sharpiestealr/mono/component pics/motor w.png

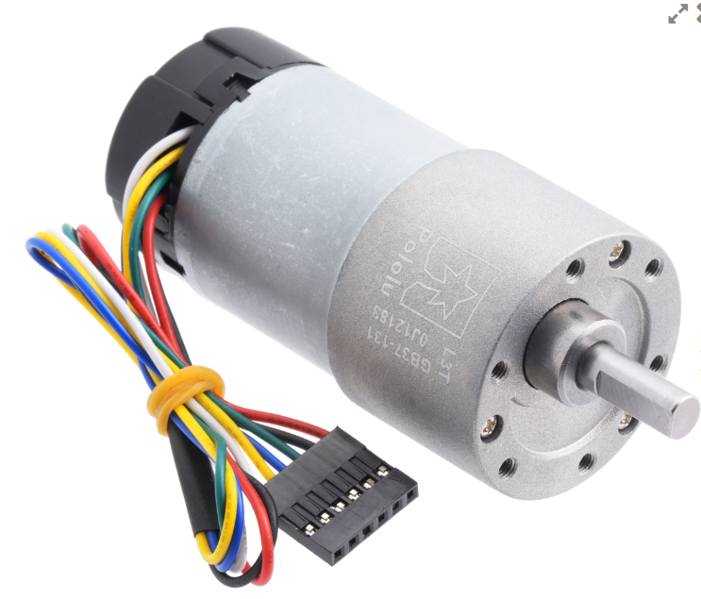
component pics/motor w.png
