sharpiestealr/mono/component pics/imu.png

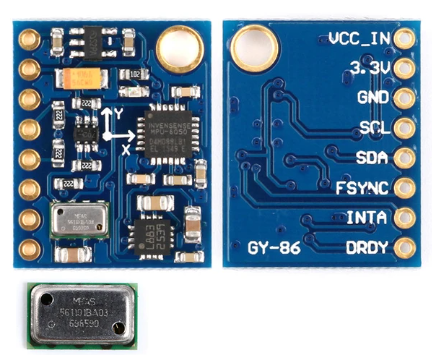
component pics/imu.png
