sharpiestealr/mono/README.md

# mono
matemáticas do menino moço monociclo

:)
