sharpiestealr/mono/cad/mancal interno/1 - faceamento.pdf

### Summary of cutting data for Plain surface

Material details
AISI/SAE, 1045, Hardness: 207 HB, Material group:P1.2.Z.AN

Task details

Operation type | Finishing
System stability | Excellent stability
Width | 3.5 mm
Length | 38.1 mm
Allowance depth of cut bottom | 0.35 mm
Ra bottom | 3.2 µm

Plain surface

Tool | M5009-040-T36-04-06-AP
Type | Body
No. of pieces | 1
Description | Xtratec XT
Image similar
Tool | SNMX1205ANN-F27 WKP35S
Type | Insert periphery (A) INS_A
No. of pieces | 4

Image similar

Machining | Type of cooling | Description | Grade | Tmf [min:s]
Face Milling | Dry | Xtratec XT | WKP35S | 00:01.458

Recommended solution

i-PAC 24-1, Walter GPS 6.7.7 (24.6.0.9476) | 1 From 2 | 7/15/2024

Summary of cutting data for Plain surface

Cutting data

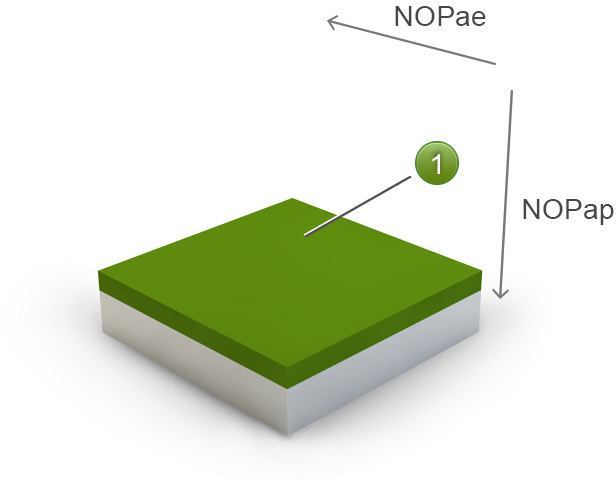
[picture p32: figure]

Working engagement (ae) | 3.5 | mm
Depth of cut (ap) | 0.35 | mm
Number of passes in AE direction (NOPae) | 1
Number of passes in AP direction (NOPap) | 1
Cutting speed (vc) | 348 | m/min
Spindle speed (n) | 2680 | 1/min
Feed per tooth (fz) | 0.3 | mm
Feed speed at the contour (vfe) | 3220 | mm/min
Cutting power (Pc) | 0.339 | kW
Cutting torque (Mc) | 1.21 | Nm
Maximum chip thickness (hex) | 0.0406 | mm
Material removal rate (Q) | 3.94 | cm3/min
Total cutting time (Tc tot) | 00:01.458 | min:s
Tool life length (LifeLength) | 148.28 | m
Tool life time (LifeTime) | 46 | min

Finishing

Legend

i-PAC 24-1, Walter GPS 6.7.7 (24.6.0.9476) | 2 From 2 | 7/15/2024

DECLARATION OF EXCLUSION
The program is used at the user's own risk. Walter AG accepts no guarantee or warranty whatsoever for the suitability of the program or for its efficiency, especially the correctness of the calculations. Walter AG accepts no liability for the trouble- and faultfree use of the program. The risk is borne by the user
Liability of any kind on the part of Walter AG and its employees for damage, detriment and expenditure of any kind, particularly including financial and data losses amongst others, such as may arise for the user or third parties as a result of, or in connection with the use or non-applicability of the program, is ruled out. This exclusion of liability does not apply if and in so far as such damage, detriment and expenditure is found to be due to intentional or grossly negligent behaviour on the part of Walter AG employees.

Summary of cutting data for Plain surface
