sharpiestealr/mono/cad/mancal interno/2 - furação.pdf

### Summary of cutting data for Hole on solid material

Material details
AISI/SAE, 1045, Hardness: 207 HB, Material group:P1.2.Z.AN

Task details

Applicability for through hole | Yes
Diameter | 22 mm
Tolerance class
Depth | 8 mm
System stability | Excellent stability

Hole on solid material

Tool | MC232-16.0W3BC-WJ30ED
Type | Body
No. of pieces | 1
Description | Perform
Image similar
Machining | Type of cooling | Description | Grade | Tmf [min:s]
Pocket milling | Dry | Perform | WJ30ED | 00:10.080

Recommended solution

i-PAC 24-1, Walter GPS 6.7.7 (24.6.0.9476) | 1 From 2 | 7/15/2024

Summary of cutting data for Hole on solid material

Cutting data

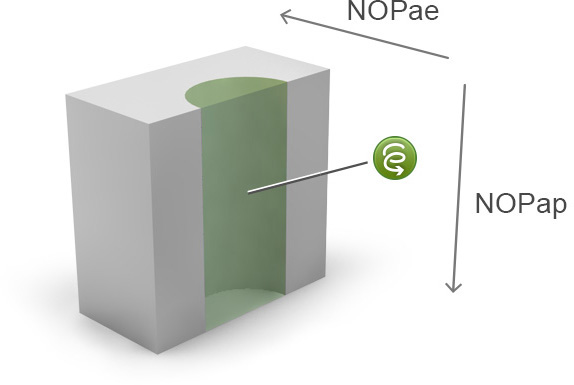
[picture p33: figure]

Working engagement (ae) | 11 | mm
Depth of cut (ap) | 4 | mm
Number of passes in AE direction (NOPae) | 1
Number of passes in AP direction (NOPap) | 2
Start diameter (Dms) | 22 | mm
Effective ramping angle (RMPangle) | 12 | °
Cutting speed (vc) | 169 | m/min
Spindle speed (n) | 3370 | 1/min
Feed per tooth (fz) | 0.0815 | mm
Feed speed at the contour (vfe) | 824 | mm/min
Feed speed in the tool centre (vf) | 225 | mm/min
Cutting power (Pc) | 1.18 | kW
Cutting torque (Mc) | 3.35 | Nm
Maximum chip thickness (hex) | 0.0815 | mm
Material removal rate (Q) | 9.89 | cm3/min
Total cutting time (Tc tot) | 00:10.080 | min:s
Tool life length (LifeLength) | 50.31 | m
Tool life time (LifeTime) | 61 | min

Helical Milling

Legend

i-PAC 24-1, Walter GPS 6.7.7 (24.6.0.9476) | 2 From 2 | 7/15/2024

DECLARATION OF EXCLUSION
The program is used at the user's own risk. Walter AG accepts no guarantee or warranty whatsoever for the suitability of the program or for its efficiency, especially the correctness of the calculations. Walter AG accepts no liability for the trouble- and faultfree use of the program. The risk is borne by the user
Liability of any kind on the part of Walter AG and its employees for damage, detriment and expenditure of any kind, particularly including financial and data losses amongst others, such as may arise for the user or third parties as a result of, or in connection with the use or non-applicability of the program, is ruled out. This exclusion of liability does not apply if and in so far as such damage, detriment and expenditure is found to be due to intentional or grossly negligent behaviour on the part of Walter AG employees.

Summary of cutting data for Hole on solid material
