sharpiestealr/mono/cad/eixo/3 - sangramento.pdf

### Summary of cutting data for Parting of bar

Material details
AISI/SAE, 1045, Hardness: 207 HB, Material group:P1.2.Z.AN

Task details

Start diameter | 25.4 mm
Cutting width | 3 mm
Minimum cutting width | 3 mm
Maximum cutting width | 3 mm
Cutting condition | Continuous cut
Workpiece surface condition | Pre-machined
System stability | Excellent stability

Parting of bar

Subject: monociclo

sangramento

To
eixo

Centur 30D

Machine

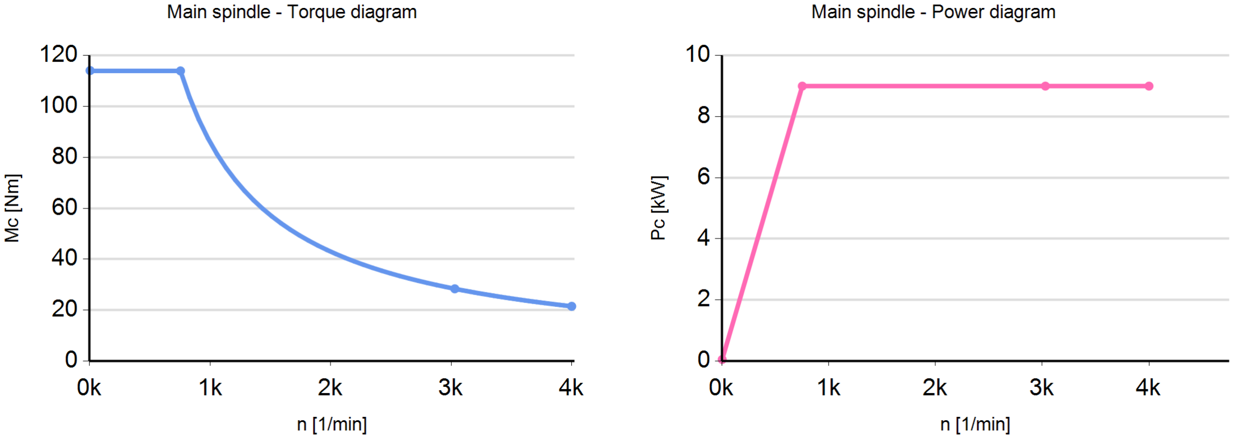
[picture p34: figure]

Machining | Type of cooling | Coolant | Grade | Tmf [min:s] | Adaption type
Parting off | External | Emulsion 10% | | 00:02.814 | Walter parting off and grooving blade -size 26

Recommended solution

i-PAC 23-2, Walter GPS 6.7.5 (24.3.0.8847) | 1 From 2 | 4/12/2024

Summary of cutting data for Parting of bar

Cutting data

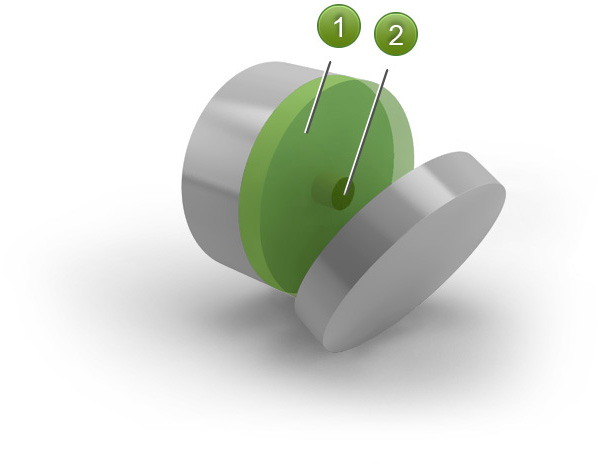
[picture p35: figure]

Number of passes in AP direction (NOPap) | 1 | 1 | NOPap
Start diameter (Dms) | 25.4 | 4.5 | mm
End diameter (Dme) | 4.5 | 0 | mm
Depth of cut (ap) | 3 | 3 | mm
Cutting speed (vc) | 153 | 153 | m/min
Feed per revolution (fn) | 0.116 | 0.029 | mm
Tool life time (LifeTime) | 27 | 68 | min
Tool life length (LifeLength) | 3745.17 | 1920.29 | m
Maximum chip thickness (hex) | 0.116 | 0.116 | mm
Corner radius (R) | 0.2 | 0.2 | mm

### Legend

Parting, recommended feed

Parting, reduced feed

Tool | G2042.26N-3T38SX
Type | Body
No. of pieces | 1

Image similar

Tool | SX-3E300N02-CF6 WSM33S
Type | Insert
No. of pieces | 1
Description | WALTER-Cut
Image similar
i-PAC 23-2, Walter GPS 6.7.5 (24.3.0.8847) | 2 From 2 | 4/12/2024

DECLARATION OF EXCLUSION
The program is used at the user's own risk. Walter AG accepts no guarantee or warranty whatsoever for the suitability of the program or for its efficiency, especially the correctness of the calculations. Walter AG accepts no liability for the trouble- and faultfree use of the program. The risk is borne by the user
Liability of any kind on the part of Walter AG and its employees for damage, detriment and expenditure of any kind, particularly including financial and data losses amongst others, such as may arise for the user or third parties as a result of, or in connection with the use or non-applicability of the program, is ruled out. This exclusion of liability does not apply if and in so far as such damage, detriment and expenditure is found to be due to intentional or grossly negligent behaviour on the part of Walter AG employees.

Summary of cutting data for Parting of bar
