sharpiestealr/mono/cad/peça acopladora/3 - rebaixo 6.5.pdf

### Summary of cutting data for Hole on solid material

Material details
JIS, A5052, Hardness: 55 HB, Material group:N1.2.Z.UT

Task details

Applicability for through hole | Yes
Diameter | 6.5 mm
Tolerance class
Depth | 3.5 mm
System stability | Excellent stability

Hole on solid material

Subject: monociclo

fresamento do rebaixo 6xm3

To
peça acopladora

FANUC RoboDRILL -21MiB (High Torque)

Machine

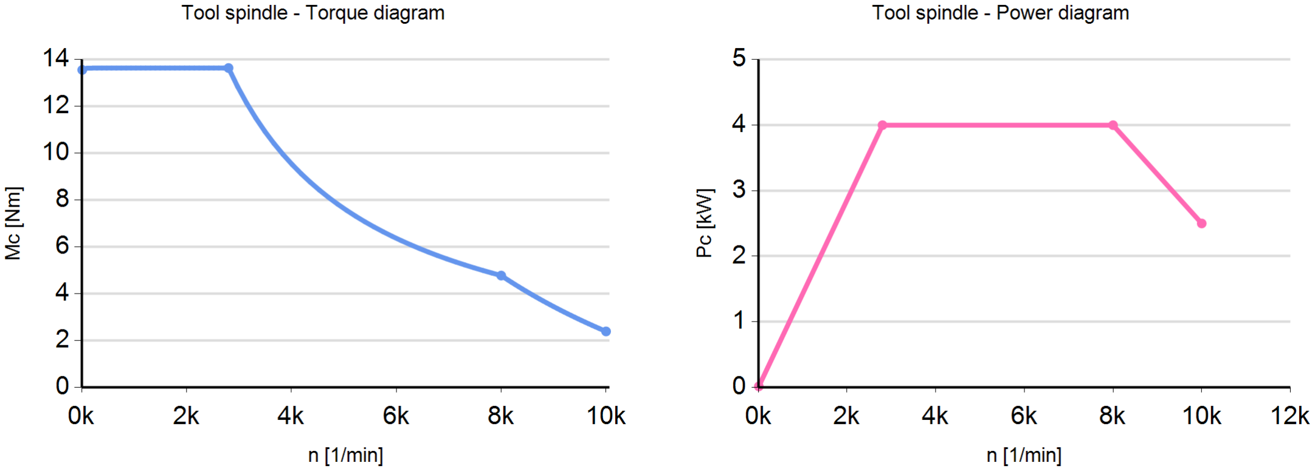
[picture p36: figure]

Tool | MC232-04.0A3B-WJ30ED
Type | Body
No. of pieces | 1
Description | Perform
Image similar
Machining | Type of cooling | Coolant | Description | Grade | Tmf [min:s]
Pocket milling | External | Emulsion 10% | Perform | WJ30ED | 00:01.860

Recommended solution

i-PAC 23-2, Walter GPS 6.7.5 (24.3.0.8847) | 1 From 3 | 4/12/2024

Summary of cutting data for Hole on solid material

MC232-04.0A3B-WJ30ED

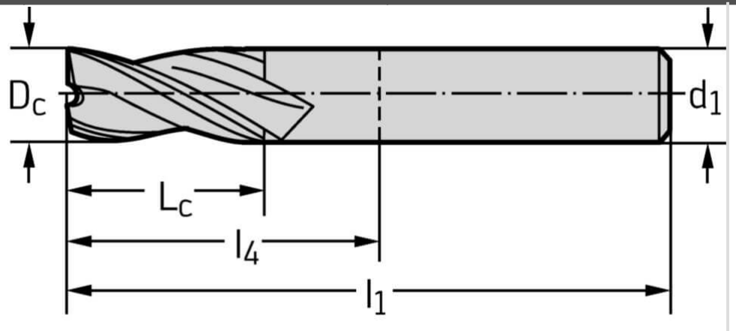
[picture p37: figure]

Product name | Perform
Standard | DIN 6527 L
Body material | Carbide
Grade | WJ30ED
Center cutting capability | true
Helix angle | 35 °
Cutting edge diameter (Dc) | 4 mm
Cutting edge diameter tolerance class | h12
Max. depth of cut (Lc) | 8 mm
Usable length (l3) | 8 mm
Overall length (l1) | 57 mm
Maximum overhang (l4) | 29 mm
Drive size (d1) | 4
Shank diameter tolerance | h6
Peripheral effective cutting edge count (Z) | 3
Calculated regrinds | 2
Price | 38.90 €
i-PAC 23-2, Walter GPS 6.7.5 (24.3.0.8847) | 2 From 3 | 4/12/2024

Cutting data


Working engagement (ar) | 3.25 | mm
Depth of cut (ap) | 1.75 | mm
Number of passes in AE direction (NOPae) | 1 | NOPae
Number of passes in AP direction (NOPap) | 2 | NOPap
Start diameter (Dms) | 6.5 | mm
Effective ramping angle (RMPangle) | 12.6 | °
Cutting speed (vc) | 120 | m/min
Spindle speed (n) | 9550 | 1/min
Feed per tooth (fz) | 0.046 | mm
Feed speed at the contour (vfe) | 1320 | mm/min
Feed speed in the tool centre (vf) | 507 | mm/min
Cutting power (Pc) | 0.0886 | kW
Cutting torque (Mc) | 0.0886 | Nm
Maximum chip thickness (hex) | 0.046 | mm
Material removal rate (Q) | 2.88 | cm3/min
Total cutting time (Tc tot) | 00:01.860 | min:s
Tool life length (LifeLength) | 739.08 | m
Tool life time (LifeTime) | 560 | min

Helical Milling

Legend

i-PAC 23-2, Walter GPS 6.7.5 (24.3.0.8847) | 3 From 3 | 4/12/2024

DECLARATION OF EXCLUSION
The program is used at the user's own risk. Walter AG accepts no guarantee or warranty whatsoever for the suitability of the program or for its efficiency, especially the correctness of the calculations. Walter AG accepts no liability for the trouble- and fault-free use of the program. The risk is borne by the user
Liability of any kind on the part of Walter AG and its employees for damage, detriment and expenditure of any kind, particularly including financial and data losses amongst others, such as may arise for the user or third parties as a result of, or in connection with the use or non-applicability of the program, is ruled out. This exclusion of liability does not apply if and in so far as such damage, detriment and expenditure is found to be due to intentional or grossly negligent behaviour on the part of Walter AG employees.
