sharpiestealr/mono/cad/peça acopladora/4 - furo 12.pdf

### Summary of cutting data for Hole on solid material

Material details
JIS, A5052, Hardness: 55 HB, Material group:N1.2.Z.UT

Task details

Applicability for through hole | Yes
Diameter | 12 mm
Tolerance class
Depth | 10 mm
System stability | Excellent stability

Hole on solid material

Subject: monociclo

fresamento furo 12mm

To
peça acopladora

FANUC RoboDRILL -21MiB (High Torque)

Machine


Tool | MC232-10.0W3BC-WJ30ED
Type | Body
No. of pieces | 1
Description | Perform
Image similar
Machining | Type of cooling | Coolant | Description | Grade | Tmf [min:s]
Pocket milling | External | Emulsion 10% | Perform | WJ30ED | 00:02.928

Recommended solution

i-PAC 23-2, Walter GPS 6.7.5 (24.3.0.8847) | 1 From 3 | 4/12/2024

Summary of cutting data for Hole on solid material

MC232-10.0W3BC-WJ30ED

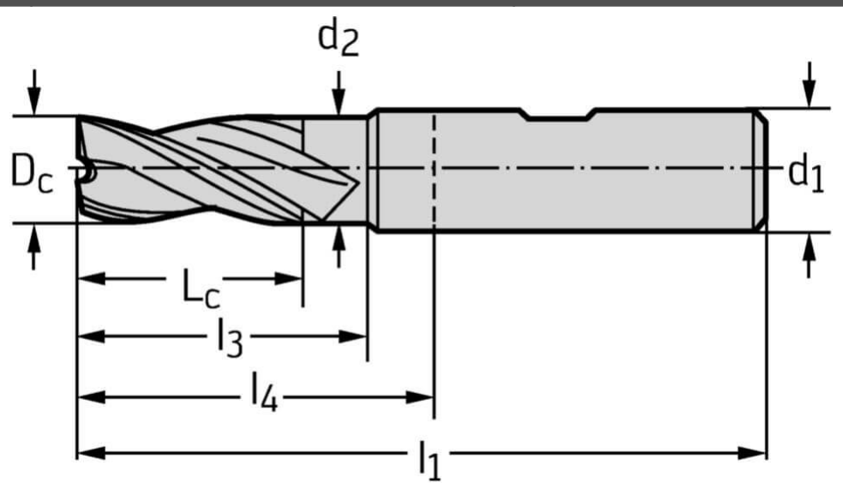
[picture p38: figure]

Product name | Perform
Standard | DIN 6527 L
Body material | Carbide
Grade | WJ30ED
Center cutting capability | true
Helix angle | 35 °
Cutting edge diameter (Dc) | 10 mm
Cutting edge diameter tolerance class | h12
Corner chamfer width (l11) | 0.1 mm
Corner chamfer | 45 °
Max. depth of cut (Lc) | 19 mm
Usable length (l3) | 30 mm
Neck diameter (d2) | 9.5 mm
Overall length (l1) | 72 mm
Maximum overhang (l4) | 32 mm
Drive size (d1) | 10
Shank diameter tolerance | h6
Peripheral effective cutting edge count (Z) | 3
Calculated regrinds | 3
Price | 77.10 €
i-PAC 23-2, Walter GPS 6.7.5 (24.3.0.8847) | 2 From 3 | 4/12/2024

Cutting data


Working engagement (ar) | 6 | mm
Depth of cut (ap) | 2 | mm
Number of passes in AE direction (NOPae) | 1 | NOPae
Number of passes in AP direction (NOPap) | 5 | NOPap
Start diameter (Dms) | 12 | mm
Effective ramping angle (RMPangle) | 17.7 | °
Cutting speed (vc) | 314 | m/min
Spindle speed (n) | 10000 | 1/min
Feed per tooth (fz) | 0.129 | mm
Feed speed at the contour (vfe) | 3860 | mm/min
Feed speed in the tool centre (vf) | 643 | mm/min
Cutting power (Pc) | 0.487 | kW
Cutting torque (Mc) | 0.465 | Nm
Maximum chip thickness (hex) | 0.129 | mm
Material removal rate (Q) | 7.72 | cm3/min
Total cutting time (Tc tot) | 00:02.928 | min:s
Tool life length (LifeLength) | 891.76 | m
Tool life time (LifeTime) | 230 | min

Helical Milling

Legend

i-PAC 23-2, Walter GPS 6.7.5 (24.3.0.8847) | 3 From 3 | 4/12/2024

DECLARATION OF EXCLUSION
The program is used at the user's own risk. Walter AG accepts no guarantee or warranty whatsoever for the suitability of the program or for its efficiency, especially the correctness of the calculations. Walter AG accepts no liability for the trouble- and fault-free use of the program. The risk is borne by the user
Liability of any kind on the part of Walter AG and its employees for damage, detriment and expenditure of any kind, particularly including financial and data losses amongst others, such as may arise for the user or third parties as a result of, or in connection with the use or non-applicability of the program, is ruled out. This exclusion of liability does not apply if and in so far as such damage, detriment and expenditure is found to be due to intentional or grossly negligent behaviour on the part of Walter AG employees.
