sharpiestealr/mono/cad/peça acopladora/5 - faceamento de baixo.pdf

### Summary of cutting data for Plain surface

Material details
JIS, A5052, Hardness: 55 HB, Material group:N1.2.Z.UT

Task details

Operation type | Pre-machining and finishing
System stability | Excellent stability
Depth | 20 mm
Width | 40 mm
Length | 40 mm
Rz bottom | 5 µm
Cutting edge diameter | 64 mm

Plain surface

Subject: monociclo

faceamento - desbaste e acabamento FACE DE BAIXO PRA ARRANCAR TUDO

To
peça acopladora

FANUC RoboDRILL -21MiB (High Torque)

Machine


Machining | Type of cooling | Coolant | Description | Grade | Tmf [min:s]
Face Milling | External | Emulsion 10% | Xtratec XT | WK10 | 00:19.140

Recommended solution

i-PAC 23-2, Walter GPS 6.7.5 (24.3.0.8847) | 1 From 4 | 4/12/2024

Summary of cutting data for Plain surface

M5009-050-B22-04-06-AP

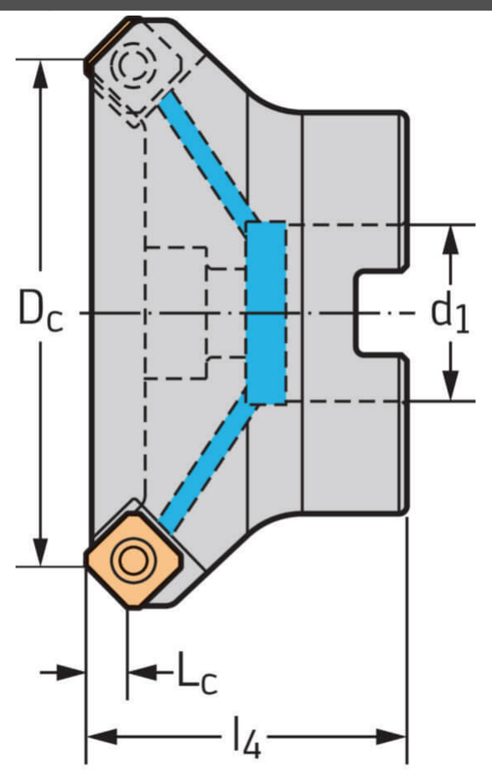
[picture p39: figure]

Approach angle () | 45 °
Cutting edge diameter (Dc) | 50 mm
Max. cutting edge diameter (Da) | 64 mm
Drive size (d1) | 22
Maximum overhang (l4) | 40 mm
Max. depth of cut (Lc) | 6 mm
Peripheral effective cutting edge count (Z) | 4
Weight | 0.608 kg
Cutting item count | 4
Maximum ramping angle | 0 °
Price | 780.00 €
Tool | M5009-050-B22-04-06-AP
Type | Body
No. of pieces | 1
Description | Xtratec XT
Image similar
Tool | SNHX1205ANN-K88 WK10
Type | Insert periphery (A) INS_A
No. of pieces | 4

Image similar

i-PAC 23-2, Walter GPS 6.7.5 (24.3.0.8847) | 2 From 4 | 4/12/2024

SNHX1205ANN-K88 WK10

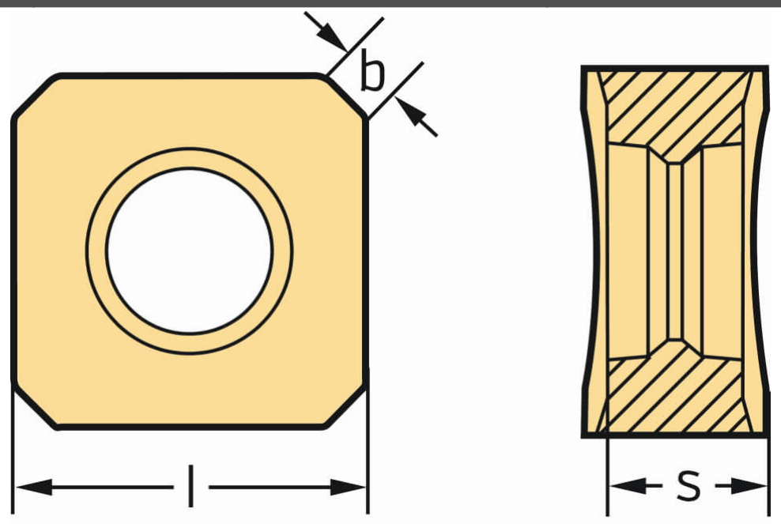
[picture p40: figure]

Tolerance class insert | H
No. of corners | 4
Number of sides | double sided
Cutting edge length (l) | 12.7 mm
Insert thickness (s) | 5.54 mm
Clearance angle major () | 0 °
Corner radius (r) | 0.8 mm
Wiper edge length (b) | 1.5 mm
Price | 28.90 €
i-PAC 23-2, Walter GPS 6.7.5 (24.3.0.8847) | 3 From 4 | 4/12/2024

Cutting data

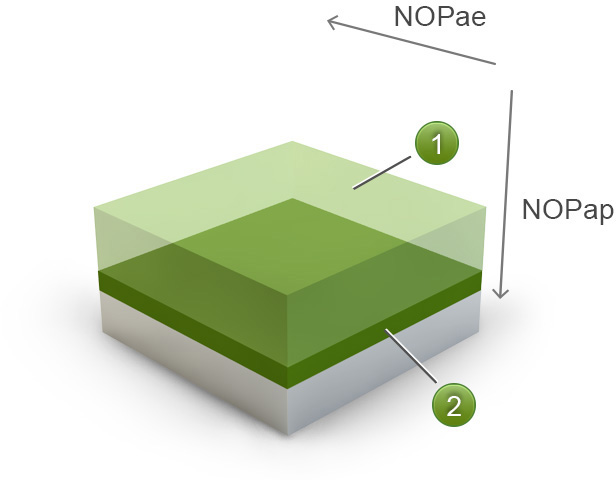
[picture p41: figure]

Working engagement (ar) | 40 | 40 | mm
Depth of cut (ap) | 0.557 | 0.5 | mm
Number of passes in AE direction (NOPae) | 1 | 1 | NOPae
Number of passes in AP direction (NOPap) | 35 | 1 | NOPap
Cutting speed (vc) | 1500 | 1620 | m/min
Spindle speed (n) | 9220 | 9980 | 1/min
Feed per tooth (fz) | 0.232 | 0.185 | mm
Feed speed at the contour (vfe) | 8560 | 7390 | mm/min
Cutting power (Pc) | 2.65 | 2.16 | kW
Cutting torque (Mc) | 2.74 | 2.07 | Nm
Maximum chip thickness (hex) | 0.164 | 0.131 | mm
Material removal rate (Q) | 191 | 148 | cm3/min
Total cutting time (Tc tot) | 00:15.960 | 00:00.732 | min:s
Total non-cutting time (Tnc tot) | 00:02.454 | 00:00.000 | min:s
Tool life length (LifeLength) | 3030.02 | 1840.07 | m
Tool life time (LifeTime) | 350 | 250 | min

Premachining

Finishing

Legend

i-PAC 23-2, Walter GPS 6.7.5 (24.3.0.8847) | 4 From 4 | 4/12/2024

DECLARATION OF EXCLUSION
The program is used at the user's own risk. Walter AG accepts no guarantee or warranty whatsoever for the suitability of the program or for its efficiency, especially the correctness of the calculations. Walter AG accepts no liability for the trouble- and fault-free use of the program. The risk is borne by the user
Liability of any kind on the part of Walter AG and its employees for damage, detriment and expenditure of any kind, particularly including financial and data losses amongst others, such as may arise for the user or third parties as a result of, or in connection with the use or non-applicability of the program, is ruled out. This exclusion of liability does not apply if and in so far as such damage, detriment and expenditure is found to be due to intentional or grossly negligent behaviour on the part of Walter AG employees.
