sharpiestealr/mono/studying/Estimador de Estado e Filtro de Kalman.pdf

## Estimador de Estado e Filtro de Kalman

Fábio S. El Hage

É comum na engenharia que saibamos modelar um sistema físico a partir de equações diferenciais, as quais descrevem o comportamento do sistema no tempo. Também é corriqueiro que possamos obter medições sobre esse mesmo sistema por meio de sensores, os quais podem medir variáveis como temperatura, pressão, posição, velocidade, aceleração etc.

Duas questões fundamentais surgem quando podemos estimar e, ao mesmo tempo, medir variáveis no tempo (chamadas de estados de um sistema): i) quando há diferenças entre a estimativa e a medição, em qual delas confiar? ii) quando há uma ou mais variáveis não medidas (estados não mensuráveis), seja por falta de sensores ou pela impossibilidade física de medi-las, a medição das variáveis mensuráveis pode ajudar a melhorar a estimativa de variáveis não mensuráveis? Para responder a ambas as perguntas, lançaremos mão de um processo denominado estimador de estado e, em seguida, abordaremos um estimador de estados especial, muito conhecido na engenharia por Filtro de Kalman.

Em resumo, um estimador de estados pode ser definido como um processo matemático recursivo, que tem por função determinar um ou mais estados de um sistema ao longo do tempo, “fundindo” estimativas de um modelo matemático e medições de alguns estados, o que tornará a estimativa de cada estado a mais precisa possível. Para compreender esse processo, assim como o Filtro de Kalman, lançaremos mão de um exemplo bastante intuitivo: um carro acelerando em uma pista.

### Sistema Físico com equações diferenciais lineares

Consideremos o seguinte sistema físico simplificado: um carro de massa m que acelera para a direita em uma pista, sendo a força propulsora F constante. Nesta primeira versão de nosso sistema, que é irreal, também vamos desprezar a resistência do ar.

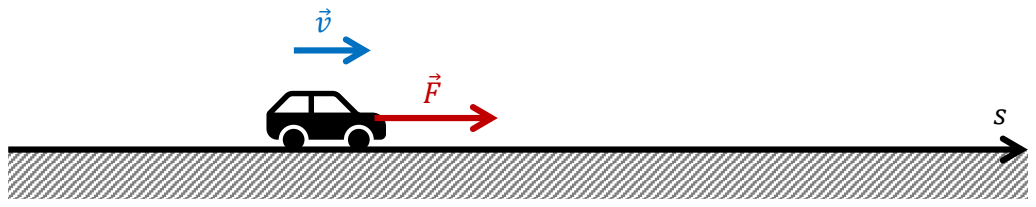
[picture p43: figure]

Sendo F a única força que age no carro, podemos escrever as seguintes equações diferenciais do movimento:

ds
dt = v

dv
dt =

F
m

Usando o método de Euler, podemos discretizar as equações diferenciais usando as seguintes equações a diferenças:

s(t + Δt) = s(t) + v(t) ⋅ Δt

v(t + Δt) = v(t) +

F
m

⋅ Δt

Para implementarmos a solução numérica dessas equações a diferenças, vamos substituir o instante de tempo t pelo contador k, sendo t = kΔt.

sk+1 = sk + vk ⋅ Δt

vk+1 = vk +

F
m

⋅ Δt

As equações do sistema acima podem ser reescritas na forma matricial:

[

sk+1
vk+1

] = [

1 Δt
0 1

][

sk
vk

] + [

0
Δt
m

]F

Comumente, expressa-se a equação acima usando-se uma simbologia compacta, como na equação abaixo.

Xk+1 = AXk + Bu

Na equação, Xk+1 = [

sk+1
vk+1

], Xk = [

sk
vk

], A = [

1 Δt
0 1

], B = [

0
Δt
m

] e u = F.

Vamos ainda supor que, neste sistema, possamos medir apenas a variável sk (a posição do carro), de modo que a medição yk seja:

yk = [1 0][

sk
vk

]

A matriz [1 0] é denominada matriz C. Deste modo, podemos representar o sistema na forma matricial:

Xk+1 = AXk + Bu

yk = CXk

Cujo diagrama pode ser representado a seguir, sendo uk a entrada e yk a saída do sistema (variável medida).

Simulando esse sistema físico simplificado e idealizado, podemos encontrar a saída y(t), que é igual ao espaço percorrido s(t), conforme ilustra a figura a seguir. Perceba que esse sistema físico é determinístico, resultando em uma esperada função parabólica de s(t), uma vez que se trata de um movimento uniformemente acelerado.

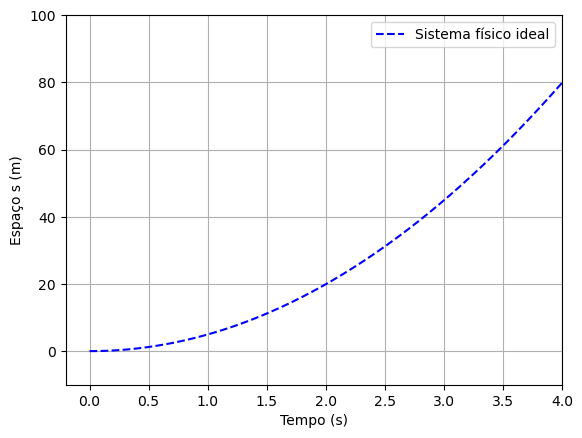
[picture p44: figure]

Contudo, sabemos que um sistema físico mais realista está sujeito a ruídos de dois tipos:

- Ruídos de processos
- Ruídos de medição

Em linha com o processo de estimação denominado Filtro de Kalman, o qual veremos a seguir, considera-se que ambos os ruídos são ruídos brancos gaussianos, o que significa dizer que são valores sequenciais aleatórios não correlacionados no tempo, tendo média zero e variância finita. Assim, vamos atualizar nosso sistema físico adicionando ambos os ruídos nas equações que o descrevem. Observe o diagrama a seguir.

No novo sistema físico, wk é a variável proveniente de um sorteio, a cada passo da iteração, com distribuição normal de média zero e desvio σw. Por sua vez, vk é uma variável gerada pelo sorteio com distribuição normal de média zero e desvio padrão σy. Fazendo uma nova simulação do sistema físico, agora considerando os ruídos supracitados, sendo adotados σw = [

0,0001
0,01 ] (na forma matricial, significa que 0,0001 é o desvio padrão

do espaço e 0,01 o da velocidade a cada passo k) e σy = 2 (desvio padrão da medição), obteremos um resultado não determinístico (dito estocástico).

Xk+1 = AXk + Bu

yk = Cxk

uk | yk

Sistema físico determinístico

Xk+1 = AXk + Bu + wk

yk = Cxk + vk

uk | yk

Sistema físico

Em relação aos desvios do ruído de processo, faz sentido adotar um desvio para a posição bem menor que o da velocidade, pois a variação da posição depende apenas da velocidade no instante anterior. Já a variação da velocidade depende de distúrbios externos (forças), como imperfeições no asfalto, declives, vento etc. O desvio da medição y, por sua vez, é bem maior que os desvios dos ruídos de processo, indicando que os sensores de posição têm erros de medição mais significativos (por exemplo, o erro de posição de um sistema GPS é da ordem de metros).

A figura a seguir ilustra a simulação do sistema físico não determinístico (estocástico). Note que estamos emulando um sistema físico a partir do qual faríamos medições da posição no tempo, ou seja, com propósitos didáticos, estamos criando um sistema “real” em computador, sabendo que, no uso prático dos estimadores ou do Filtro de Kalman, teríamos apenas as medições proveniente desse sistema.

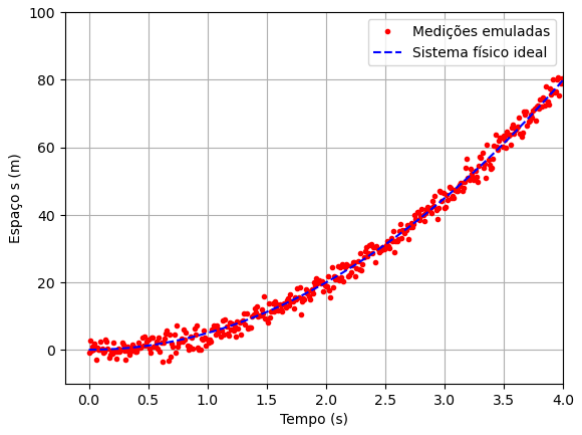
[picture p45: figure]

### Estimador de estado em malha aberta

Temos agora condições de propor o desenho de um estimador de estado, que será desenhado para estimar os estados (posição e velocidade) do sistema físico criado. Como conhecemos o sistema, sabemos descrevê-lo em equações diferenciais e a diferenças (discretizadas). Ressalta-se uma vez mais que, no mundo real, não precisaríamos emular um modelo físico, apenas obter dele as medições necessárias). Tratando-se do sistema físico descrito, as equações do modelo matemático serão exatamente as mesmas usadas na emulação do sistema. Assim, considere o seguinte diagrama de blocos.

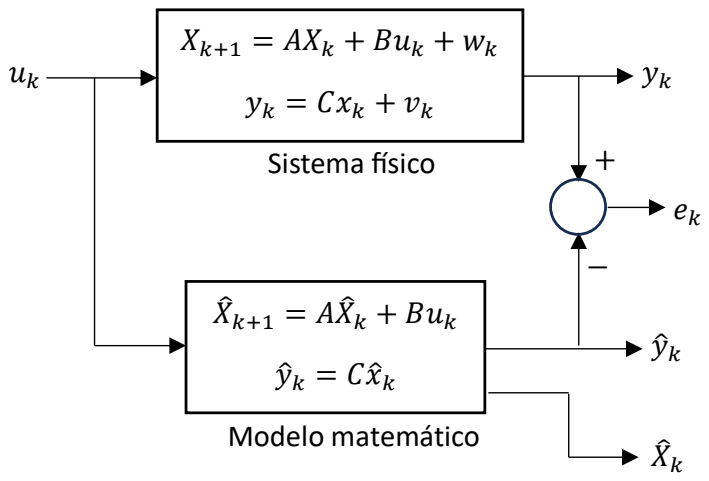
[picture p46: figure]
Xk+1 = AXk + Buk + wk; yk = Cxk + vk; Sistema físico; k+1 = AX̂ k + Buk; Modelo matemático

Note que agora os estados estimados do sistema são representados por X̂
k, enquanto o real estado continua sendo Xk. Quando comparamos a medição yk com a estimativa ŷk, podemos calcular o erro entre a estimativa e a medição, denominado ek. Ou seja:

ek = yk − ŷk

Para o exemplo do sistema físico do carro acelerando com força constante, os erros obtidos pela simulação são observados no gráfico da direita, a seguir. Note que os erros não têm média zero, o que indica um viés na estimativa quando comparada às medições¹.

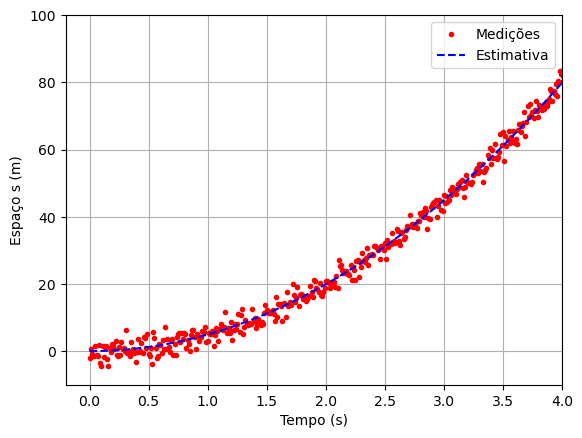
[picture p47: figure]
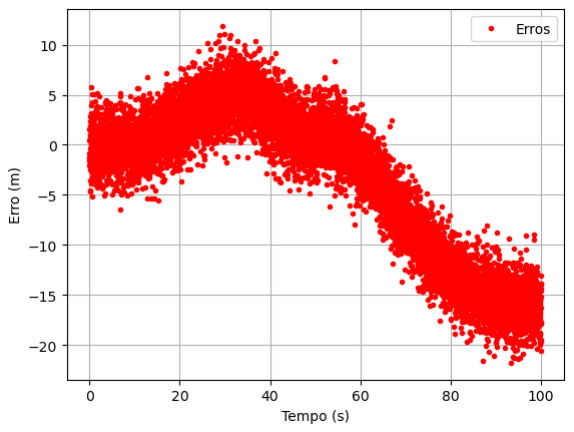
[picture p48: figure]

Seria muito interessante que esses erros convergissem para uma média igual a zero, eliminando o viés da estimativa, o que faremos na próxima sessão. Antes de analisarmos o estimador em malha fechada, é importante notar que o estimador em malha aberta depende sobremaneira do estado inicial do sistema. Imaginemos que, por um erro, o estimador iniciasse com estados ŝ(0) = 100 m e v̂(0) = 10 m/s, enquanto o sistema físico (o carro real) partisse do repouso (v(0) = 0) e do ponto s(0) = 0. Os gráficos a seguir ilustram a diferença de viés entre a estimativa e as medições, o que não pode ser corrigido ao longo do processo, a menos que reiniciemos o modelo matemático com valores iniciais próximos à medição.

1 Medições aqui são geradas pela simulação do “sistema físico”

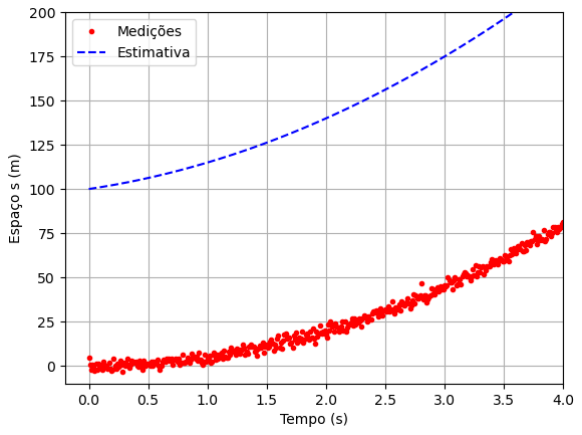
[picture p49: figure]

### Estimador de estado em malha fechada

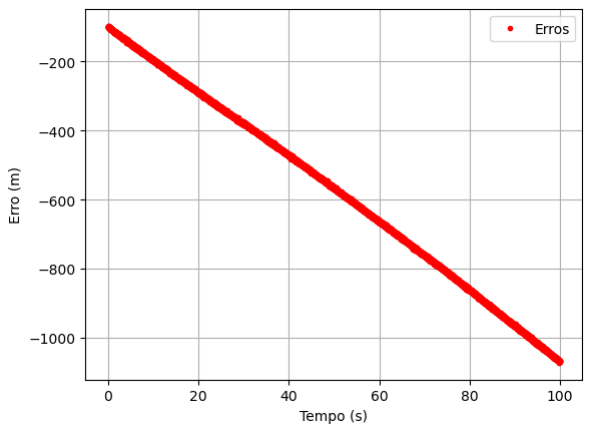
[picture p50: figure]

Partindo do estimador de estado em malha aberta, mas agora usando os próprios erros para calcular as estimativas dos estados Xk (no caso, a posição e a velocidade), podemos alterar a dinâmica do modelo matemático. Observe o diagrama da figura a seguir.

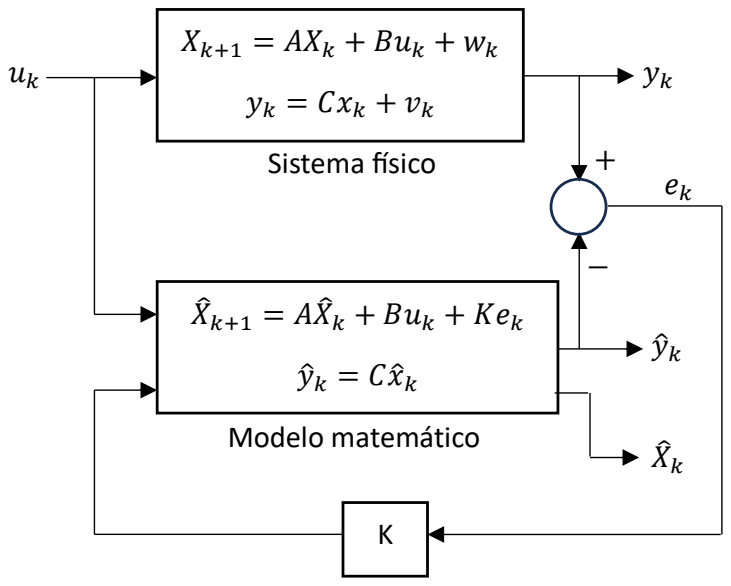
[picture p51: figure]
Xk+1 = AXk + Buk + wk; yk = Cxk + vk; Sistema físico; k+1 = AX̂ k + Buk + Kek; Modelo matemático

Alteramos o modelo matemático para que a estimativa dos próximos estados dependesse não somente da dinâmica do sistema (dada pelo modelo matemático), mas também dos erros entre a estimativa ŷk e a medição yk, multiplicados por um ganho K (por ora, um número constante e arbitrário). Matematicamente, podemos escrever:

X̂

k+1 = AX̂
k + Buk + K(yk − ŷk

)

Como o sistema físico pode ser descrito por:

Xk+1 = AXk + Buk + wk

Subtrairemos a segunda equação da primeira, obtendo:

Xk+1 − X̂

k+1 = A(Xk − X̂
k) − K(yk − ŷk
) + wk

Como yk = CXk e ŷk = CX̂
k, podemos escrever:

Xk+1 − X̂

k+1 = A(Xk − X̂

k) − K(CXk − CX̂
k) + wk

Xk+1 − X̂

k+1 = (A − KC)(Xk − X̂
k) + wk

Ek+1 = (A − KC)Ek + wk

Na equação acima, Ek representa o erro de estimação dos estados, pois é a subtração de Xk e X̂
k. Como C =
[1 0], a subtração das matrizes A − KC resultará em uma matriz Ã cujos elementos da primeira coluna são subtraídos do valor K. Ao adotarmos 0 < K < 1, teremos uma condição na qual os erros Ek+1 serão sempre menores do que os erros Ek, o que fará com que a sequência de erros de estado convirja para zero, resultado muito desejado em um estimador de estados. O termo wk não interferirá na dinâmica de convergência do erro por tratar-se de um ruído com distribuição gaussiana de média zero (ruído branco).

Simulando o estimador de estados em malha fechada com valores de K entre 0,1 e 0,9, observamos que, mesmo iniciando o estimador em posição e velocidade muito diferentes das medições iniciais do sistema físico (ŝ(0) = 100m e v̂(0) = 10m/s), ao longo do tempo as estimativas de ŝ(t) convergem para os valores medidos.

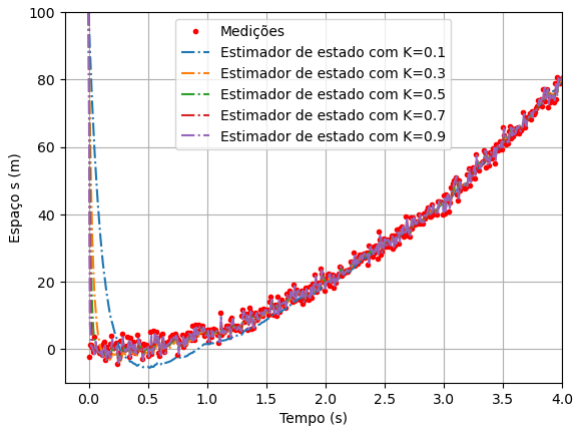
[picture p52: figure]

Note, no gráfico da figura a seguir, com K = 0,1, que os erros ek convergem para média zero, restando apenas a variabilidade relativa aos erros de processo e medição.

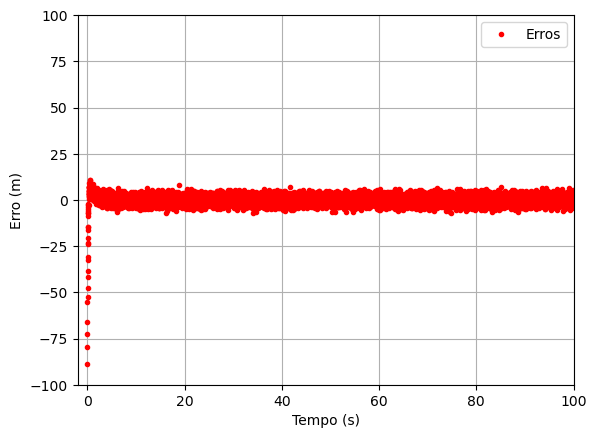
[picture p53: figure]

Por fim, no gráfico a seguir é plotada a estimativa da velocidade em comparação à velocidade calculada pelo modelo determinístico. Note que é necessário um certo tempo para que a velocidade estimada convirja para a velocidade medida. O algoritmo garante, contudo, que os erros tenderão a zero ao longo do tempo, o que comprova a eficácia do processo para estimar variáveis não mensuráveis (caso da velocidade no exemplo utilizado).

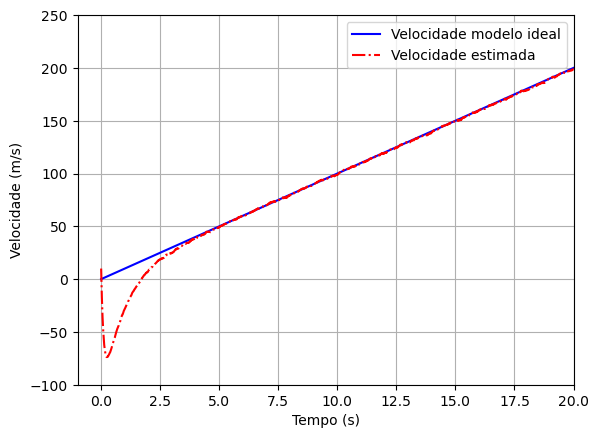
[picture p54: figure]

Uma forma de analisar o estimador em malha fechada é reexaminar os termos da equação do modelo:

X̂

k+1 = AX̂
k + Buk + K(yk − ŷk

)

Como ŷk = CX̂
k, a equação pode ser reescrita na forma:

X̂

k+1 = AX̂

k + Buk + Kyk − KCX̂
k

Que resulta em:

X̂

k+1 = (A − CK)X̂
k + Buk + Kyk

Supondo que o ganho K = 1, teríamos:

X̂

k+1 = (A − C)X̂
k + Buk + yk

Como C é uma matriz com zeros e uns (no caso do sistema em análise, C = [1 0]), subtrair 1 na primeira coluna da matriz A significa zerar o termo ŝk a cada passo k, ou seja, zerar o espaço estimado pelo modelo. Ao mesmo tempo, o termo yk, que é a medição no instante k, é usada integralmente na estimativa do próximo estado X̂
k+1. Se o ganho K = 0, o contrário ocorre, ou seja, o próximo estado desconsiderará completamente a medição yk, estimando X̂

k+1 a partir de X̂
k. Concluímos, assim, que 0 < K < 1 resultará em uma combinação de estimativa e medição a cada passo, fundindo ambos os valores na estimativa do passo seguinte.

### Filtro de Kalman

O Filtro de Kalman, também conhecido por estimador quadrático linear, é um algoritmo muito parecido com o estimador de estados introduzido na sessão anterior, porém com uma diferença: o ganho K, agora uma matriz com dois elementos, é ajustado a cada iteração k. Assim como no estimador de estados em malha fechada, o Filtro de Kalman usa medições observadas ao longo do tempo, que incluem ruídos de processo e de medição, produzindo estimativas de variáveis desconhecidas de modo otimizado. O filtro recebeu o nome por conta dos trabalhos de Rudolf E. Kálmán, um engenheiro elétrico, matemático húngaro-americano.

Está além do escopo deste texto demonstrar que o processo denominado Filtro de Kalman minimiza os erros quadráticos entre estimativa e medição. Focaremos na sua implementação, analisando seus resultados. O processo de estimação é recursivo, assim como no caso do estimador de estados, porém é comum analisá-lo por meio da divisão do processo em duas etapas: predição dos estados e atualização dos estados. Observe o algoritmo descrito a seguir, que será também aplicado ao sistema do carro acelerando.

Predição

X̂

k̅ = AX̂
k−1 + Buk

Pk̅ = APk−1A

T + Q

Atualização

Kk = Pk̅C

T(CPk̅C

T + R)

−1

X̂

k = X̂

k̅ + Kk(yk − CX̂
k̅ )

Pk = (I − KkC)Pk̅

Note que a primeira linha da etapa de predição é idêntica à estimação do modelo matemático no estimador de estados. No filtro de Kalman, a matriz P é denominada “matriz de covariância”, e será atualizada recursivamente levando em consideração o ganho Kk, que varia ao longo do tempo. Q é a matriz de covariância dos erros de processo, sendo definida por:

Q = [
σw1
2 | 0
0 | σw2
| 2

]

Na matriz acima, σw1 é o desvio padrão do erro do primeiro estado (no caso de nosso exemplo, o espaço) e σw2 é o desvio padrão do segundo estado (a velocidade). Por sua vez, R = σy

2
, sendo σy o desvio padrão do erro de medição.

Note, na sequência, que parte da etapa atualização já é conhecida:

X̂

k = X̂

k̅ + Kk(yk − CX̂
k̅ )

Denominamos X̂

k̅ a matriz de estados previstos na etapa de predição, enquanto X̂ k representa a matriz dos
estados estimados com base tanto na predição como nas medições, usando um ganho Kk. O algoritmo garante que os ganhos Kk minimizarão os erros quadráticos entre a medição e a estimativa ao longo do tempo.

Observe o resultado da implementação do Filtro de Kalman para condições de predição iniciais distantes dos valores iniciais medidos (como no caso do estimador de malha fechada, adotamos ŝ(0) = 100m e v̂(0) = 10m/s.

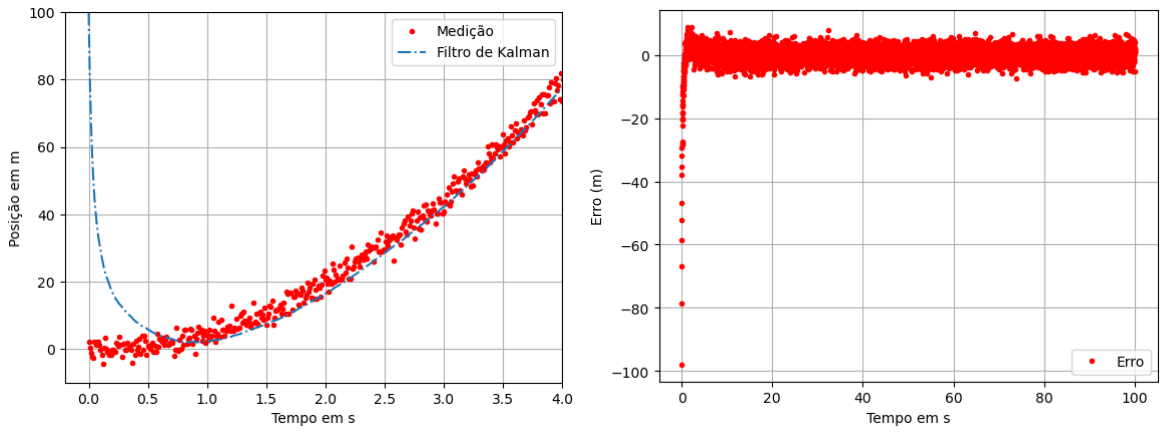
[picture p55: figure]

O gráfico da figura seguinte ilustra a estimativa da velocidade comparada à velocidade calculada pelo modelo ideal, determinístico. Em comparação ao processo do estimador em malha fechada, percebemos que a convergência é mais rápida.

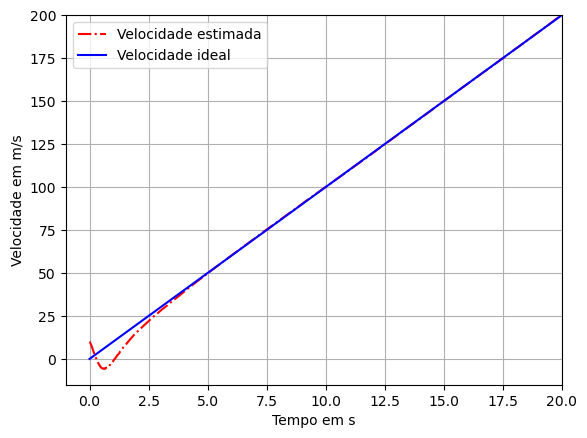
[picture p56: figure]

O gráfico a seguir representa a evolução da matriz do ganho K ao longo do tempo. É possível observar que ambos os elementos da matriz (ganho da posição e da velocidade) convergem para valores constantes.

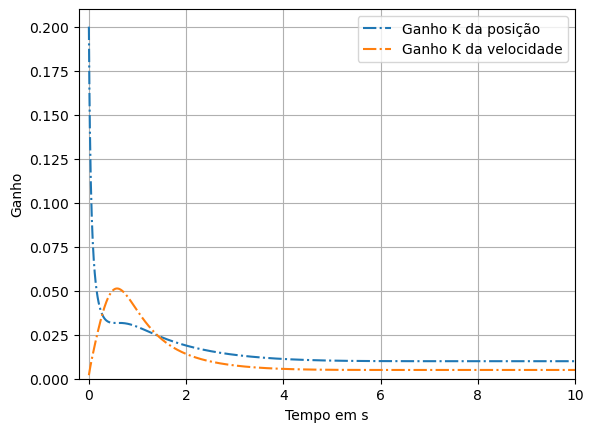
[picture p57: figure]

Implementamos o estimador de estados em malha fechada e o Filtro de Kalman para um problema cujas equações diferenciais são lineares, ou seja, dependem das próprias variáveis de integração de maneira linear. Contudo, a maioria dos sistemas reais têm equações diferenciais não lineares, para os quais poderemos lançar mão do estimador de estados não linear e do Filtro de Kalman Estendido. Ambos serão tratados nas próximas sessões.

### Sistema Físico com equações diferenciais não lineares

Consideremos agora o seguinte sistema físico: um carro de massa m que acelera para a direita em uma pista com força propulsora constante e sujeito à resistência do ar, cuja função pode ser representada por 0,4v

2

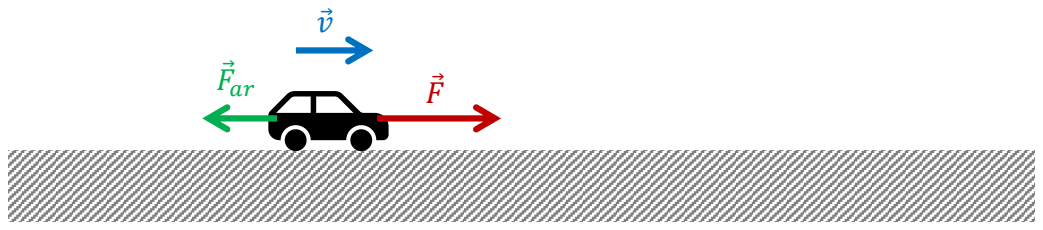
[picture p58: figure]

Podemos expressar a resultante R por:

R = F − 0,4v

2

Assim, podemos escrever as seguintes equações diferenciais do movimento:

ds
dt = v

dv
dt =

F
m

−

0,4
m

v

2

Usando o método de Euler, podemos discretizar as equações diferenciais usando as seguintes equações a diferenças:

s(t + Δt) = s(t) + v(t) ⋅ Δt

v(t + Δt) = v(t) + (

F
m

− 0,4v(t)

2) ⋅ Δt

Para implementarmos a solução numérica dessas equações a diferenças, vamos substituir o instante de tempo t pelo contador k, sendo t = kΔt.

sk+1 = sk + vk ⋅ Δt

vk+1 = vk + (

F
m

− 0,4vk

2

) ⋅ Δt

Ocorre que, por se tratar de um sistema de equações não lineares, não podemos mais expressar o sistema na forma matricial Xk+1 = AXk + Bu. Em vez disso, expressaremos o sistema na forma:

sk+1 = f1(sk, vk)

vk+1 = f2(sk, vk)

Sendo:

f1

(sk, vk

) = sk + vk ⋅ Δt

f2

(sk, vk

) = vk + (

F
m

− 0,4vk

2

) ⋅ Δt

Do mesmo modo que fizemos com o sistema linear do carro impulsionado por apenas uma força, vamos adicionar os erros de processo e medição. Deste modo, o sistema físico seria:

sk+1 = f1

(sk, vk

) + wks

vk+1 = f2

(sk, vk

) + wkv

Sendo a medição yk dada por:

yk = c(sk, vk

) + vy

No nosso exemplo, c(sk, vk

) = sk, já que estamos medindo apenas a posição do carro.

Observe, nas figuras seguintes, os gráficos da posição e da velocidade produzidos pelas equações diferenciais do modelo não linear. Diferentemente do caso linear, em que apenas uma força agia no veículo, agora o carro adquire uma velocidade terminal, dada a resistência do ar.

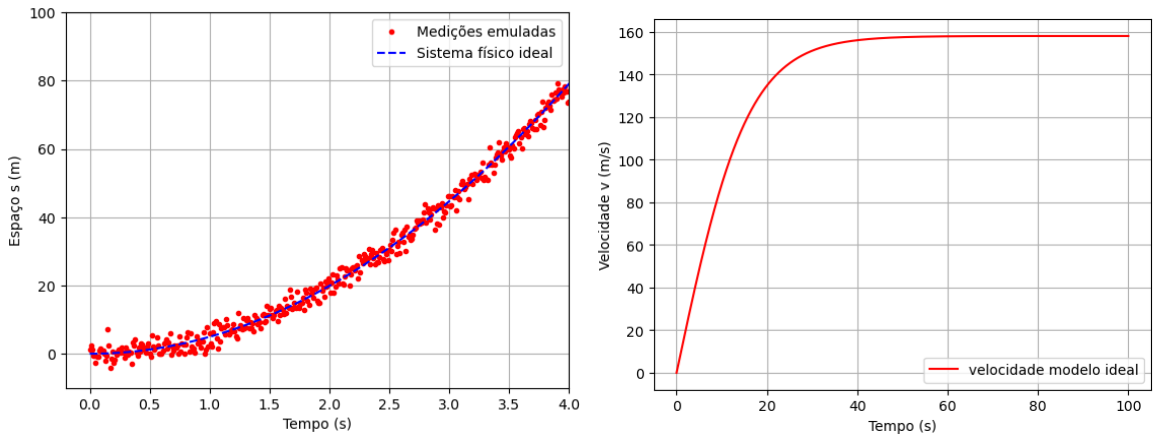
[picture p59: figure]

### Estimador de estado em malha fechada não linear

Há apenas duas diferenças entre os estimadores de estado em malha fechada linear e não linear: no não linear, não há as matrizes A, B e C, mas sim as funções f1, f2 e c. Além disso, no não linear, não podemos garantir que os erros convirjam para zero, situação que dependerá bastante das condições iniciais do problema. Observe o diagrama de blocos a seguir, percebendo que o modelo matemático estimará o próximo valor dos estados com base na função f (aqui, f representa duas funções) e no erro multiplicado por um ganho K fixo, como no estimador linear.

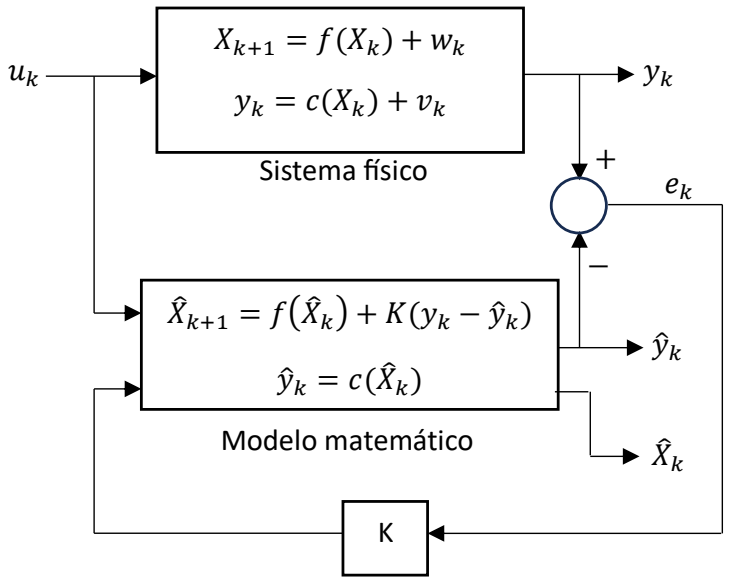
[picture p60: figure]
Sistema físico; Modelo matemático

Usando as mesmas condições iniciais distantes da posição e velocidade iniciais do sistema físico, notamos, nas figuras seguintes, que o estimador linear foi capaz de convergir para os estados medidos.

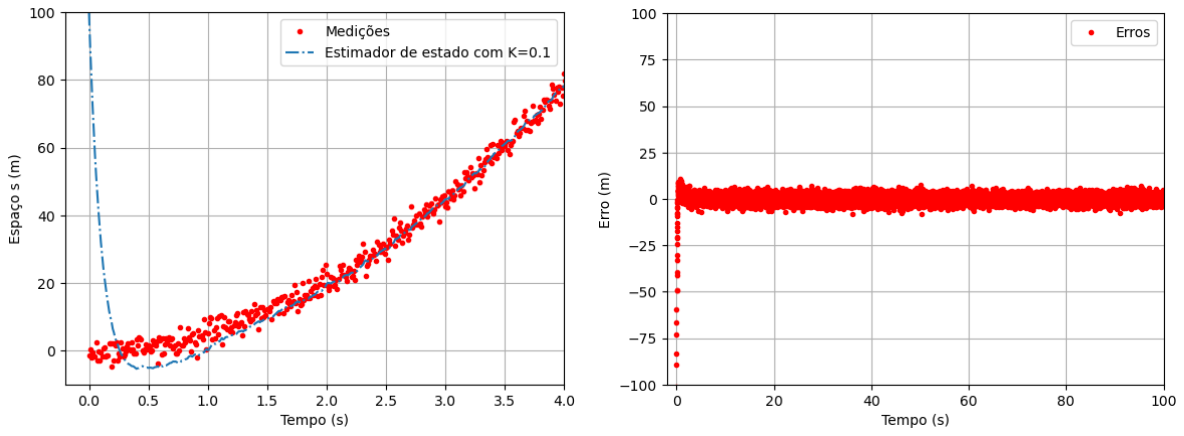
[picture p61: figure]

A velocidade estimada, apesar de divergir bastante no início da simulação, acaba convergindo para a velocidade medida.

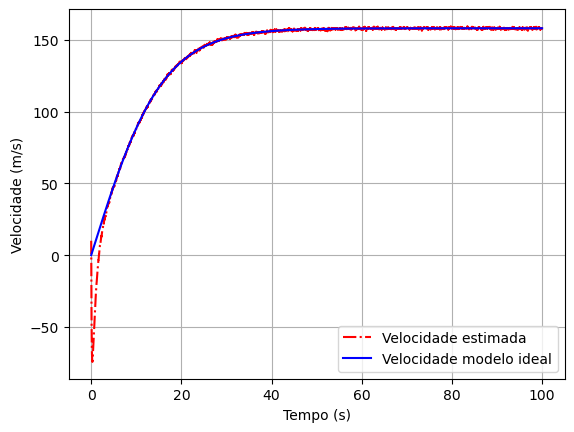
[picture p62: figure]

### Filtro de Kalman Estendido

Assim como ocorreu com o estimador em malha fechada não linear, há poucas diferenças entre o Filtro de Kalman e o Filtro de Kalman Estendido, usado para sistemas não lineares. Neste, assim como ocorre com o estimador não linear, não podemos garantir que haja convergência para erros nulos. O algoritmo do Filtro de Kalman Estendido é apresentado abaixo:

Predição

X̂

k̅ = f(X̂
k)

A =

∂f
∂X̂

C =

∂c
∂X̂

Pk̅ = APk−1A

T + Q

Atualização

Kk = Pk̅C

T(CPk̅C

T + R)

−1

X̂

k = X̂

k̅ + Kk(yk − CX̂
k̅ )

Pk = (I − KkC)Pk̅

Assim como ocorreu com o estimador não linear, em vez das matrizes A e B, usamos as funções não lineares para o processo de predição. Contudo, precisamos linearizar recursivamente as funções f e c, implementadas nas matrizes A e C, a partir do cálculo dos jacobianos

∂f
∂X̂

e

∂c
∂X̂

, definidos por:

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
Para o exemplo em questão, no qual f1

(sk, vk

) = sk + vk ⋅ Δt, f2

(sk, vk

) = vk + (
F
m

− 0,4vk

2

) ⋅ Δt, e c(sk, vk
) =
sk, as matrizes A e C serão:

A = [

1 Δt
0 1 − 0,8vΔt

]

C = [1 0]

Os gráficos a seguir apresentam os resultados da simulação do FKE, considerando as condições iniciais estimadas como ŝ(0) = 100m e v̂(0) = 10m/s. É possível perceber que não há convergência neste caso, uma vez que a posição estimada apresenta um viés positivo em relação às medições.

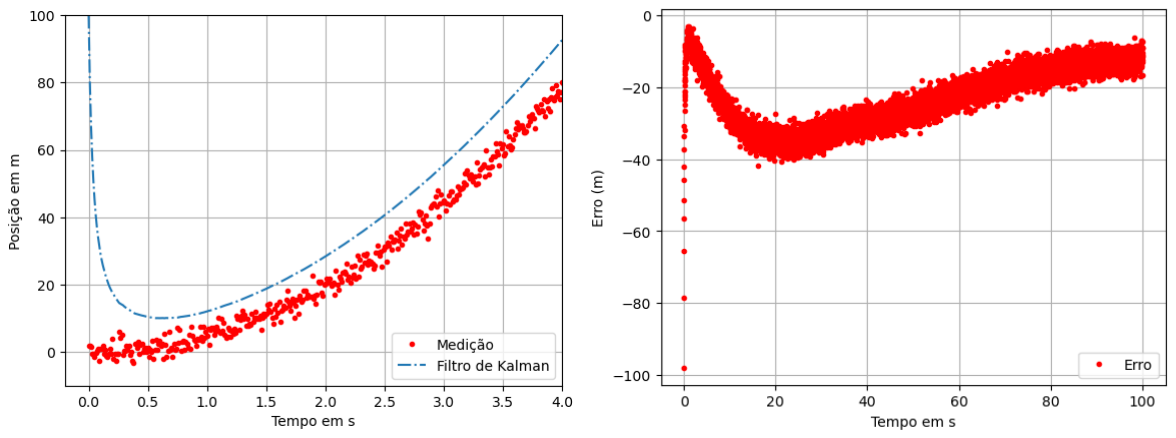
[picture p63: figure]

Alterando-se as condições iniciais para ŝ(0) = 10m e v̂(0) = 1m/s, o FKE volta a apresentar convergência, como pode ser observado na figura seguinte.

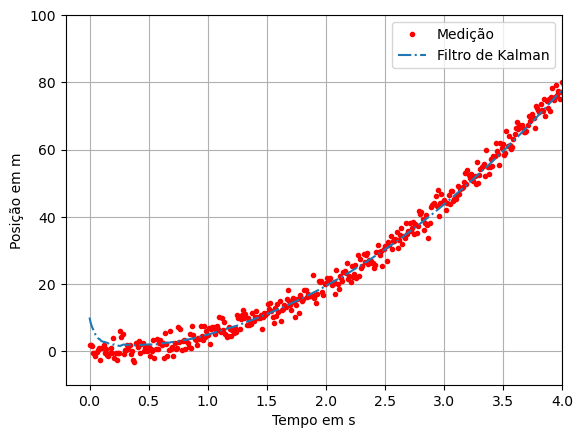
[picture p64: figure]

Por fim, a velocidade estimada é apresentada no gráfico a seguir.

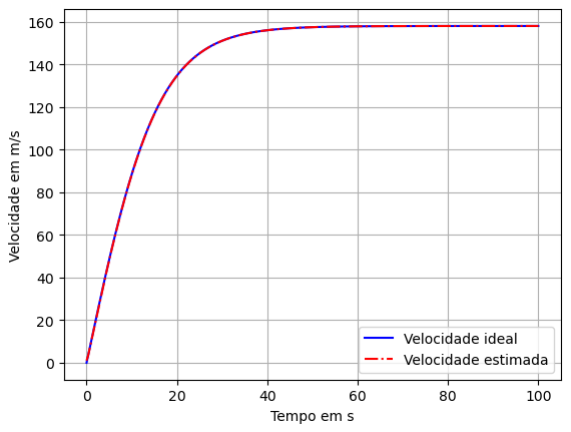
[picture p65: figure]
