sharpiestealr/mono/figuras/actually using/cascatinha.png

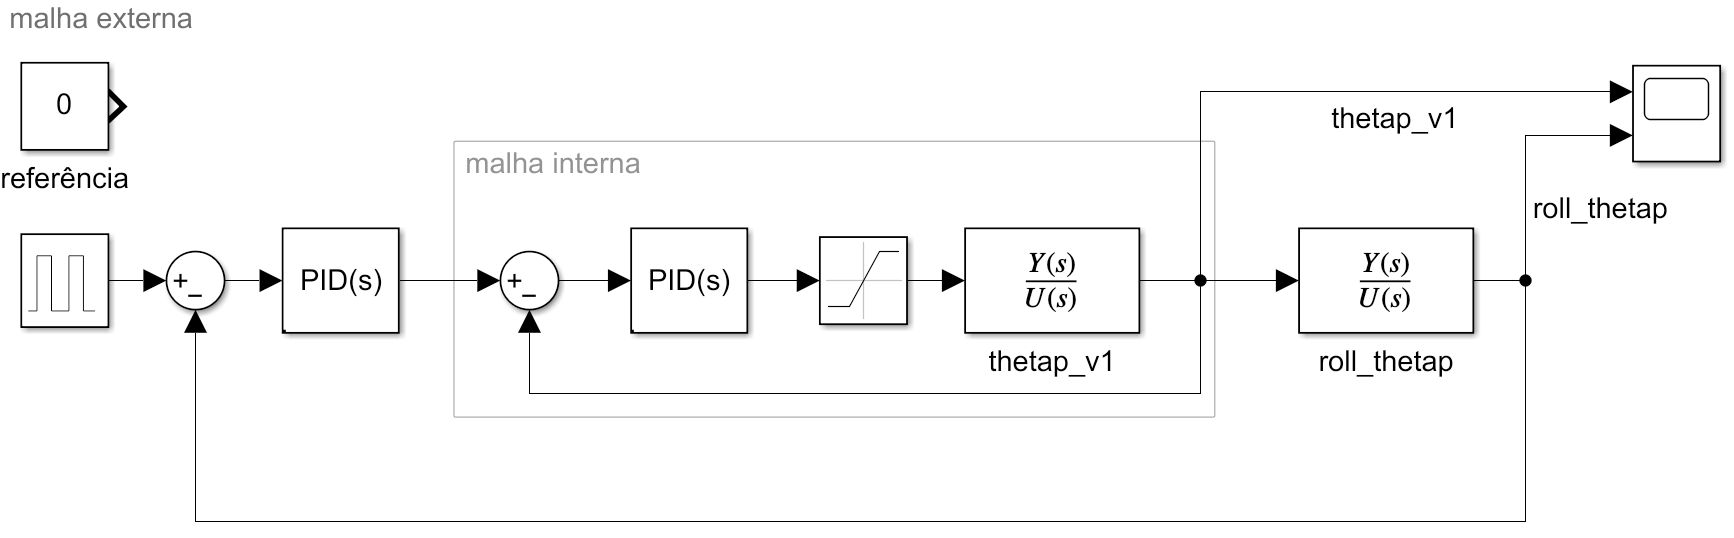
figuras/actually using/cascatinha.png
