sharpiestealr/mono/figuras/actually using/lqr simulink.png

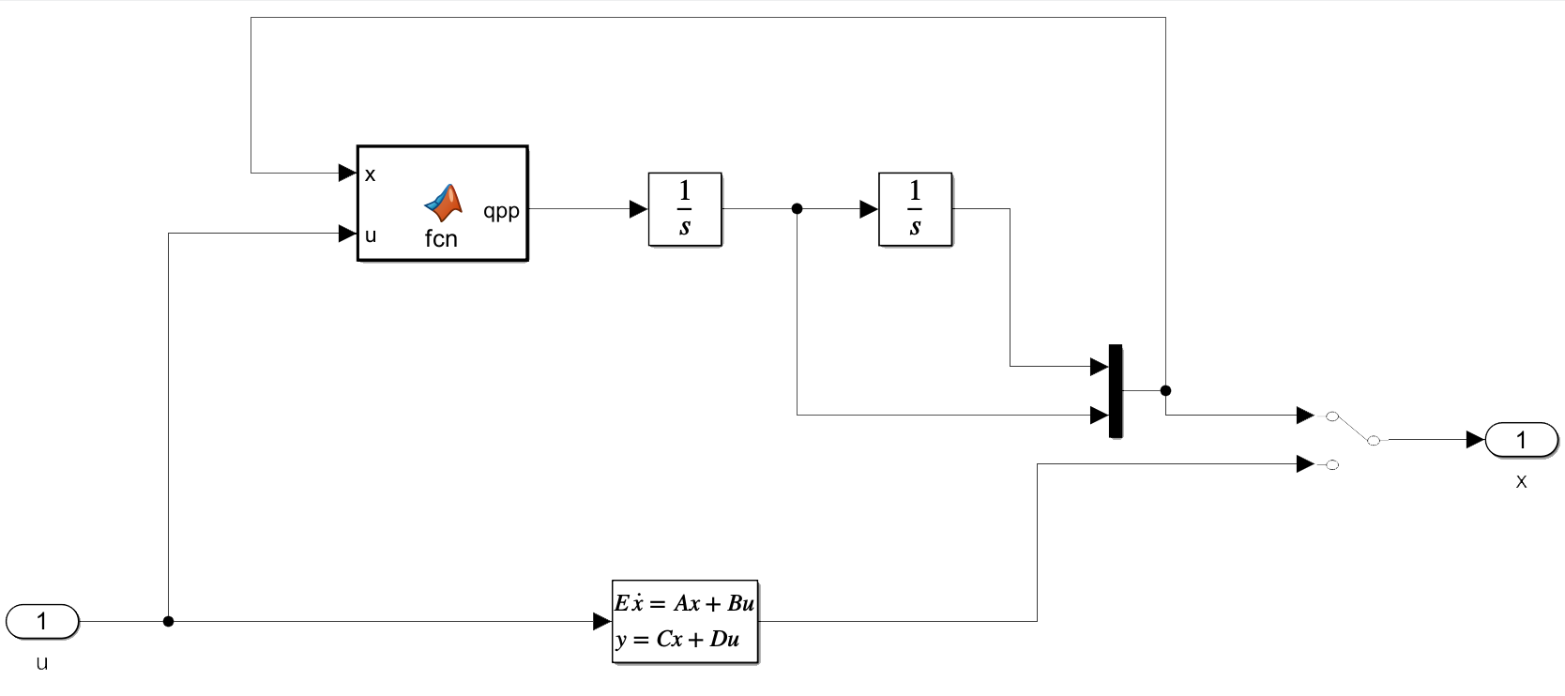
figuras/actually using/lqr simulink.png
