sharpiestealr/mono/figuras/actually using/monociclo back.png

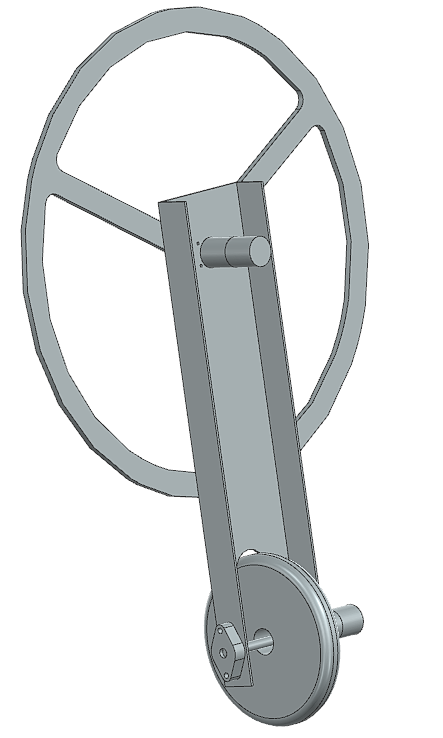
figuras/actually using/monociclo back.png
