sharpiestealr/mono/figuras/actually using/monociclo.png

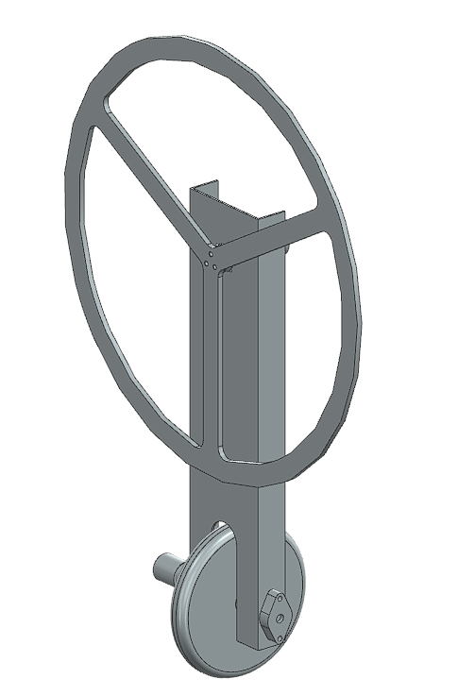
figuras/actually using/monociclo.png
