sharpiestealr/mono/figuras/actually using/realim vels 2.png

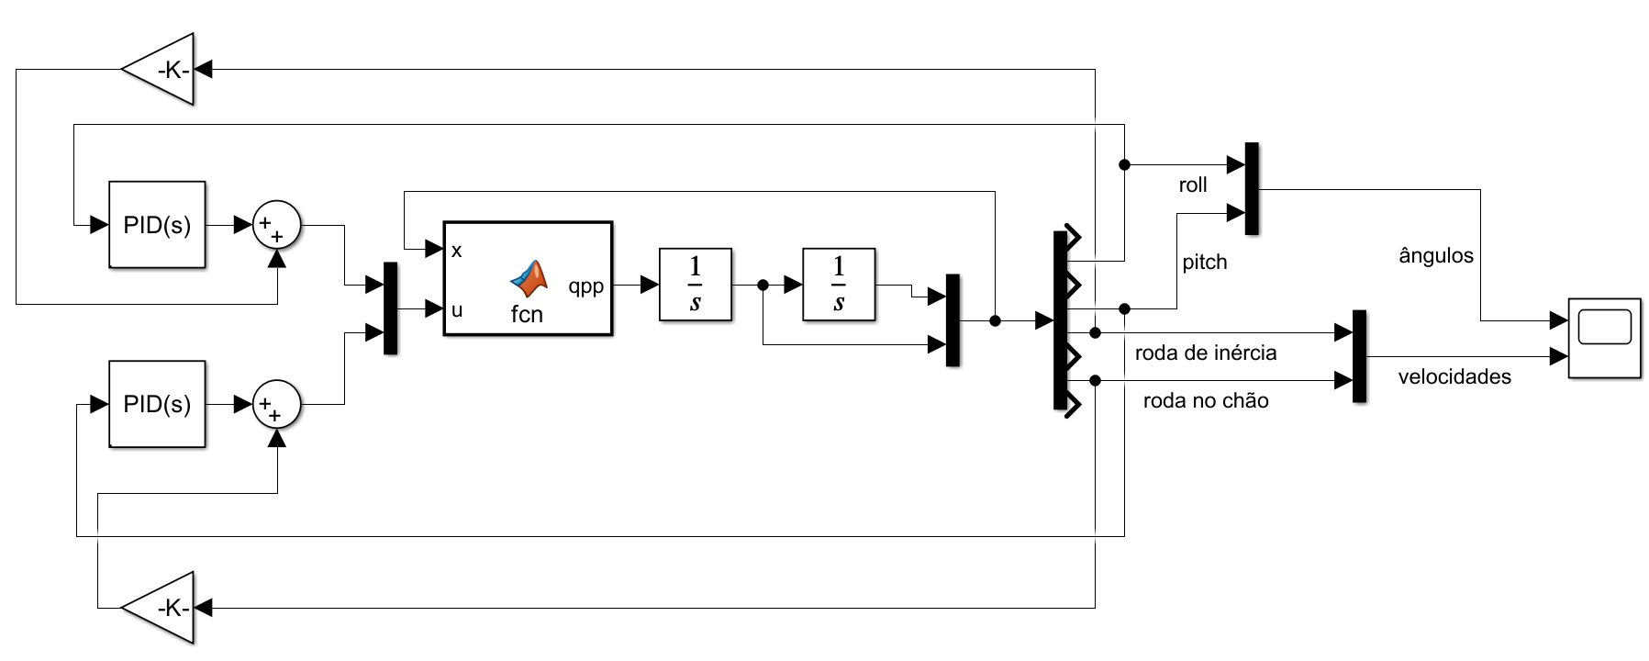
figuras/actually using/realim vels 2.png
