sharpiestealr/mono/figuras/actually using/realim vels.png

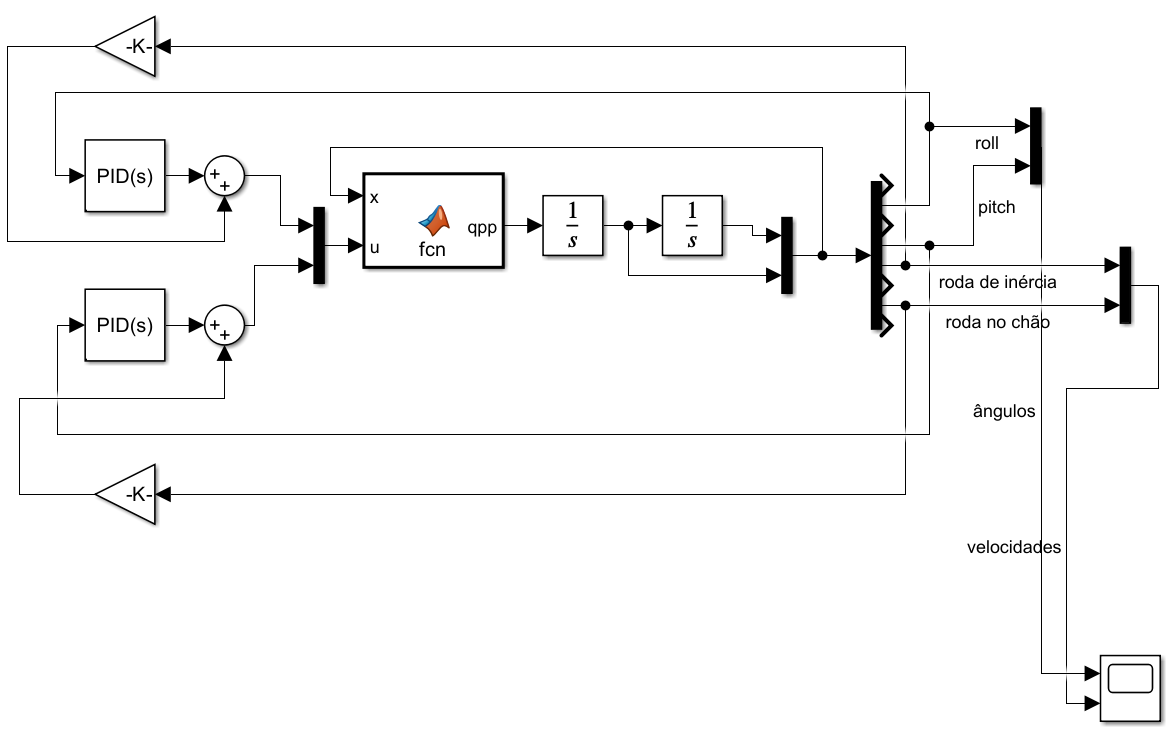
figuras/actually using/realim vels.png
