sharpiestealr/mono/figuras/cascata_velocidades-shark_teeth.png

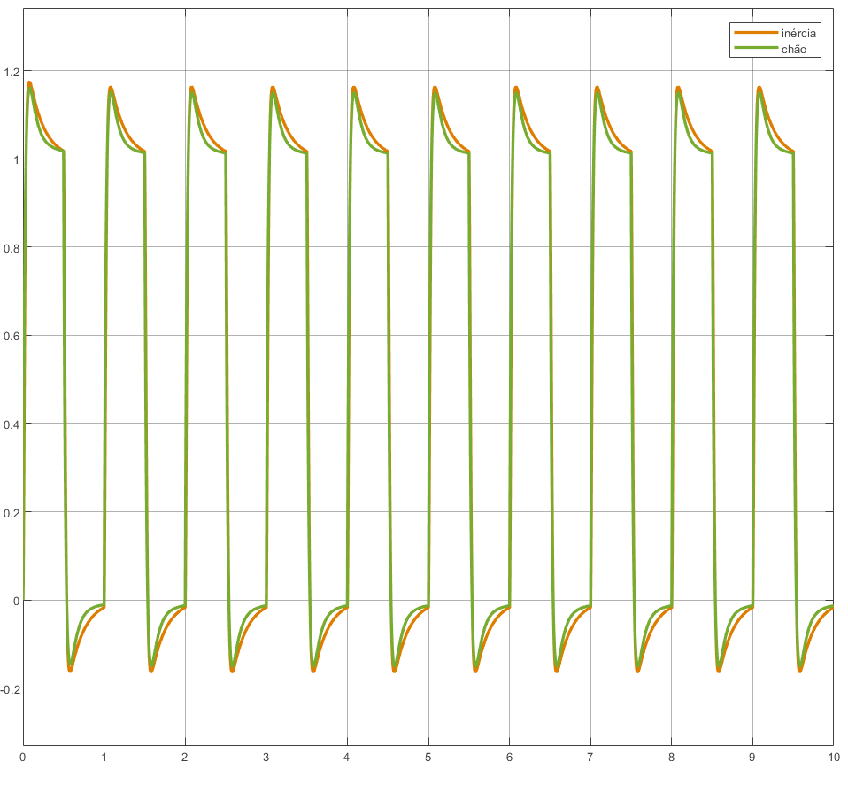
figuras/cascata_velocidades-shark_teeth.png
