sharpiestealr/mono/figuras/lqr implementado.png

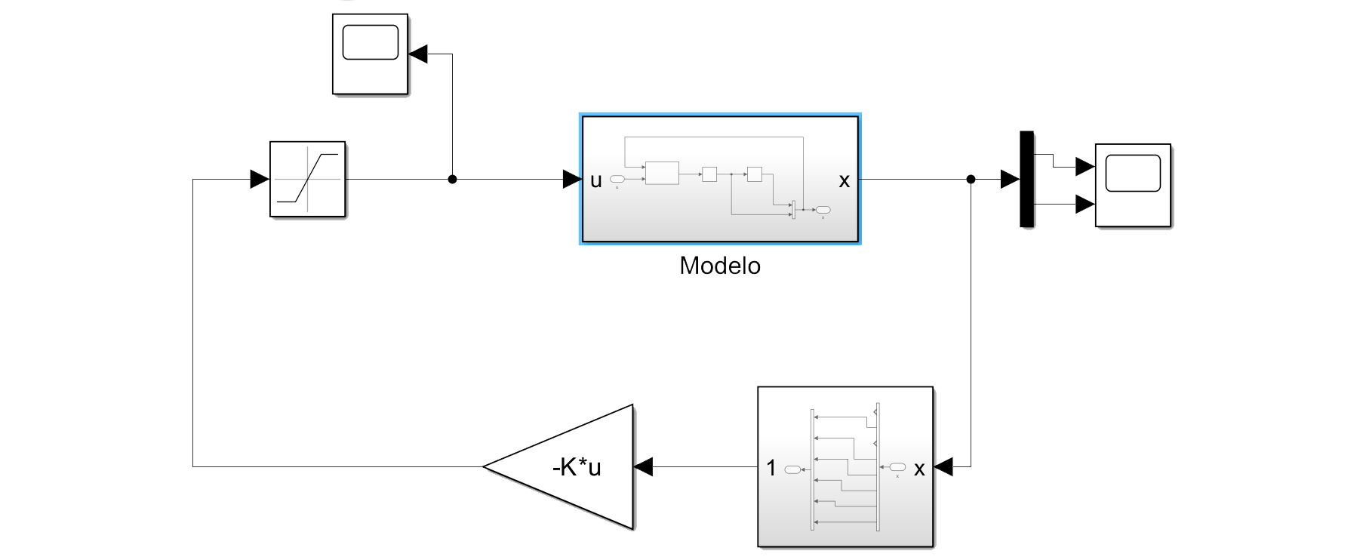
figuras/lqr implementado.png
