sharpiestealr/mono/figuras/lqr/regra_pos.png

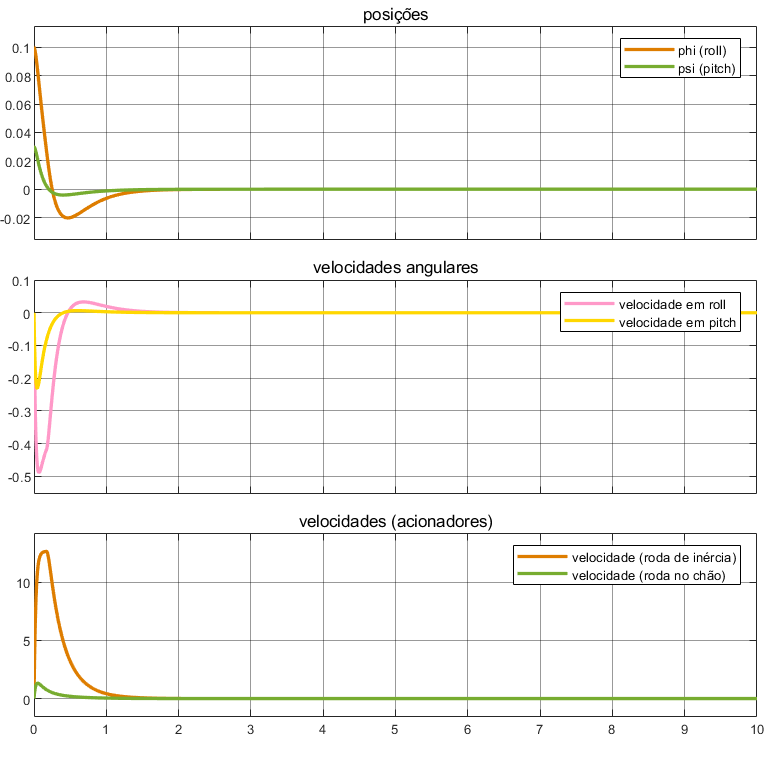
figuras/lqr/regra_pos.png
