sharpiestealr/mono/figuras/lqr/regra_pwms.png

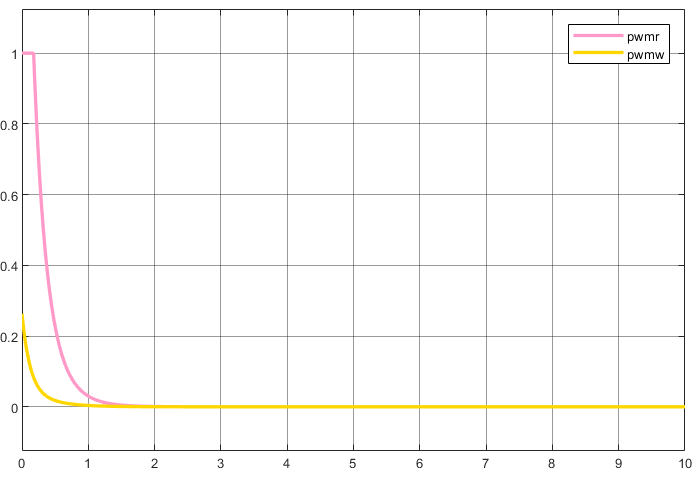
figuras/lqr/regra_pwms.png
