sharpiestealr/mono/figuras/lqr/regra_torques.png

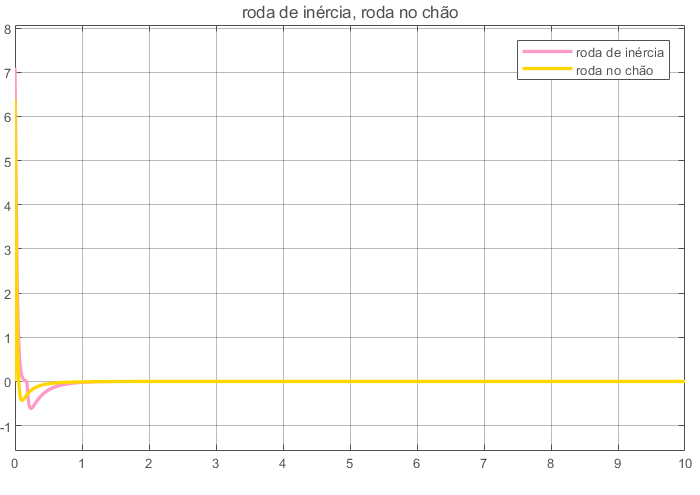
figuras/lqr/regra_torques.png
