sharpiestealr/mono/figuras/lqr/v1_pos.png

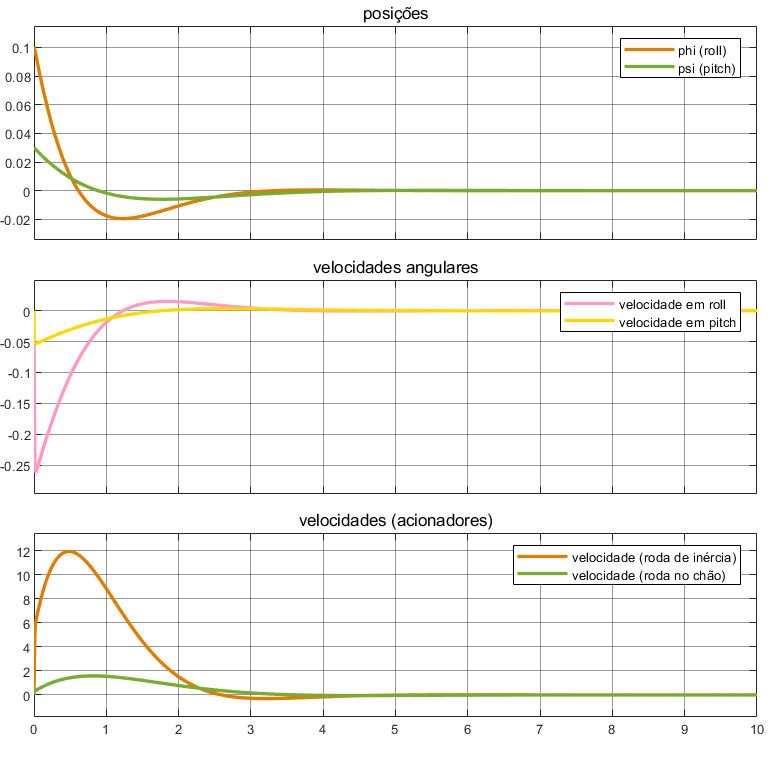
figuras/lqr/v1_pos.png
