sharpiestealr/mono/figuras/lqr/v1_pwms.png

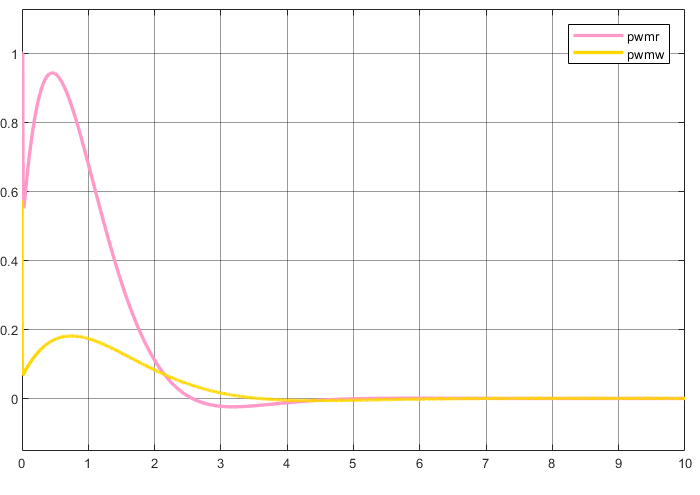
figuras/lqr/v1_pwms.png
