sharpiestealr/mono/figuras/lqr/v3_pwms.png

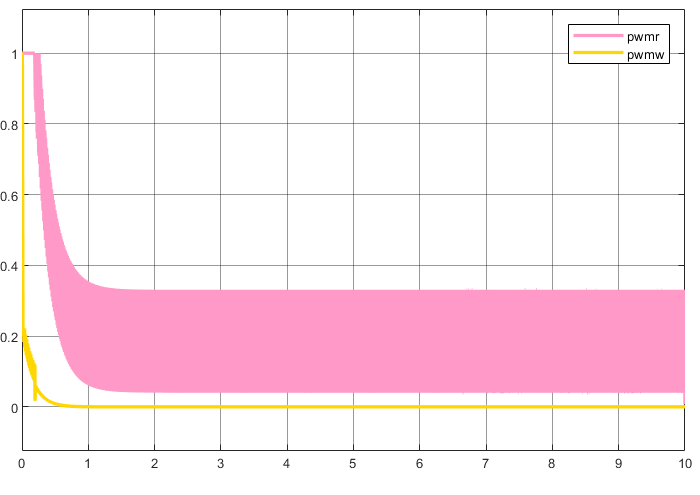
figuras/lqr/v3_pwms.png
