sharpiestealr/mono/figuras/lqr/v3_torques.png

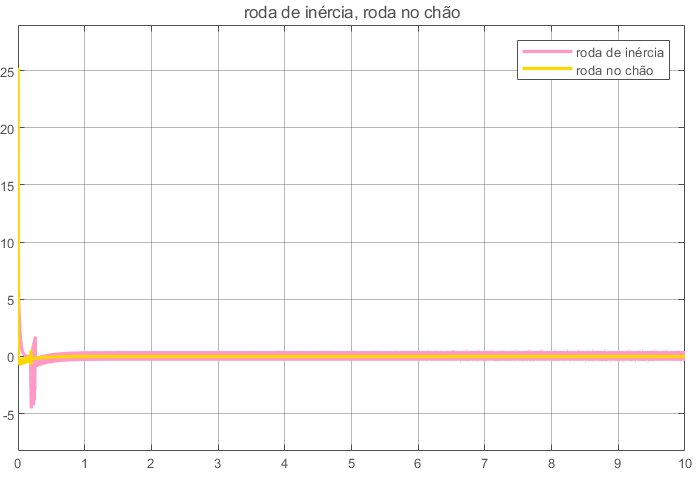
figuras/lqr/v3_torques.png
