sharpiestealr/mono/figuras/lqr/v7_pos.png

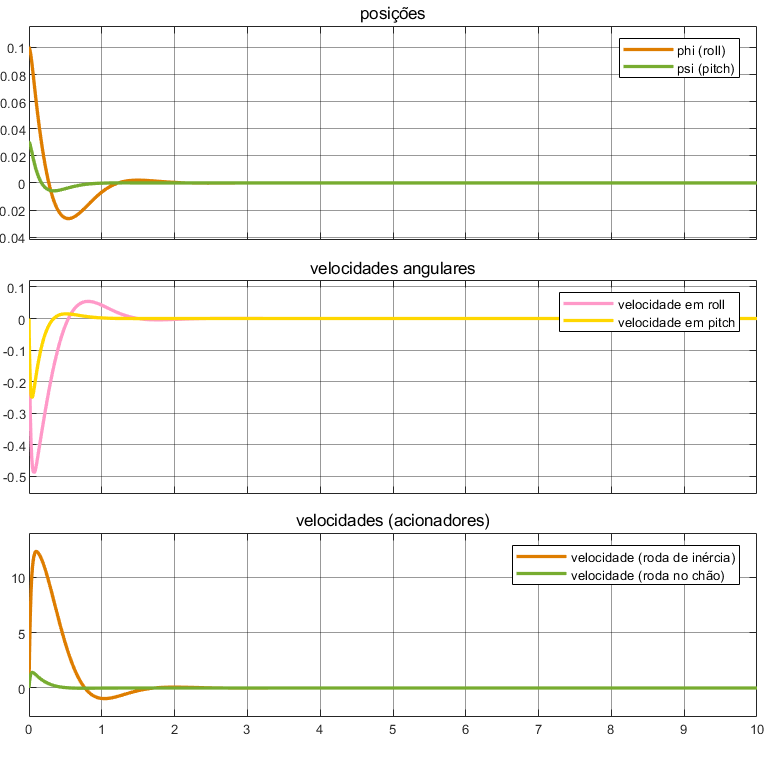
figuras/lqr/v7_pos.png
