sharpiestealr/mono/figuras/lqr/v7_pwms.png

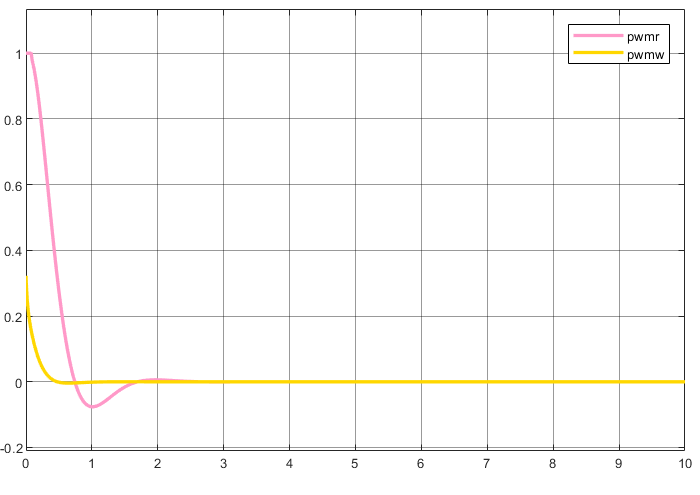
figuras/lqr/v7_pwms.png
