sharpiestealr/mono/figuras/lqr_offcenter.png

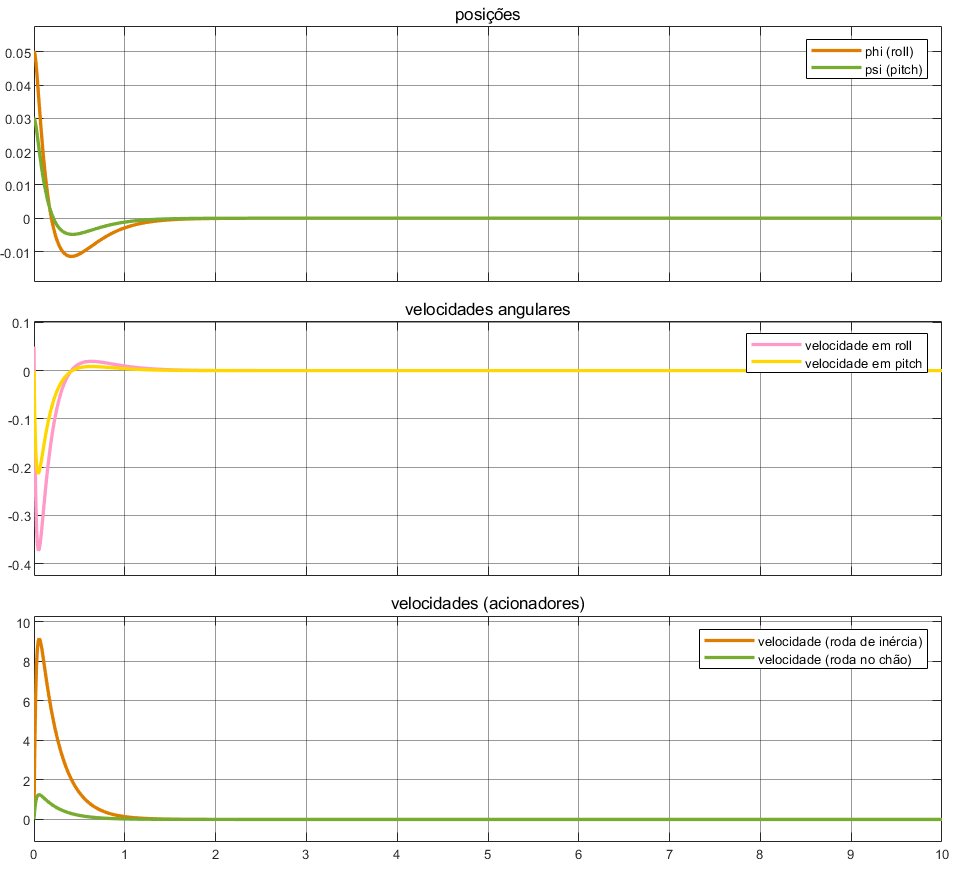
figuras/lqr_offcenter.png
