sharpiestealr/mono/figuras/lqr_simulink.png

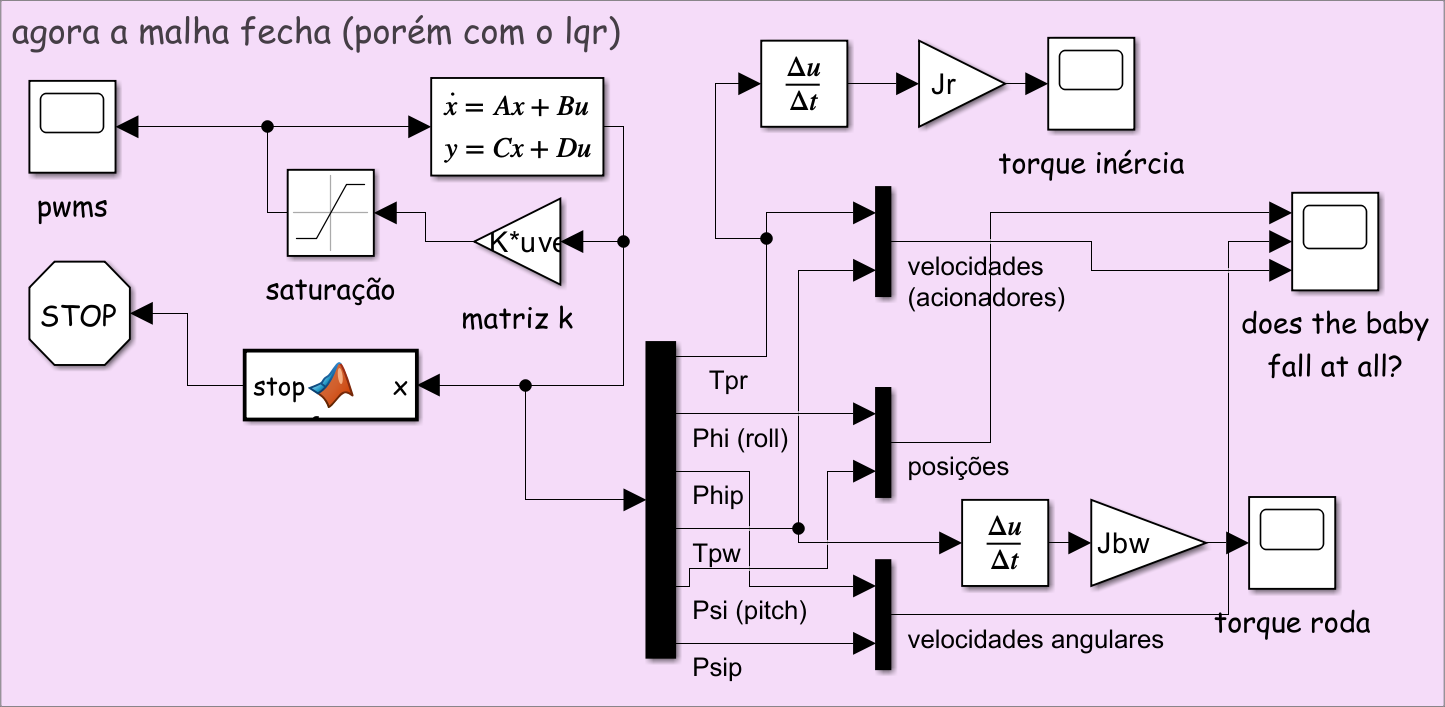
figuras/lqr_simulink.png
