sharpiestealr/mono/figuras/nlinear_center.png

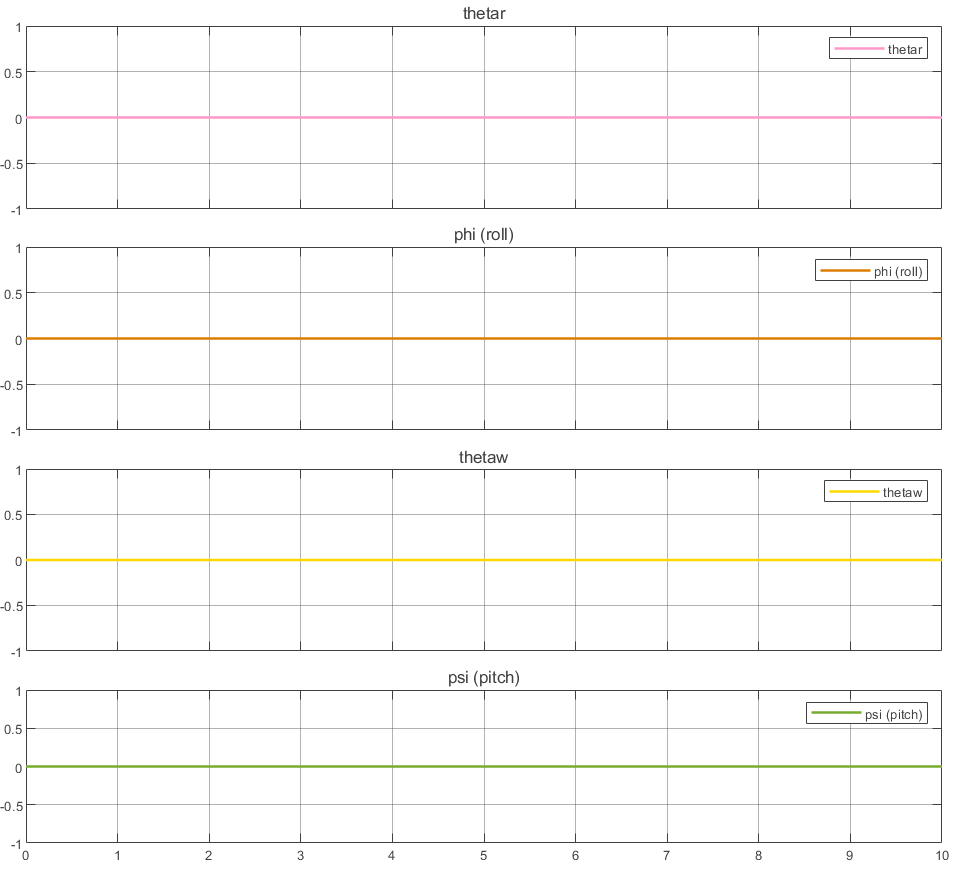
figuras/nlinear_center.png
