sharpiestealr/mono/figuras/nlinear_offcenter.png

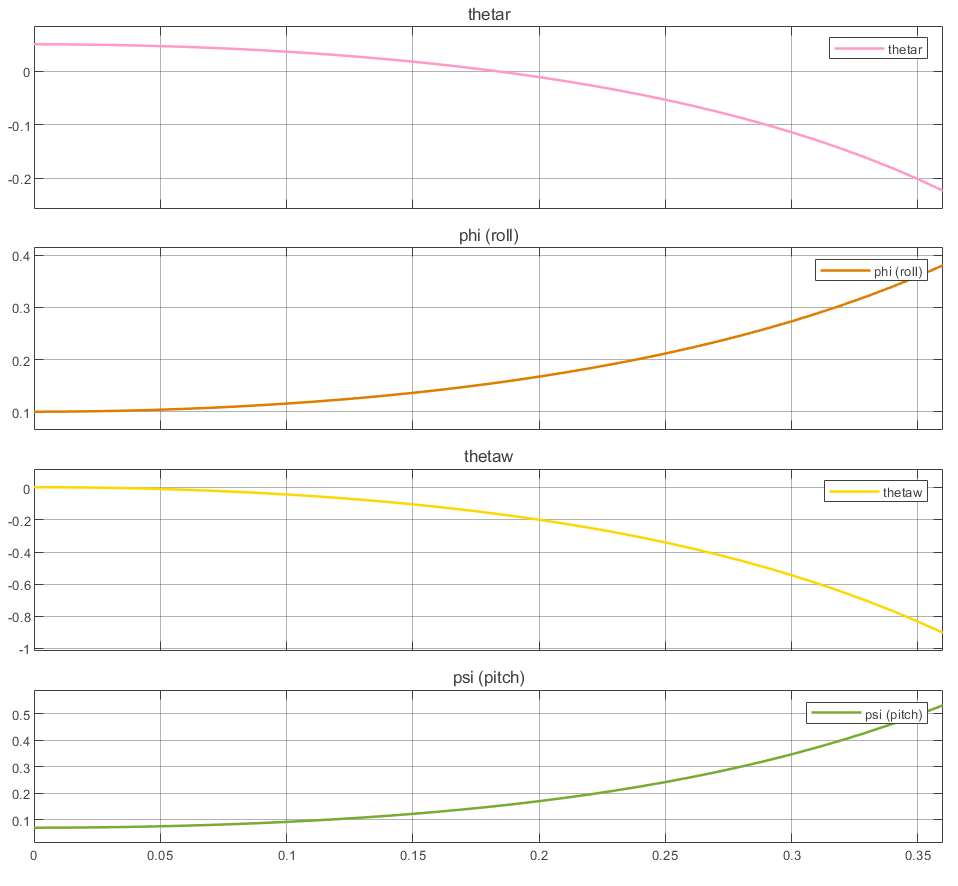
figuras/nlinear_offcenter.png
