sharpiestealr/mono/figuras/nlinear_simulink.png

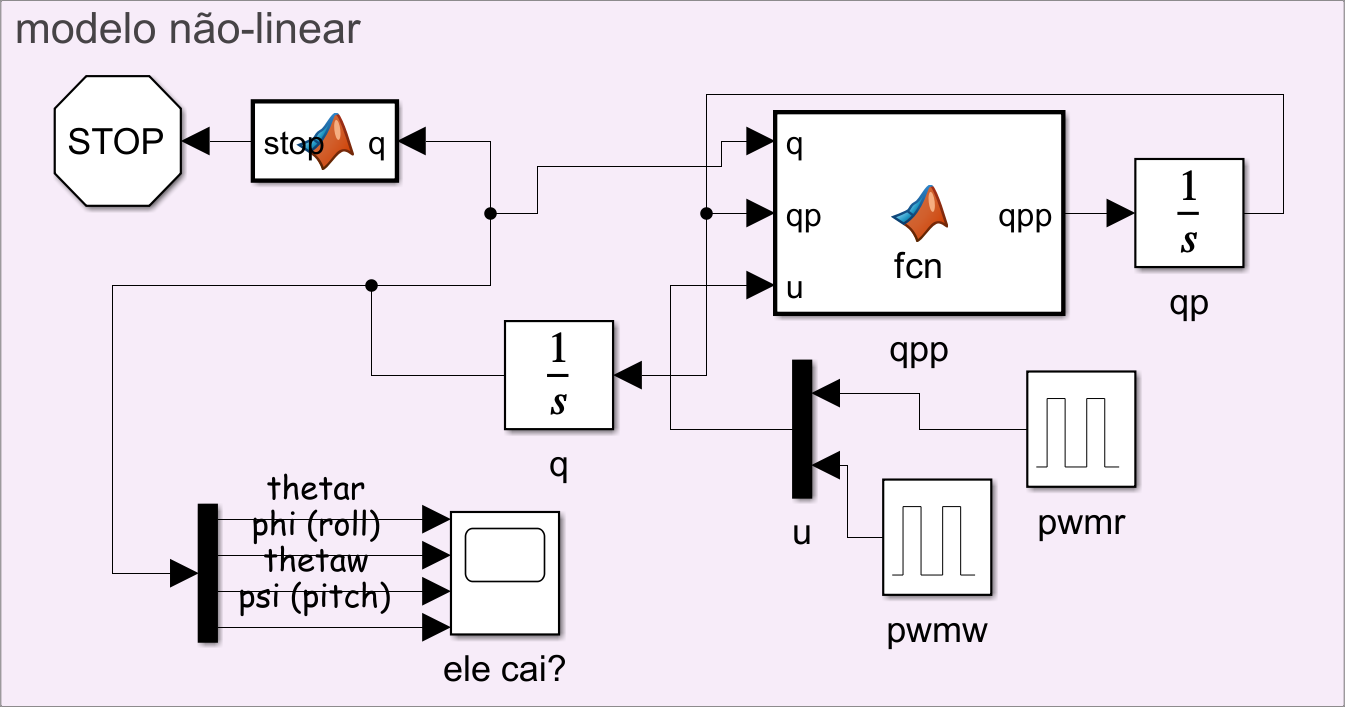
figuras/nlinear_simulink.png
