sharpiestealr/mono/figuras/pid_example.png

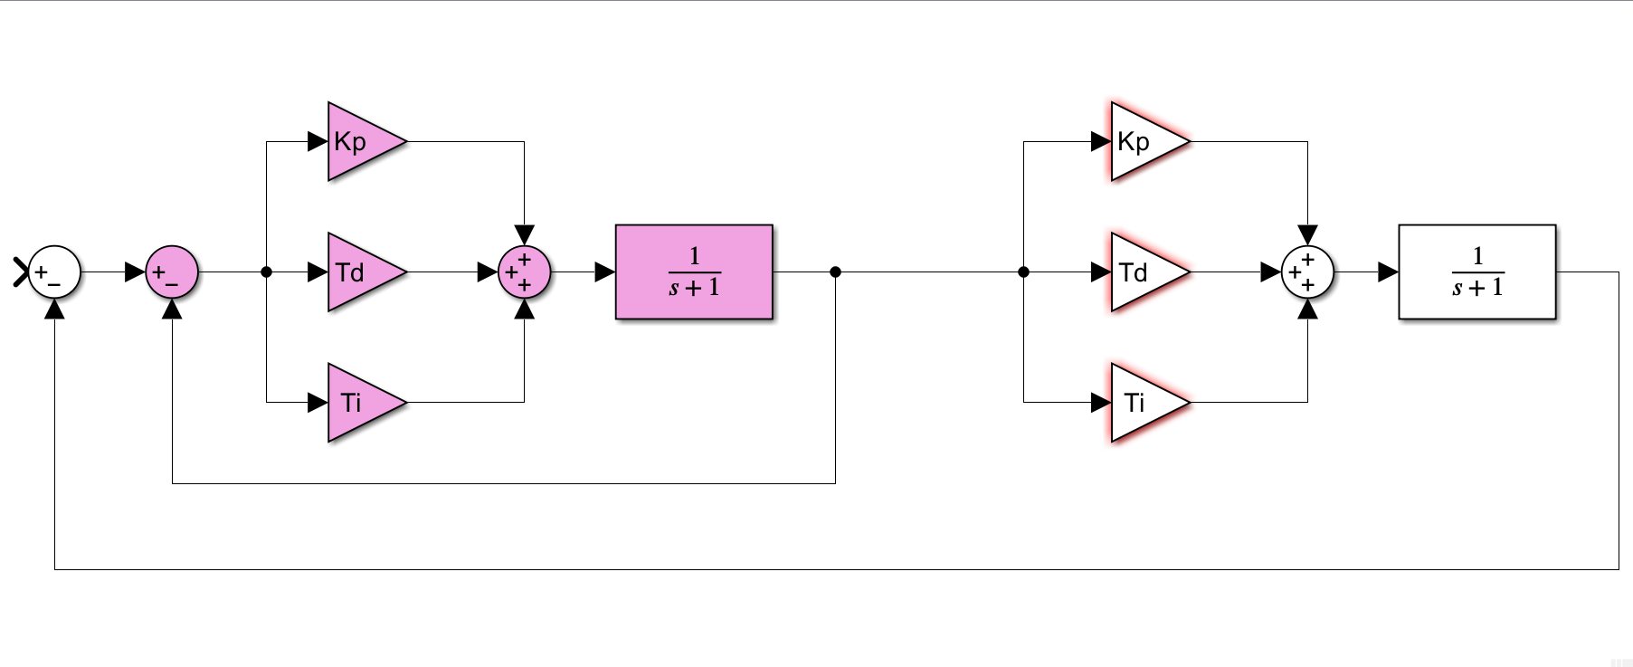
figuras/pid_example.png
