sharpiestealr/mono/component pics/c-hub dtm.png

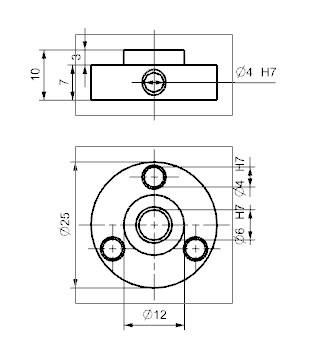
component pics/c-hub dtm.png
