sharpiestealr/mono/component pics/driver.png

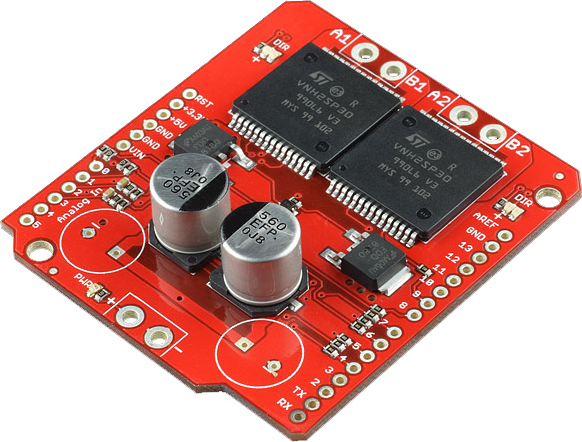
component pics/driver.png
