sharpiestealr/mono/component pics/mono backshot.png

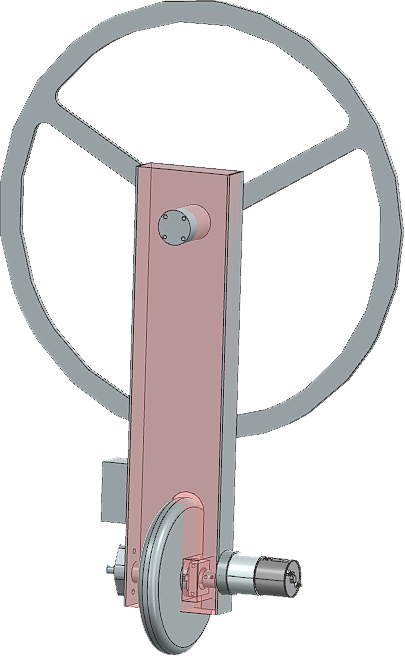
component pics/mono backshot.png
