sharpiestealr/mono/component pics/opto schem.png

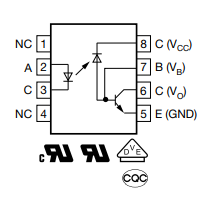
component pics/opto schem.png
