sharpiestealr/mono/component pics/opto.png

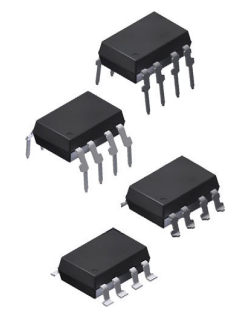
component pics/opto.png
