sharpiestealr/mono/component pics/wheel.jpg

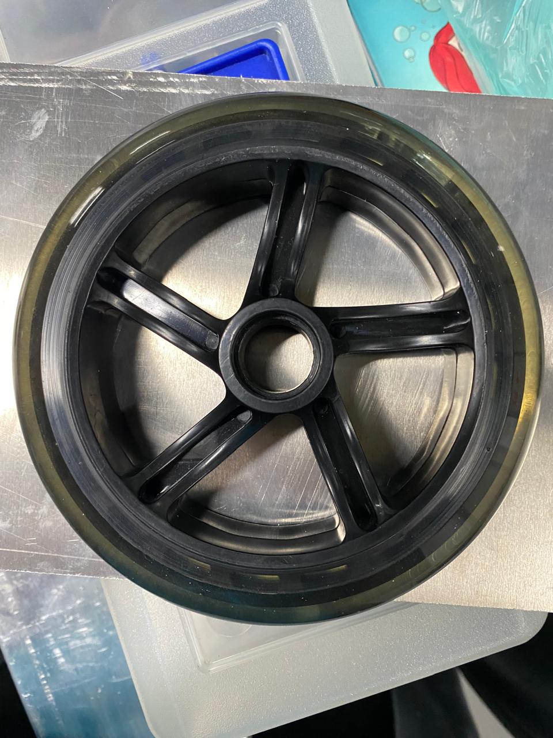
component pics/wheel.jpg
