sharpiestealr/mono/cad/37d-gearmotor-3d-models/37d-gearmotor-100-131-150-encoder.step

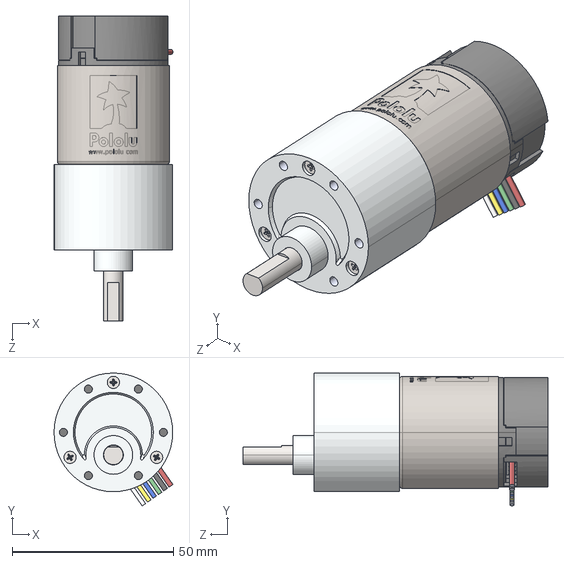
[picture p98: CAD file, 2024-03-15]
cad/37d-gearmotor-3d-models/37d-gearmotor-100-131-150-encoder.step
36.9 x 41.2 x 94.6 mm
