sharpiestealr/mono/cad/cuerpo.dxf

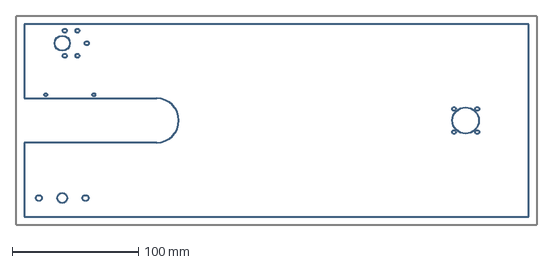
[picture p99: CAD file, 2024-07-15]
cad/cuerpo.dxf
412.7 x 165.7 mm
