sharpiestealr/mono/corpo_bk.dxf

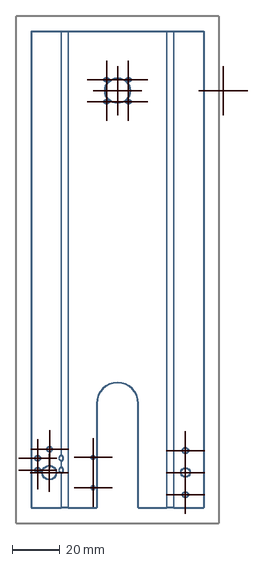
[picture p100: CAD file, 2024-07-15]
corpo_bk.dxf
97.1 x 212.7 mm
