sharpiestealr/mono/cad/37d-gearmotor-3d-models/37d-gearmotor-50-70-encoder.step

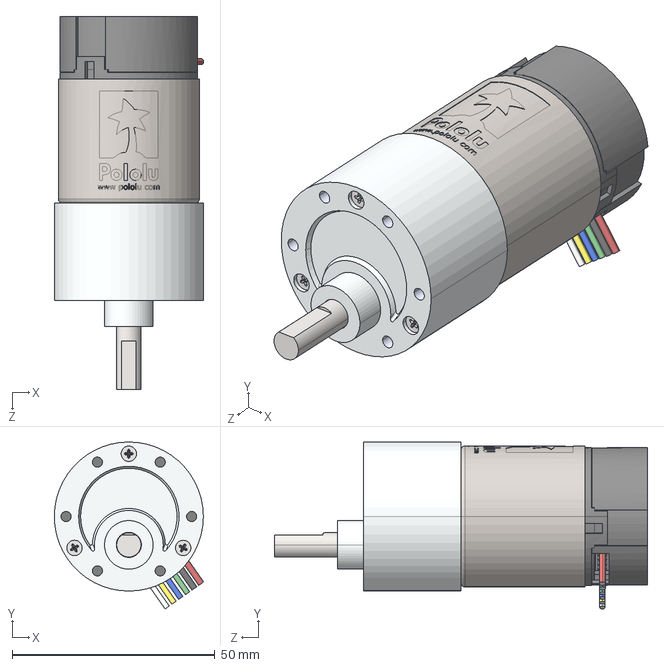
[picture p101: CAD file, 2024-03-15]
cad/37d-gearmotor-3d-models/37d-gearmotor-50-70-encoder.step
36.9 x 41.2 x 92.1 mm
