sharpiestealr/mono/cad/corpo.stp

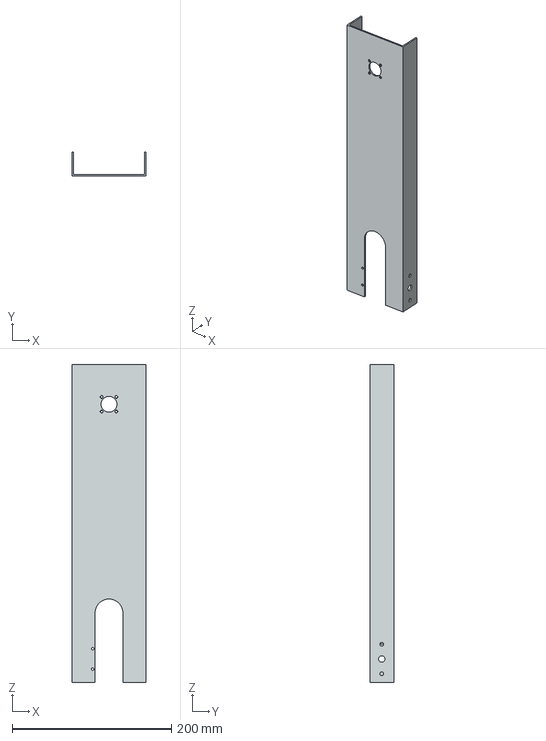
[picture p102: CAD file, 2024-07-15]
cad/corpo.stp
93.0 x 30.0 x 400.0 mm
