sharpiestealr/mono/cad/37d-gearmotor-3d-models/37d-gearmotor-19-30.step

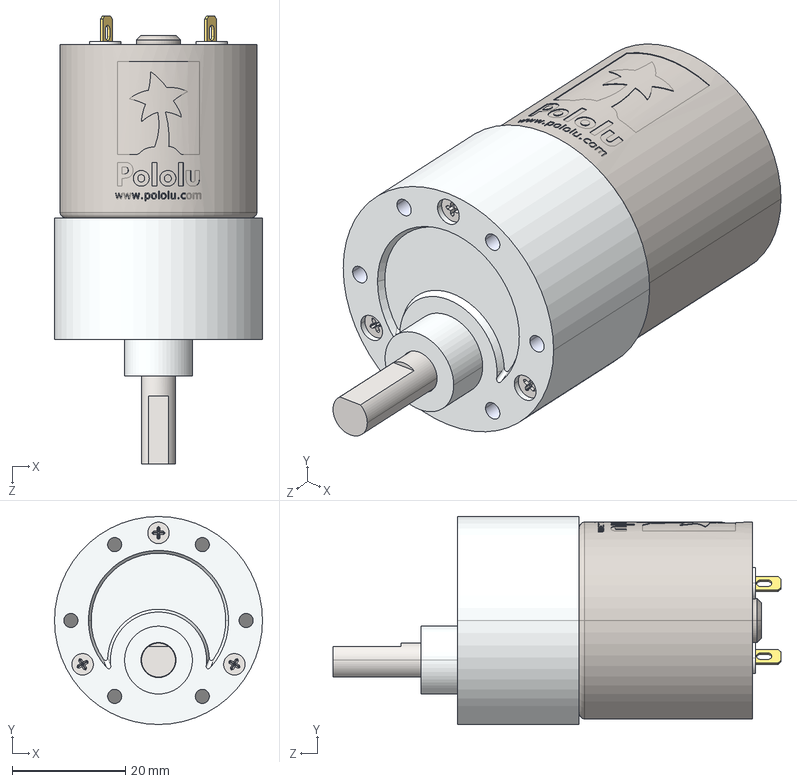
[picture p103: CAD file, 2024-03-15]
cad/37d-gearmotor-3d-models/37d-gearmotor-19-30.step
36.8 x 36.8 x 79.2 mm
