sharpiestealr/mono/cad/corpo but on a plane.dxf

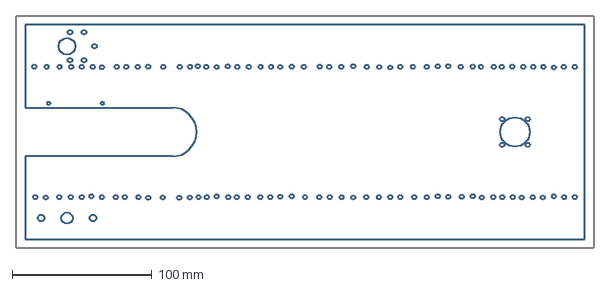
[picture p104: CAD file, 2024-07-15]
cad/corpo but on a plane.dxf
412.7 x 165.7 mm
