sharpiestealr/mono/cad/37d-gearmotor-3d-models/37d-gearmotor-19-30-encoder.step

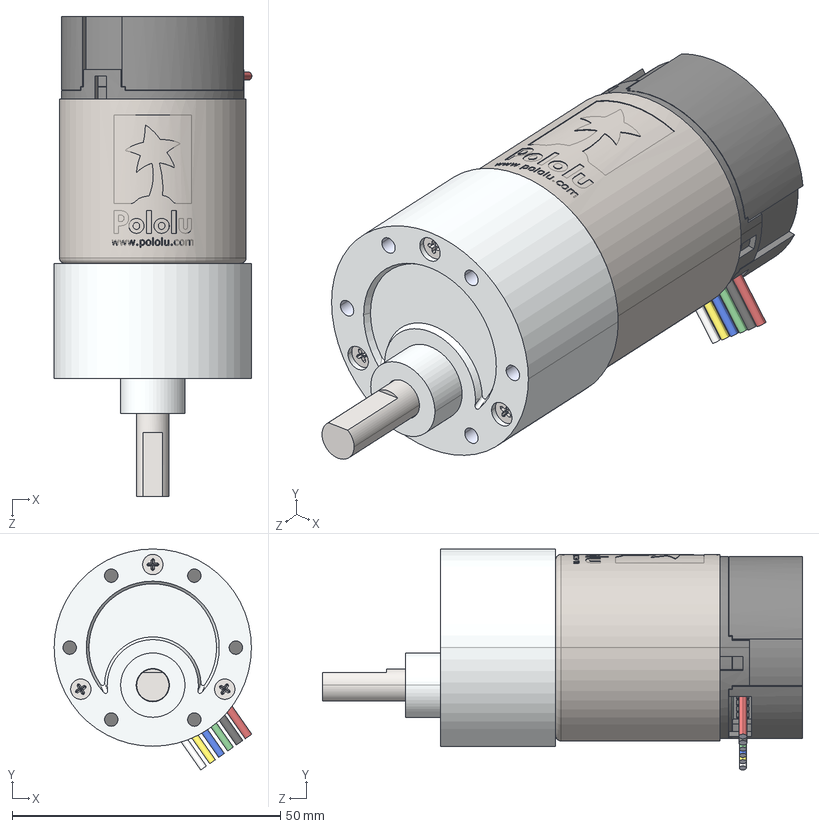
[picture p105: CAD file, 2024-03-15]
cad/37d-gearmotor-3d-models/37d-gearmotor-19-30-encoder.step
36.9 x 41.2 x 89.6 mm
