sharpiestealr/mono/cad/roda de inércia.igs

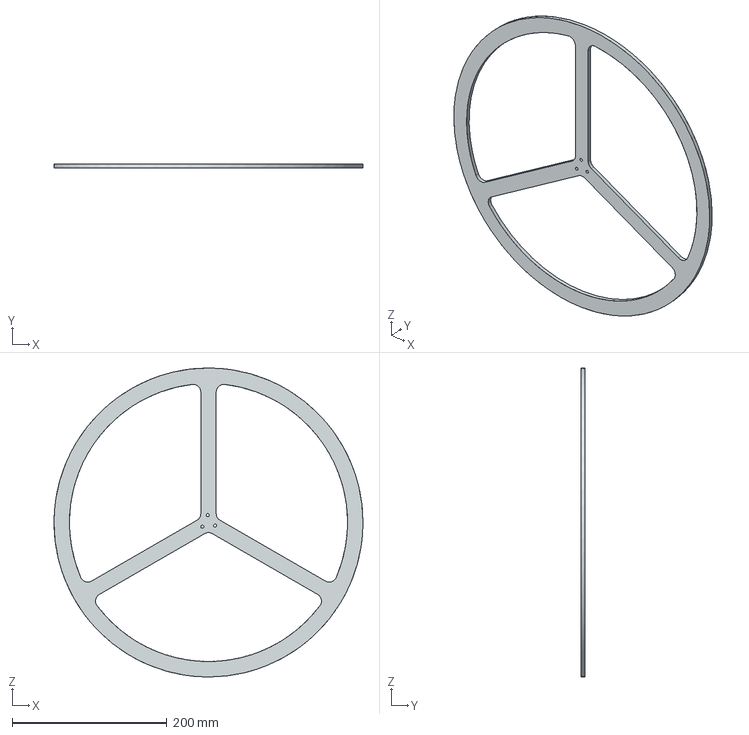
[picture p106: CAD file, 2024-05-10]
cad/roda de inércia.igs
400.0 x 5.00 x 400.0 mm
