sharpiestealr/mono/cad/37d-gearmotor-3d-models/37d-gearmotor-6-10-encoder.step

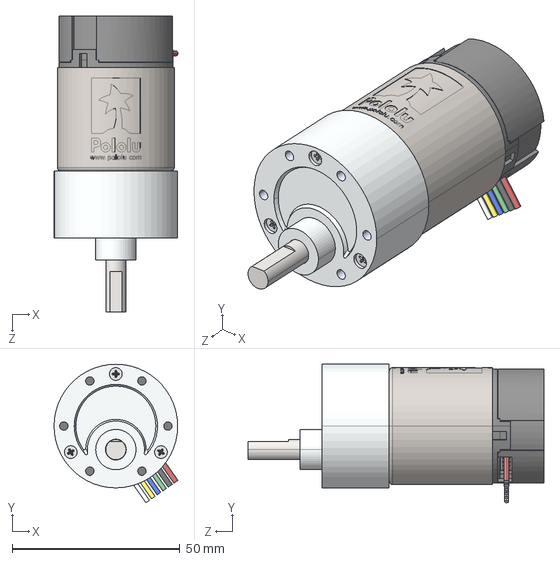
[picture p107: CAD file, 2024-03-15]
cad/37d-gearmotor-3d-models/37d-gearmotor-6-10-encoder.step
36.9 x 41.2 x 88.1 mm
