sharpiestealr/mono/cad/roda de inercia_bk.dxf

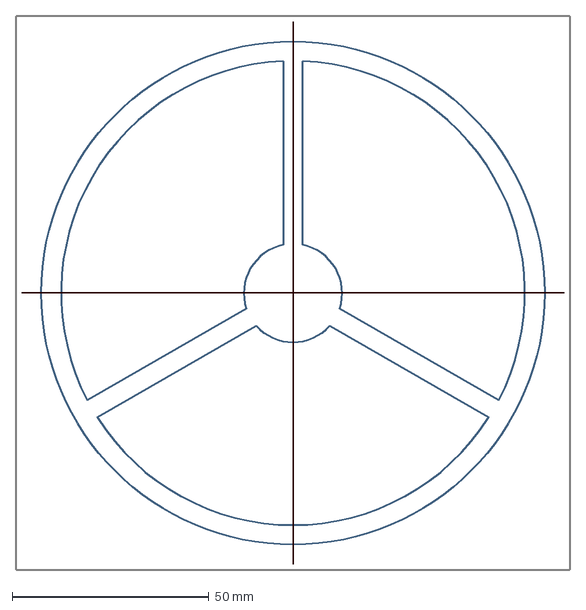
[picture p108: CAD file, 2024-02-27]
cad/roda de inercia_bk.dxf
140.7 x 140.7 mm
