sharpiestealr/mono/cad/37d-gearmotor-3d-models/37d-gearmotor-100-131-150.step

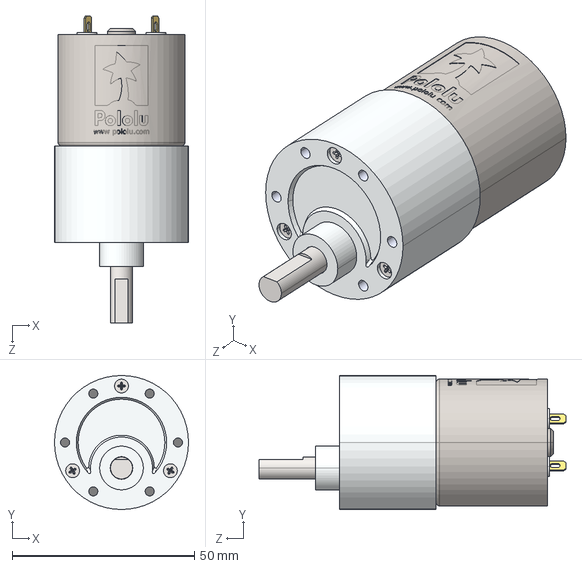
[picture p109: CAD file, 2024-03-15]
cad/37d-gearmotor-3d-models/37d-gearmotor-100-131-150.step
36.8 x 36.8 x 84.2 mm
