sharpiestealr/mono/cad/roda de inercia.dxf

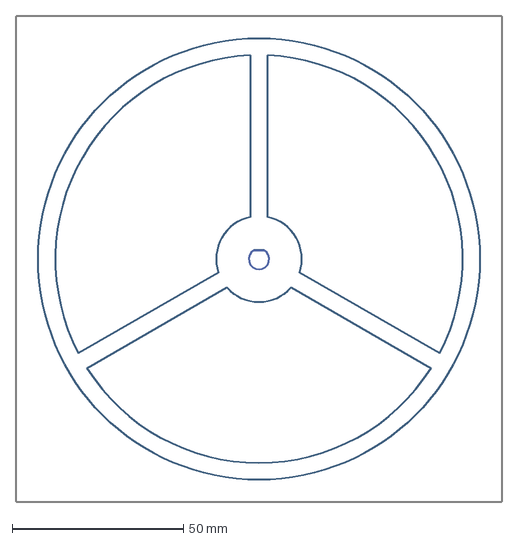
[picture p110: CAD file, 2024-02-27]
cad/roda de inercia.dxf
141.7 x 141.7 mm
