sharpiestealr/mono/cad/37d-gearmotor-3d-models/37d-gearmotor-without-gearbox-with-helical-pinion-gear.step

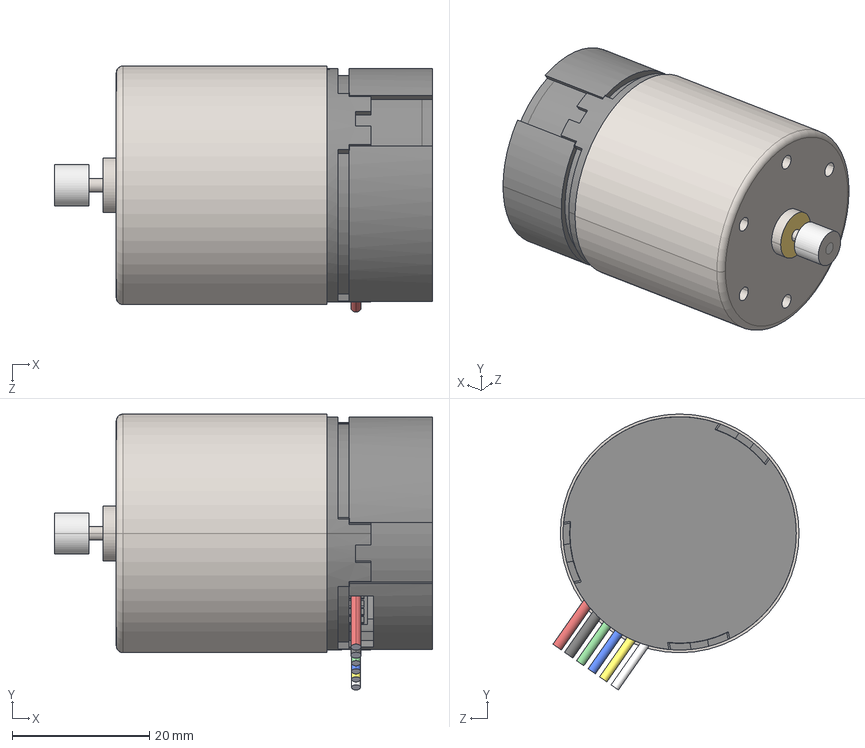
[picture p111: CAD file, 2024-03-15]
cad/37d-gearmotor-3d-models/37d-gearmotor-without-gearbox-with-helical-pinion-gear.step
55.1 x 40.2 x 35.9 mm
