sharpiestealr/mono/cad/mono.igs

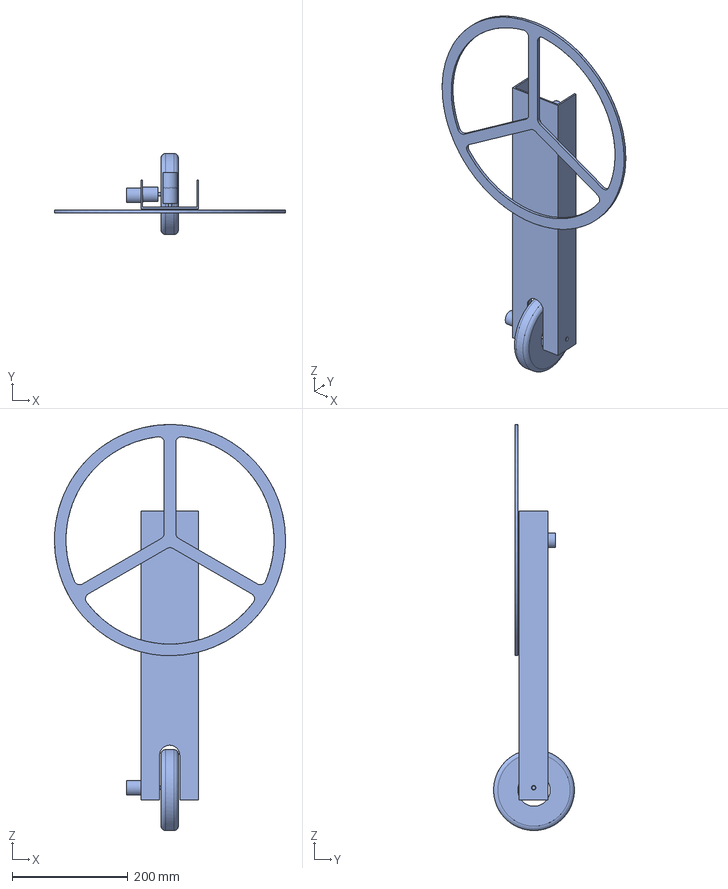
[picture p112: CAD file, 2024-02-27]
cad/mono.igs
400.0 x 139.8 x 702.6 mm
