sharpiestealr/mono/cad/37d-gearmotor-3d-models/37d-gearmotor-50-70.step

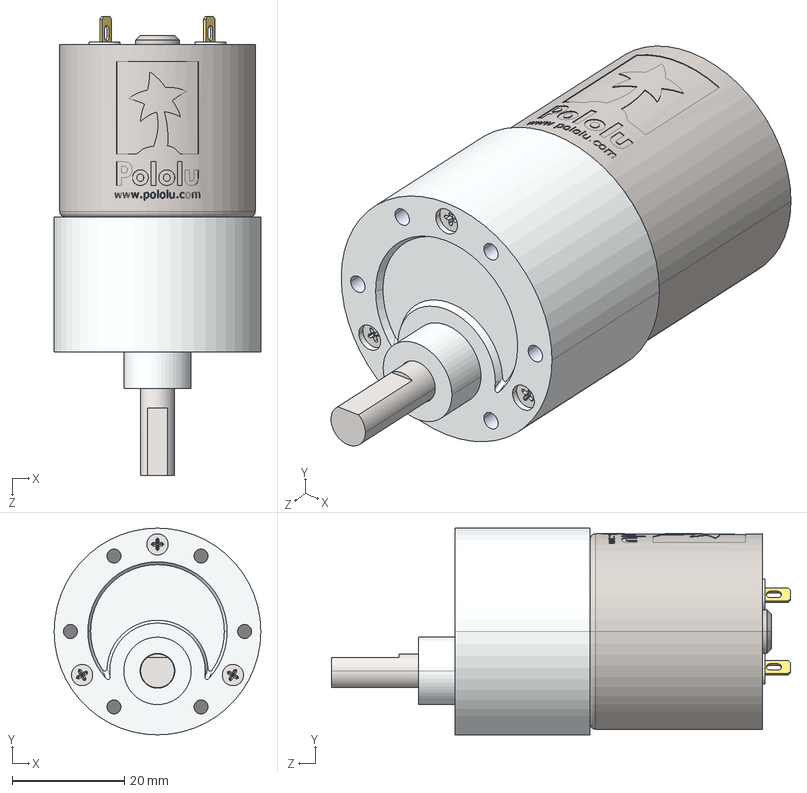
[picture p113: CAD file, 2024-03-15]
cad/37d-gearmotor-3d-models/37d-gearmotor-50-70.step
36.8 x 36.8 x 81.7 mm
