sharpiestealr/mono/cad/37d-gearmotor-3d-models/37d-gearmotor-6-10.step

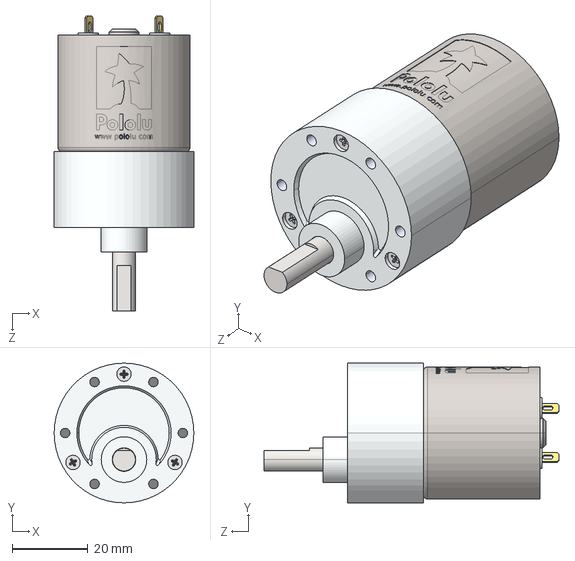
[picture p114: CAD file, 2024-03-15]
cad/37d-gearmotor-3d-models/37d-gearmotor-6-10.step
36.8 x 36.8 x 77.7 mm
