sharpiestealr/mono/(list of files, cad)

Other CAD files:
cad/37d-gearmotor-100-131-150_step.prt
cad/acoplamento.prt
cad/bateria.prt
cad/biblically accurate monociclo.prt
cad/bucha v2.prt
cad/bucha.prt
cad/c-hub.prt
cad/corpo but on a plane.prt
cad/corpo nyoom.prt
cad/corpo.prt
cad/corpo_1285.prt
cad/dhub.prt
cad/eixo v1.prt
cad/eixo v2.prt
cad/eixo v3.prt
cad/eixo_W.prt
cad/mancal interno.prt
cad/mancal.prt
cad/mono.prt
cad/motor_R.prt
cad/motor_R_MODEL.prt
cad/roda de inercia.prt
cad/roda de inércia - fixed.prt
cad/roda de inércia - fixed_2317.prt
cad/roda.prt
cad/roda_1463.prt
cad/tampa.prt
cad/wheel..prt
corpo.dxf
