sharpiestealr/mono/figuras/lqr_fine-tune.png

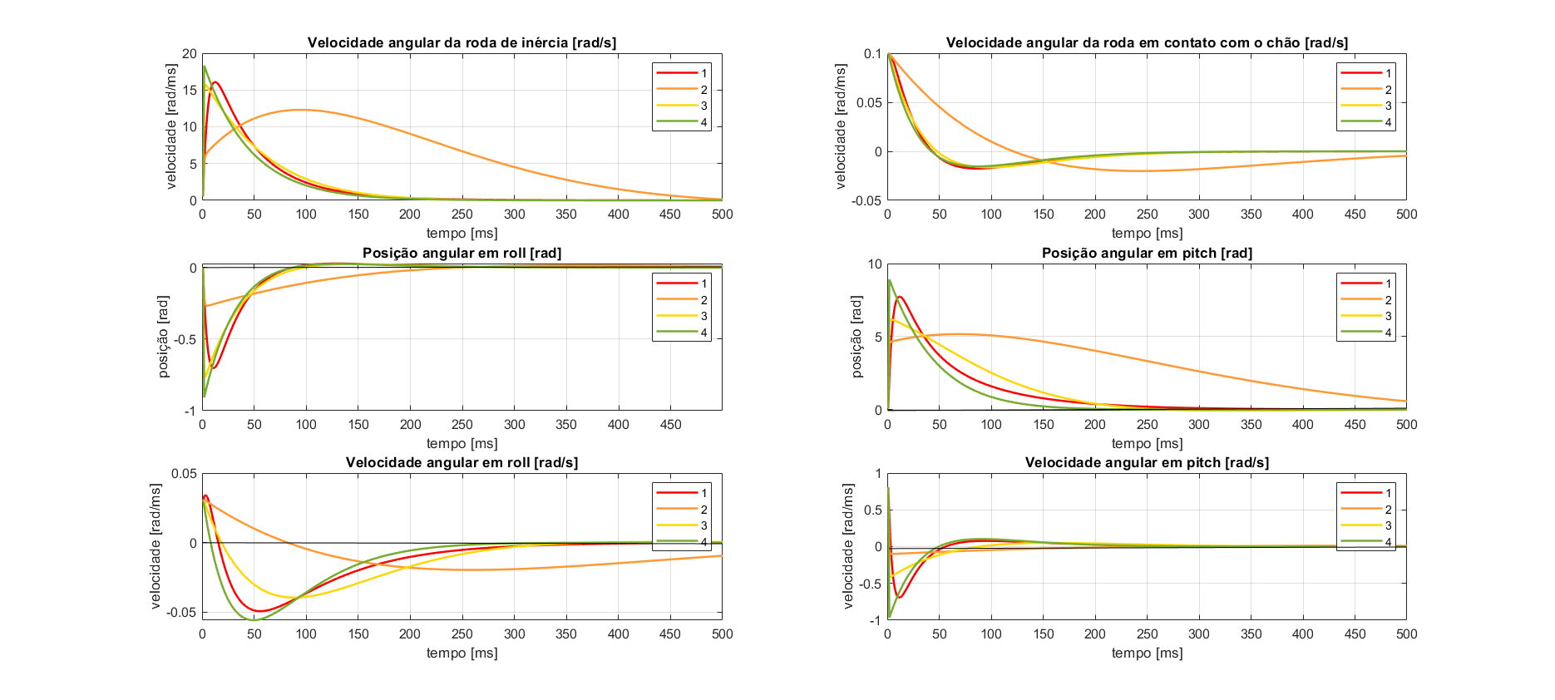
figuras/lqr_fine-tune.png
