sharpiestealr/mono/figuras/test1_lqr_fine-tune.png

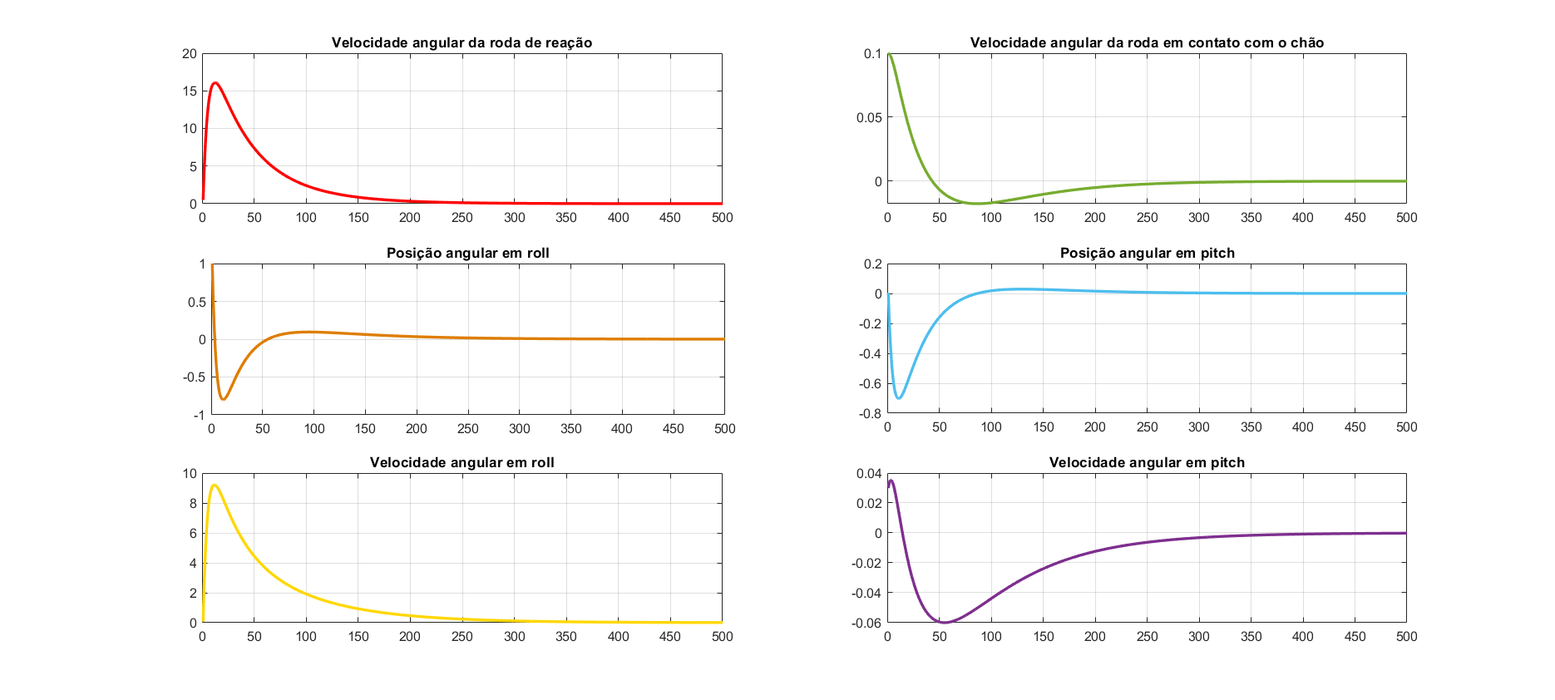
figuras/test1_lqr_fine-tune.png
