sharpiestealr/mono/cad/acoplamento.pdf

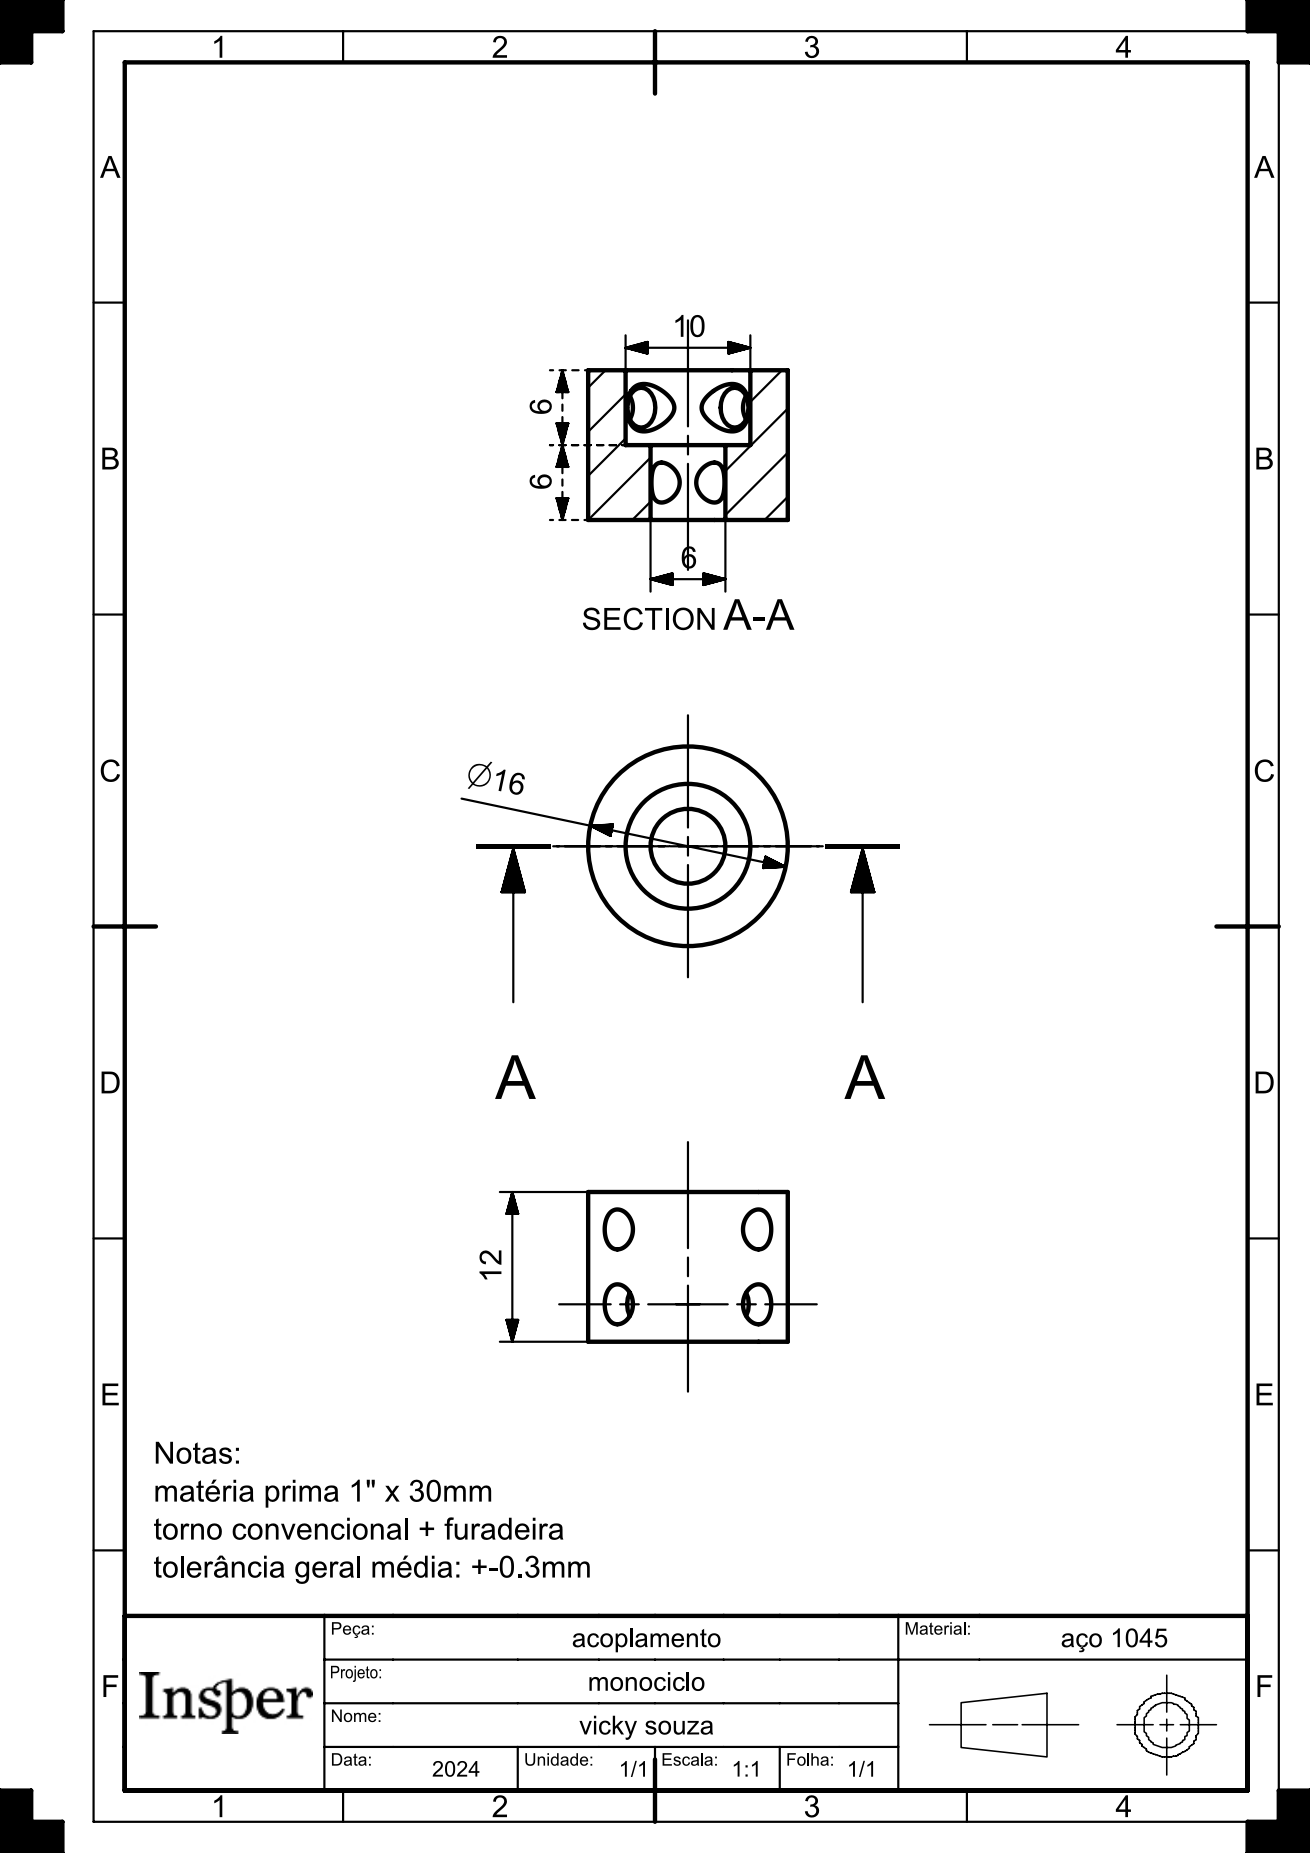
[picture p125: page 1]
