sharpiestealr/mono/cad/dtms.pdf

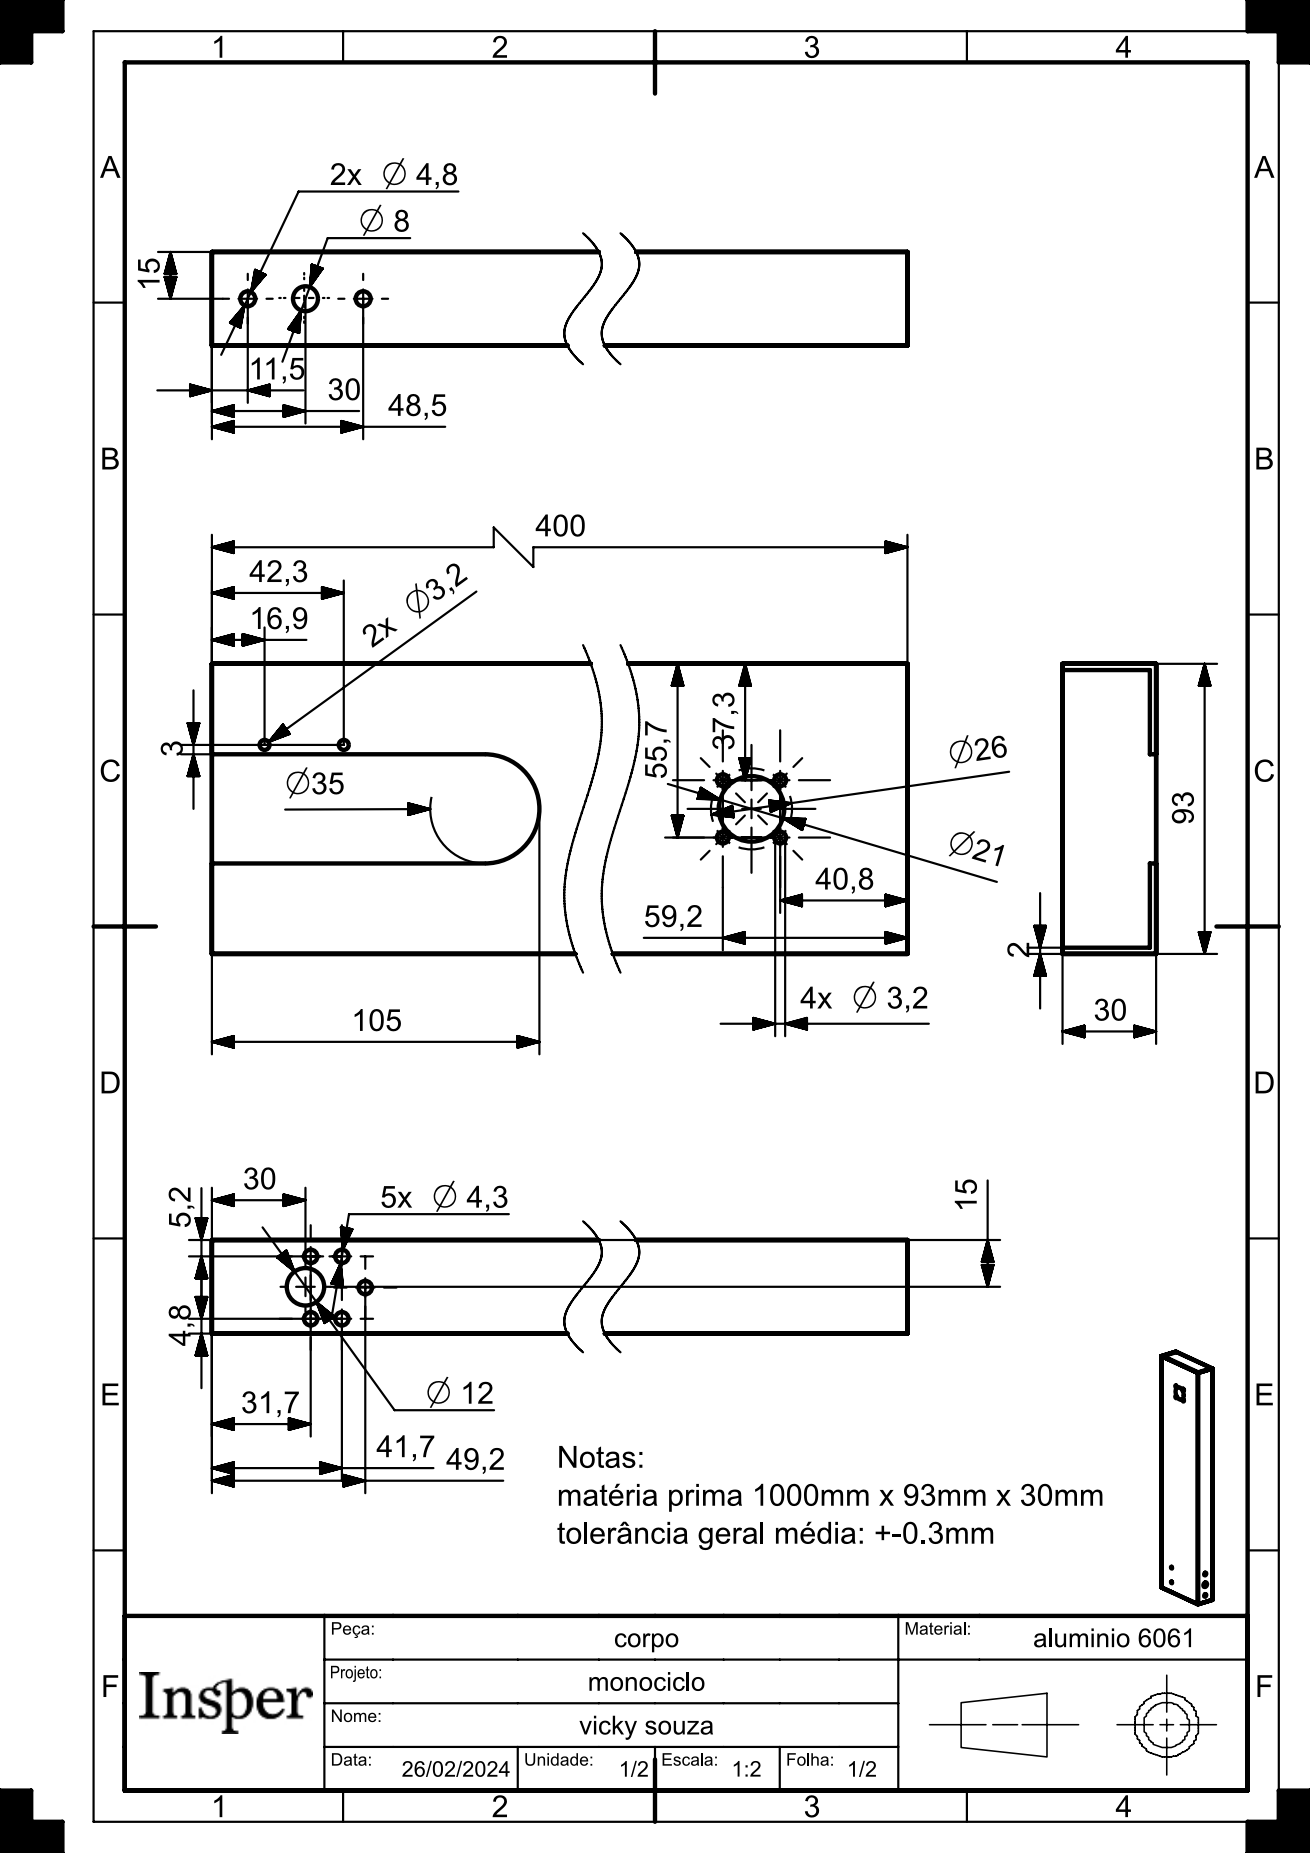
[picture p126: page 1]

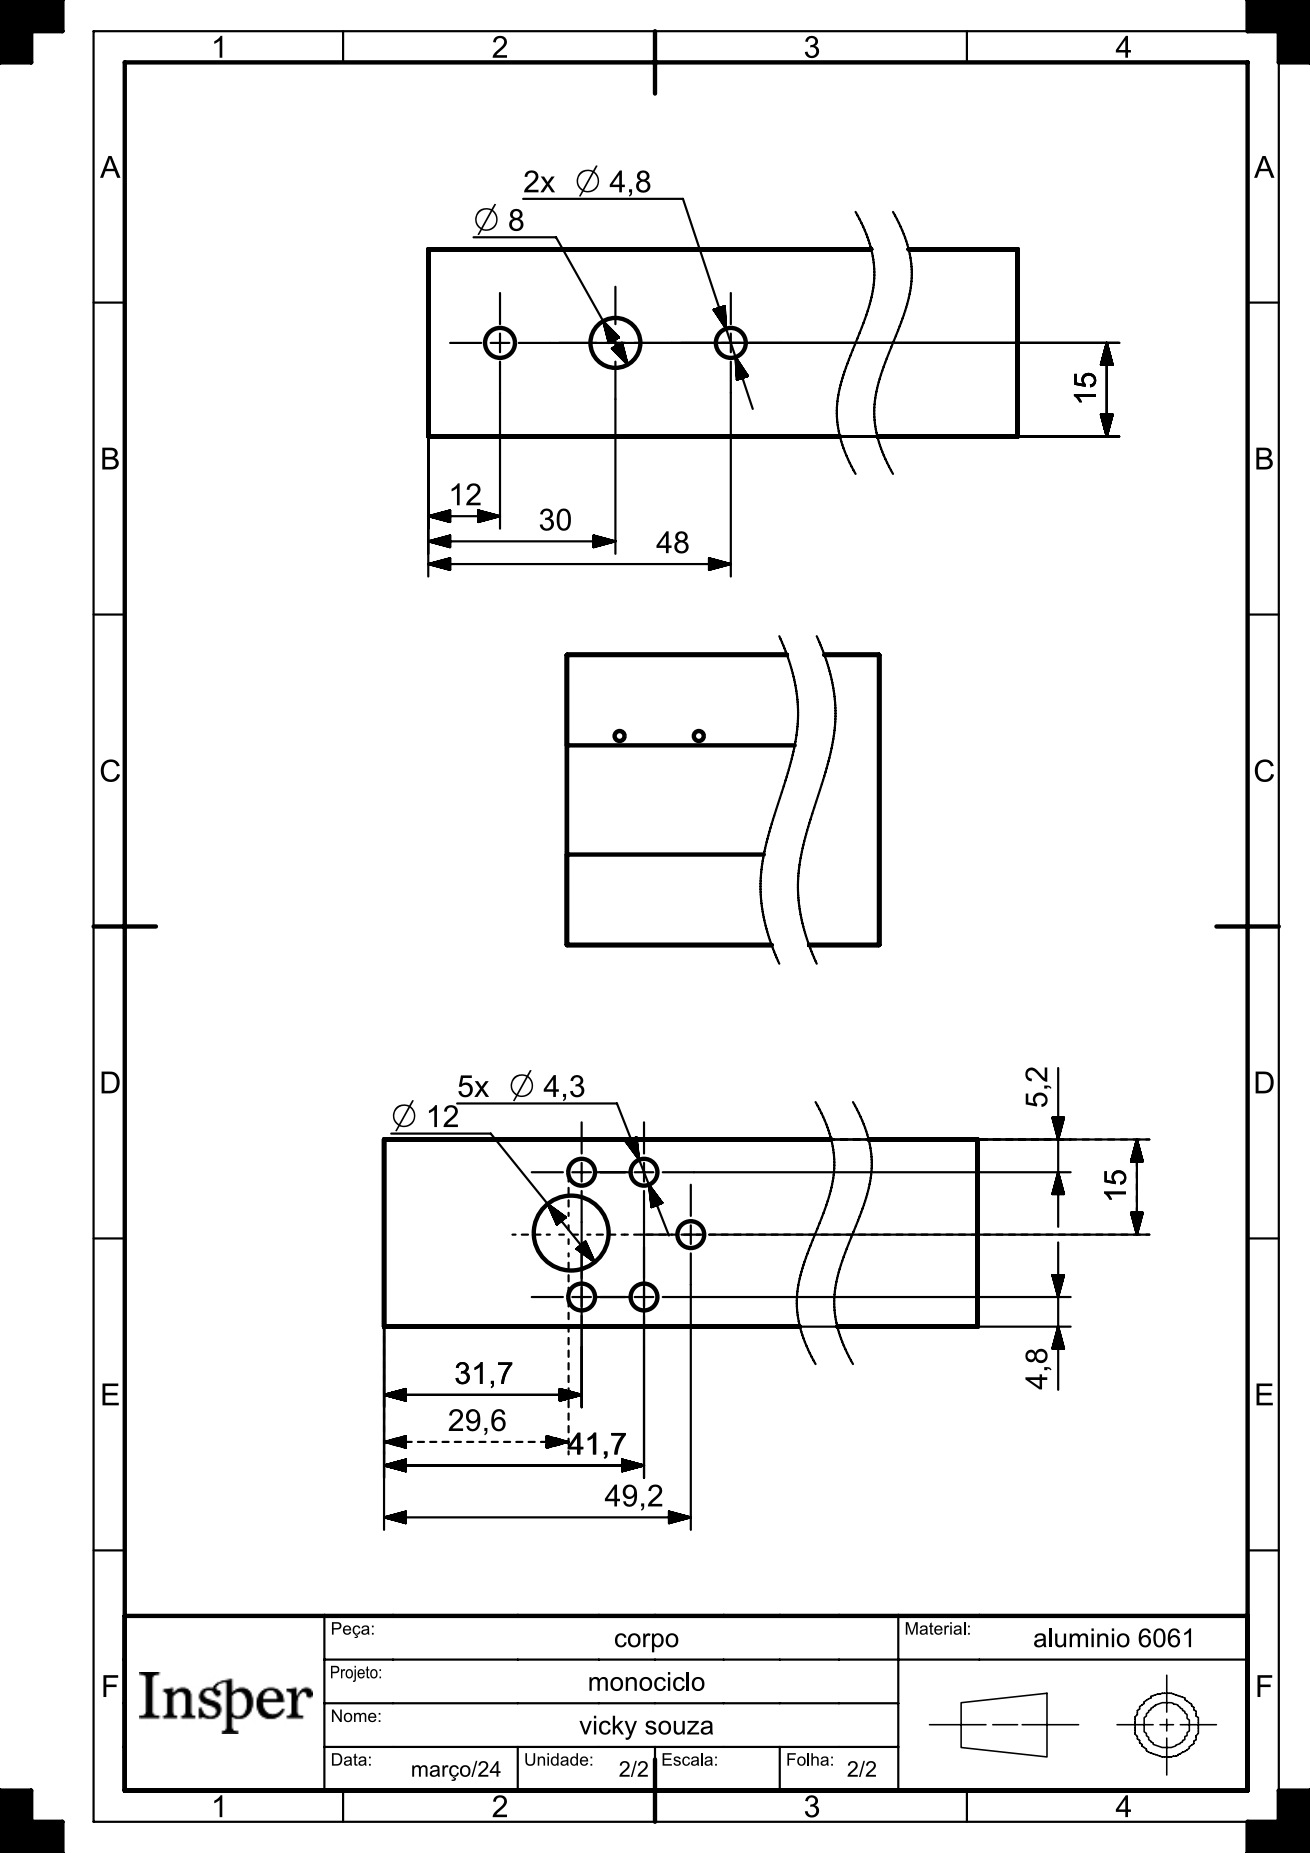
[picture p127: page 2]

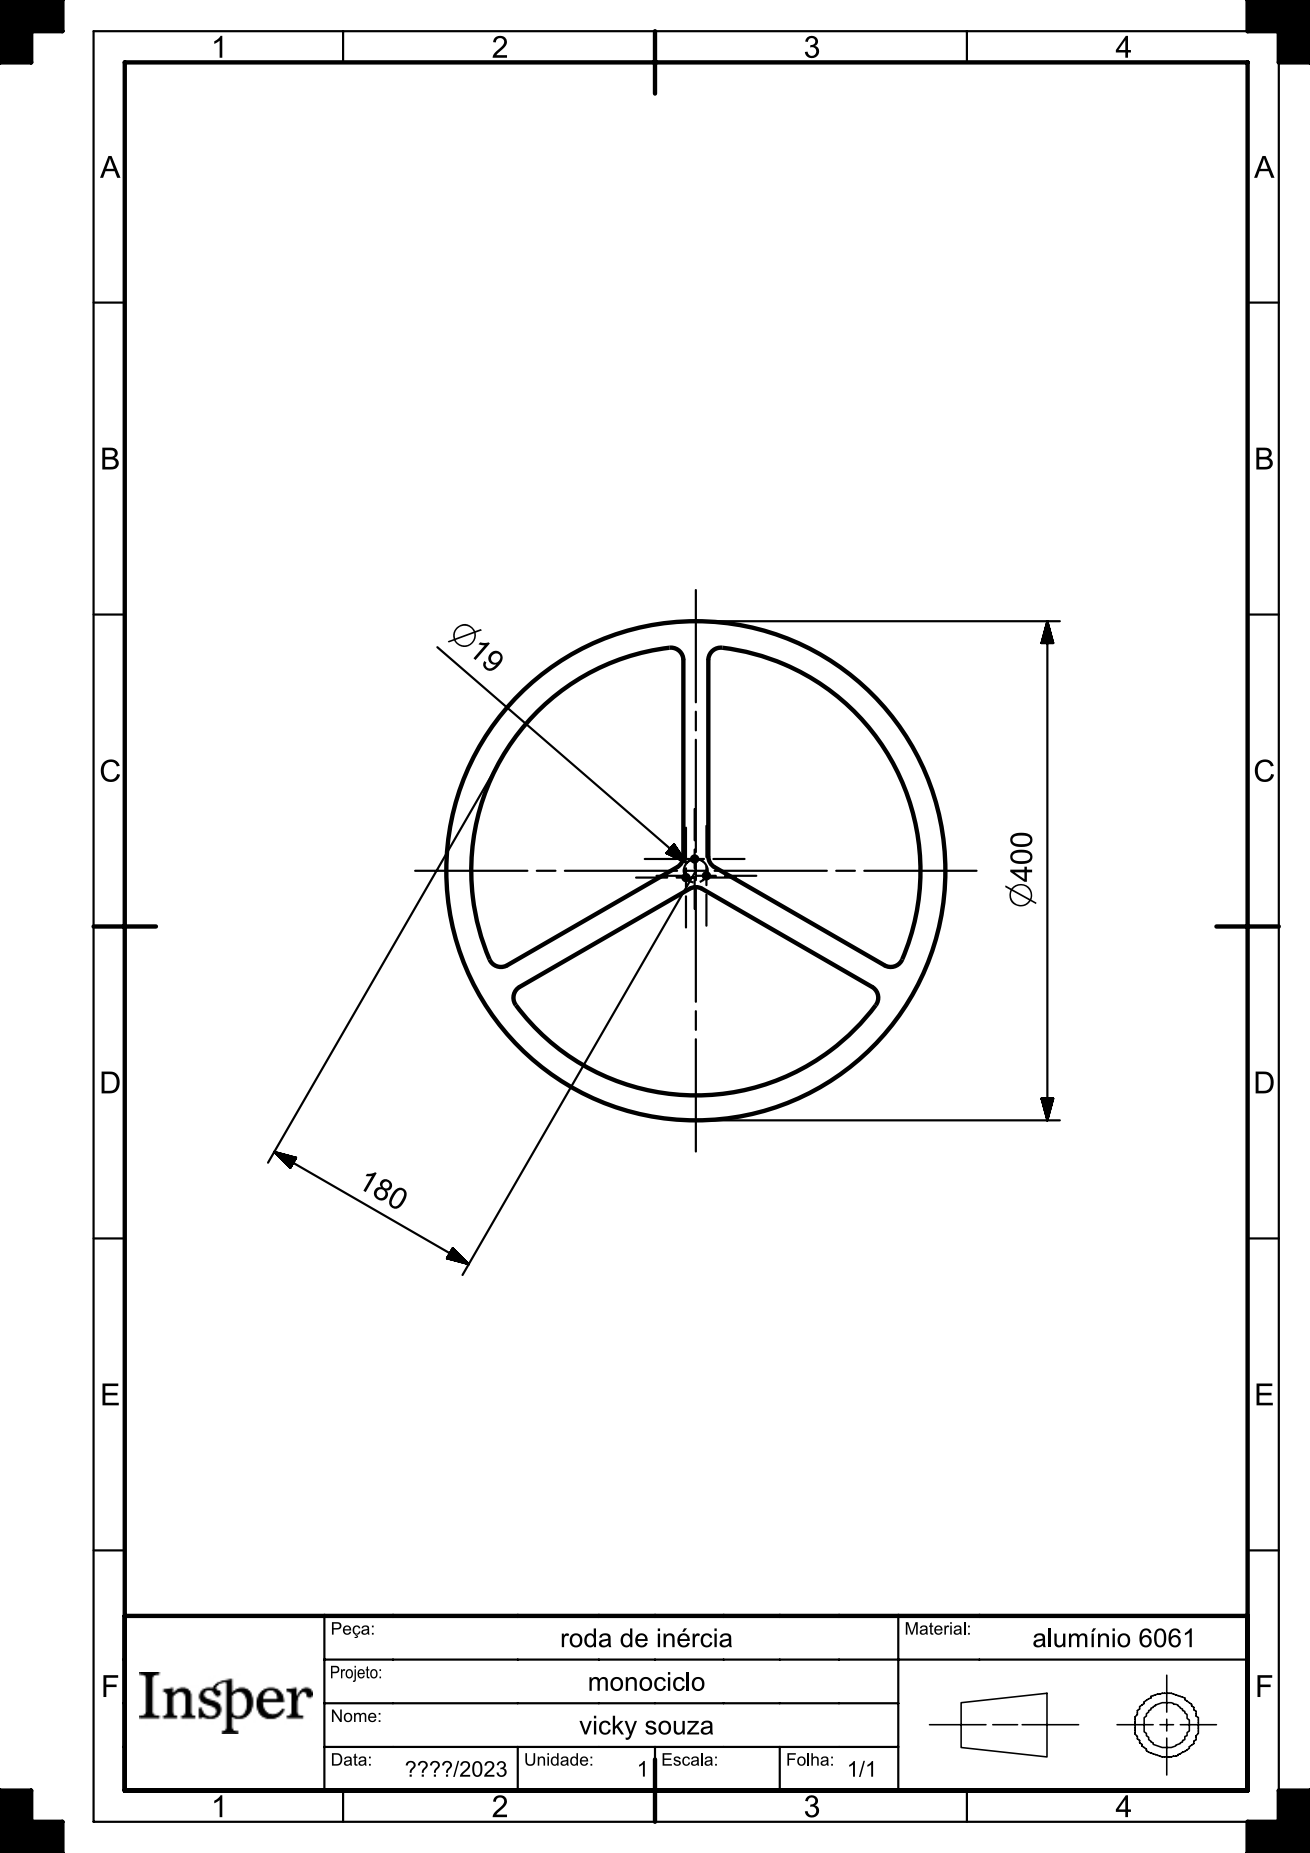
[picture p128: page 3]

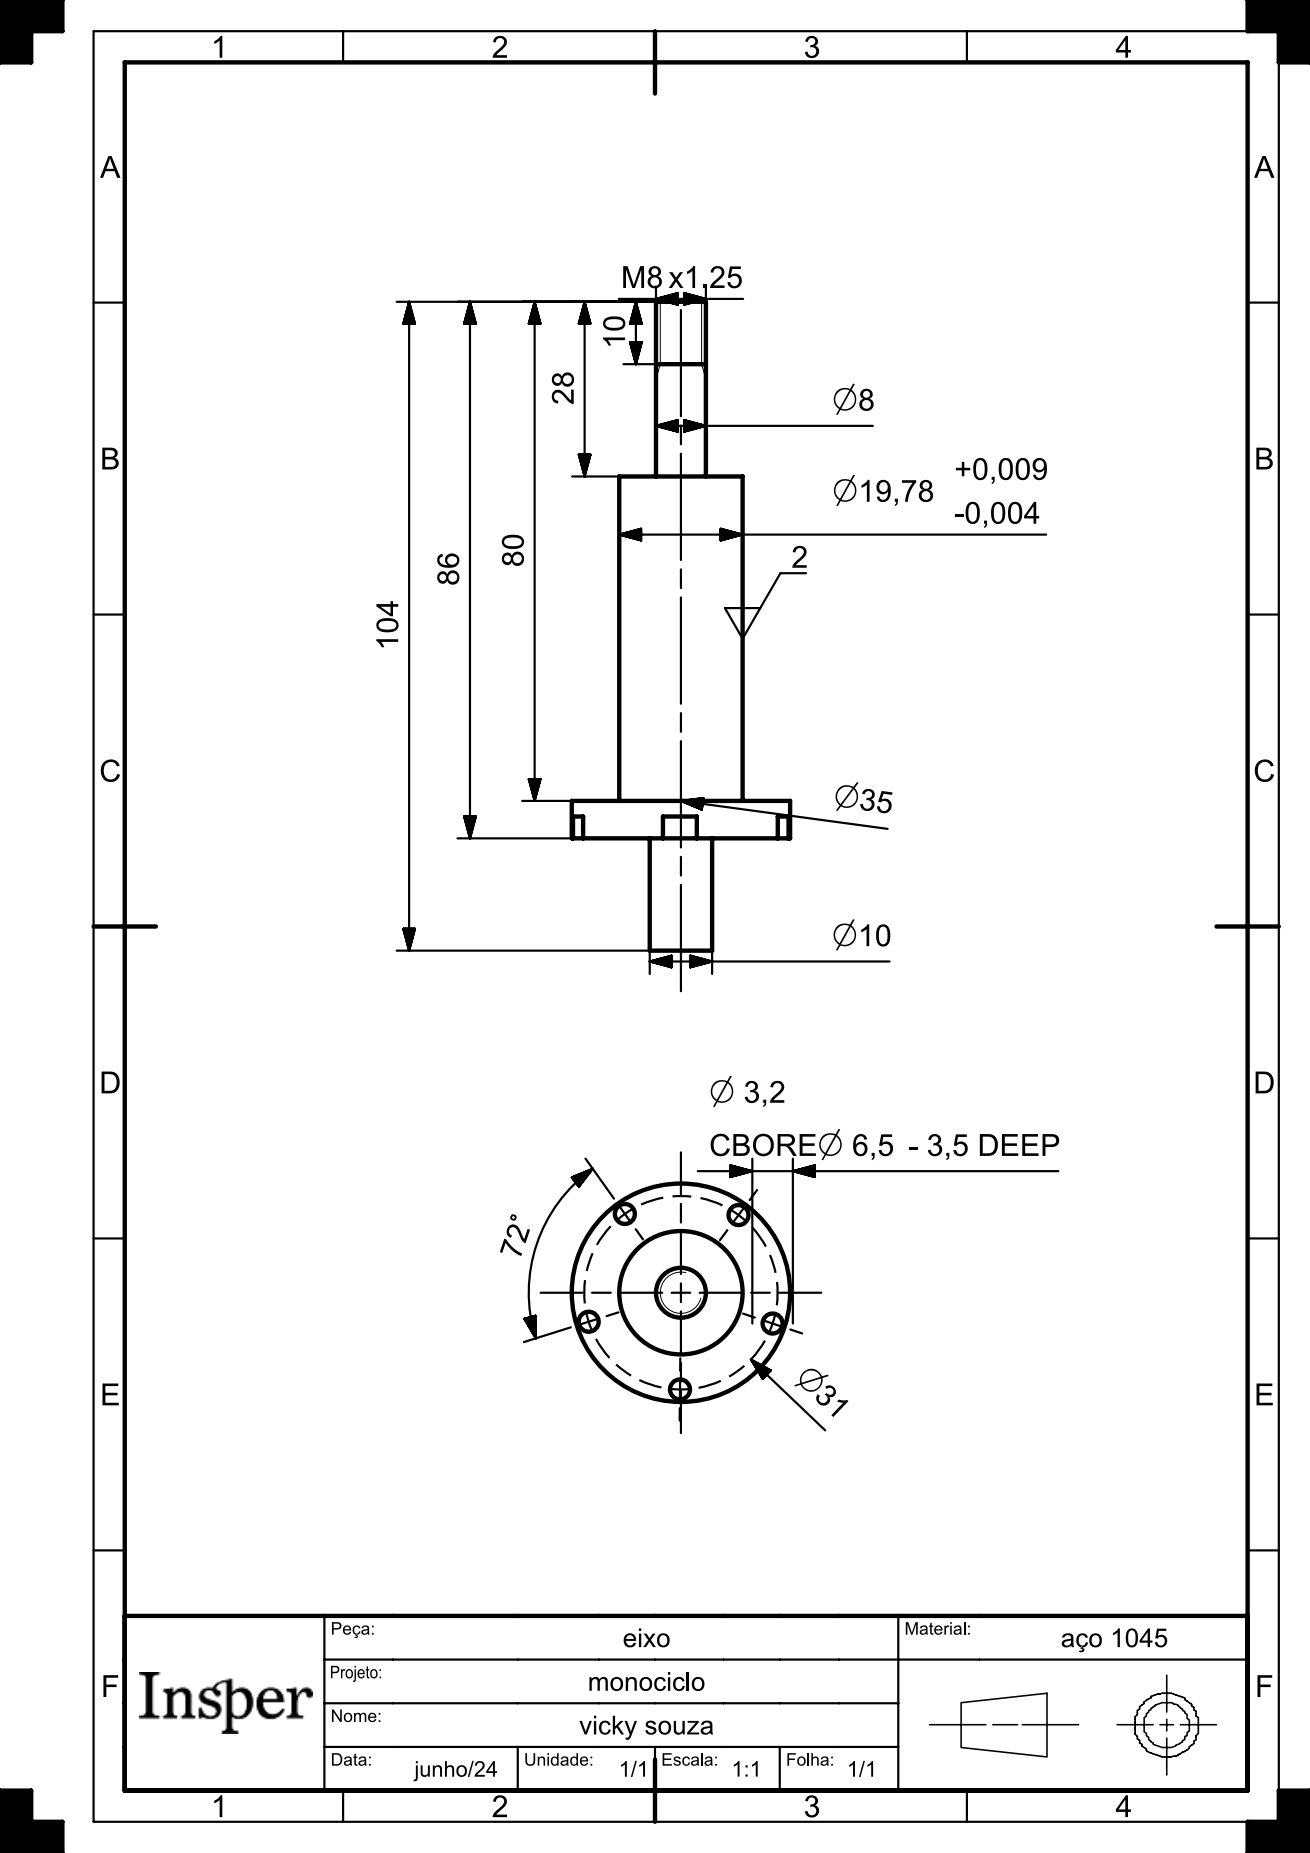
[picture p129: page 4]

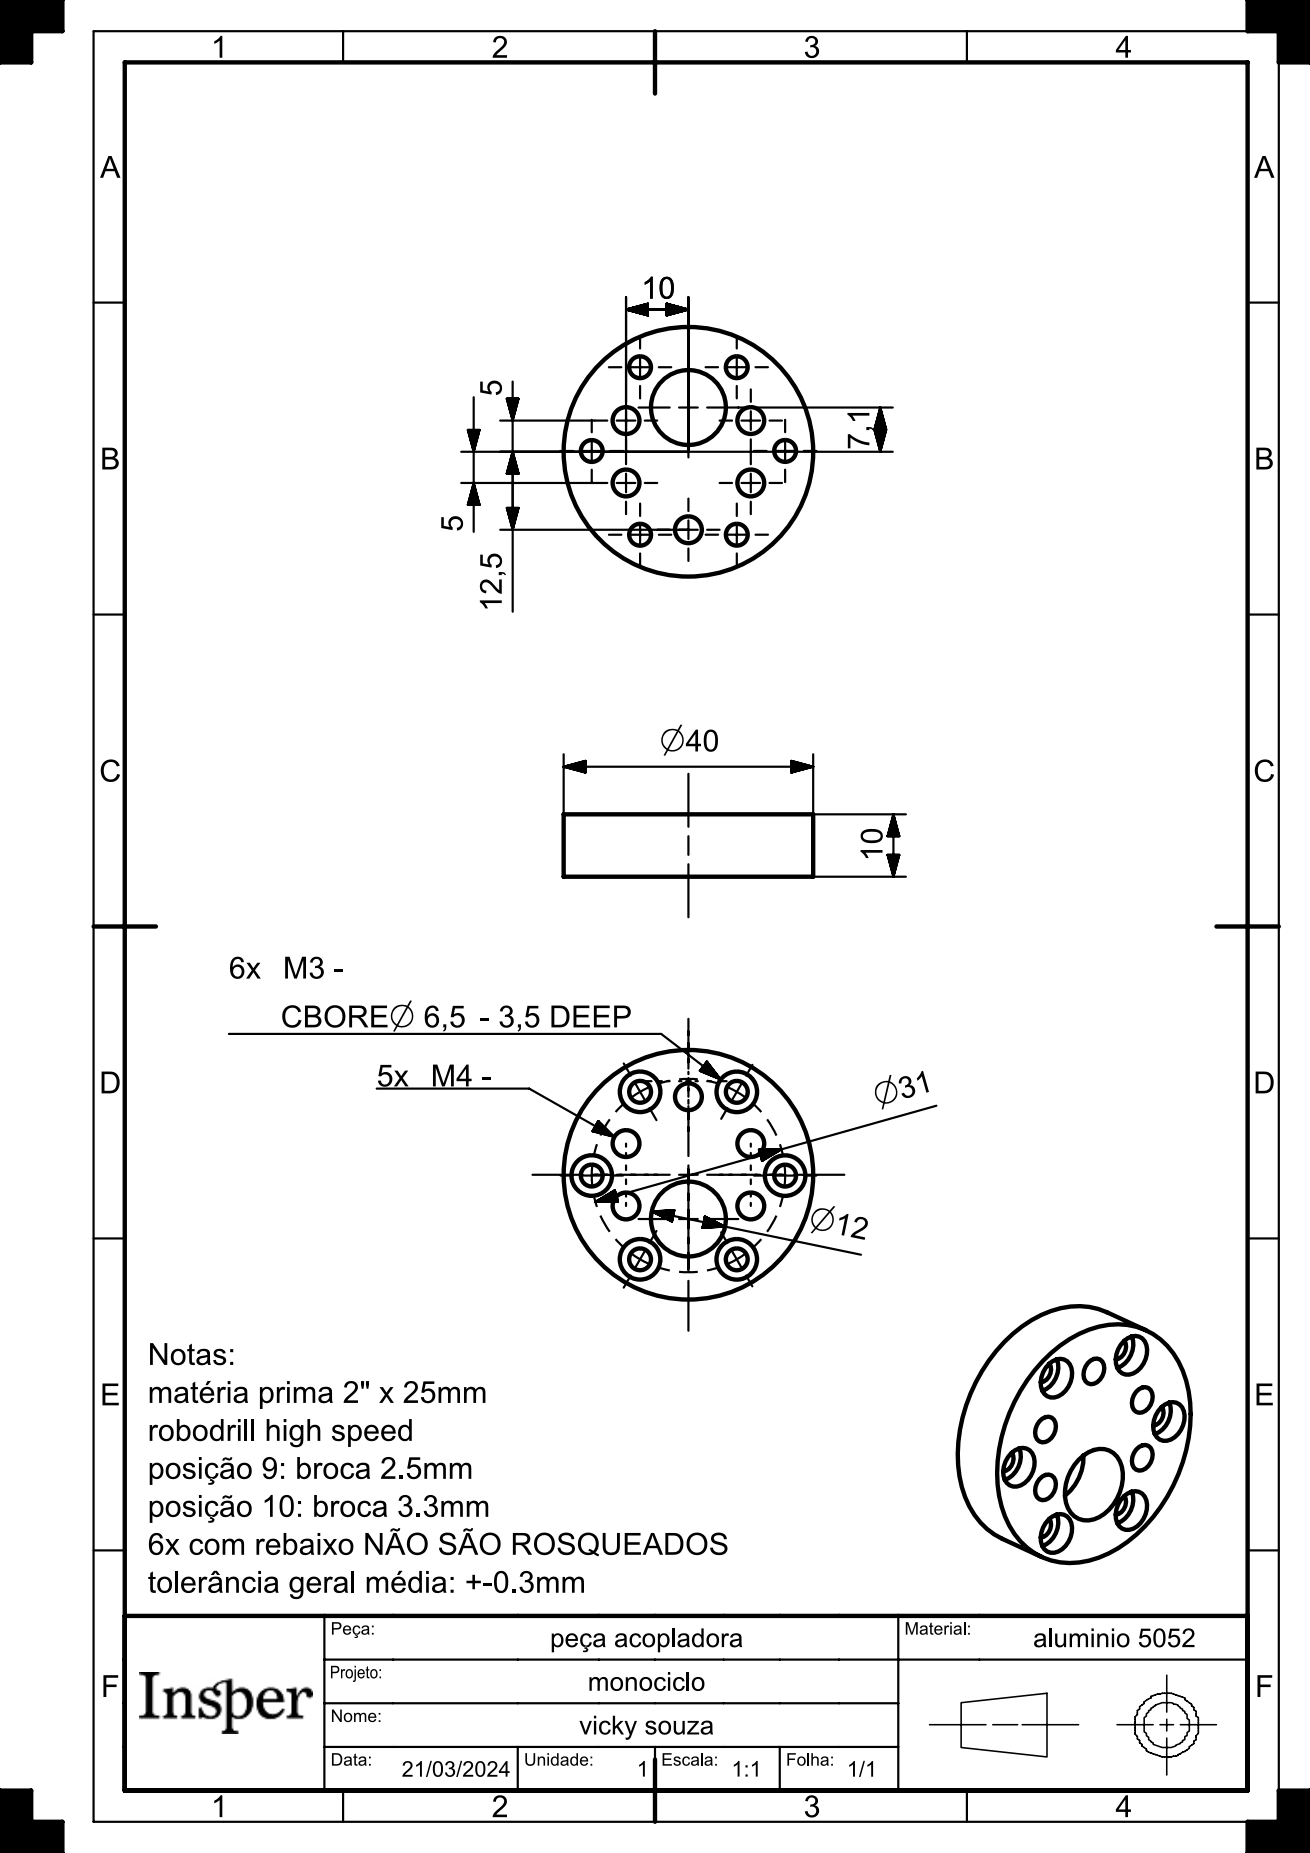
[picture p130: page 5]

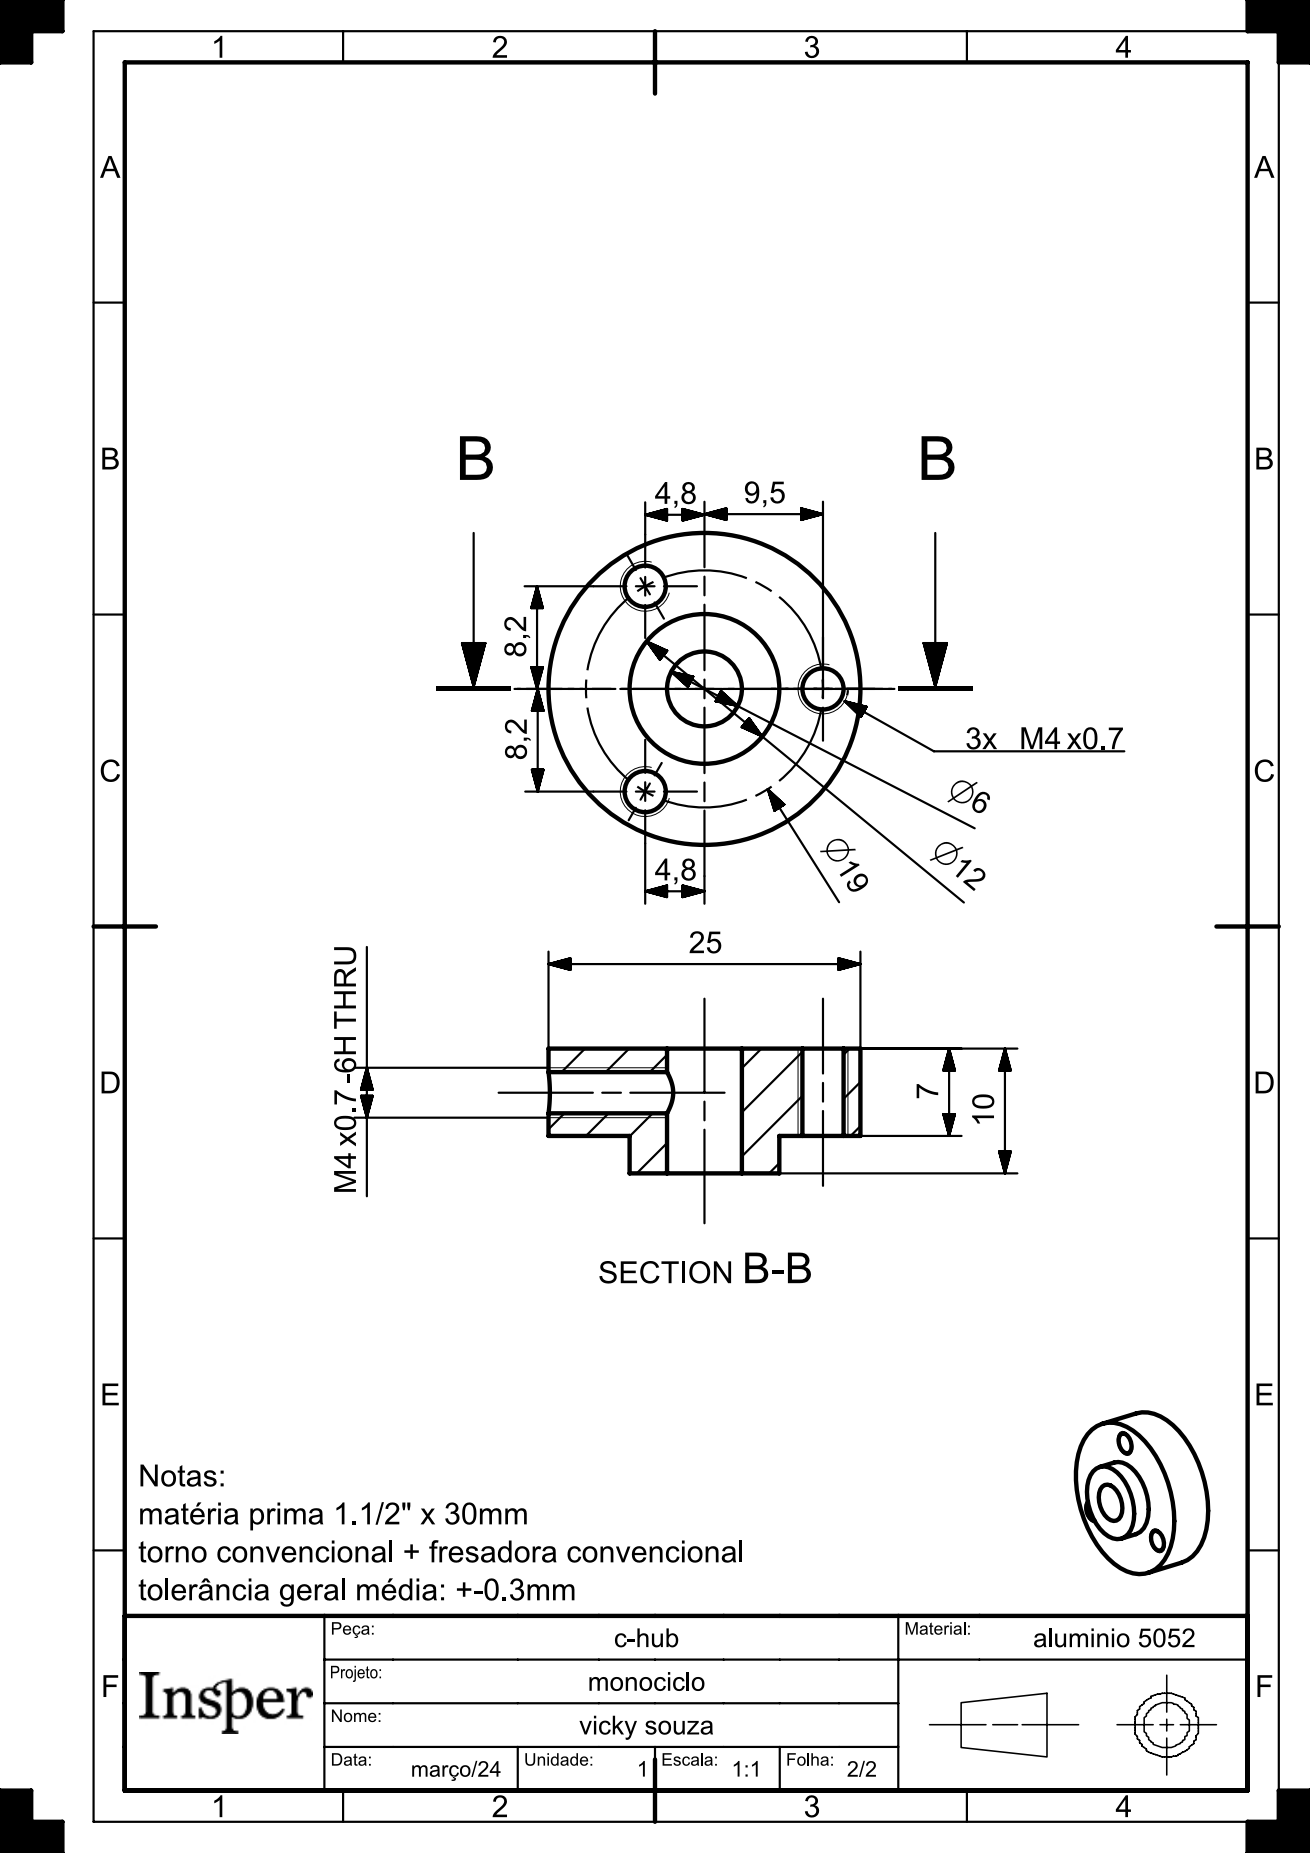
[picture p131: page 6]

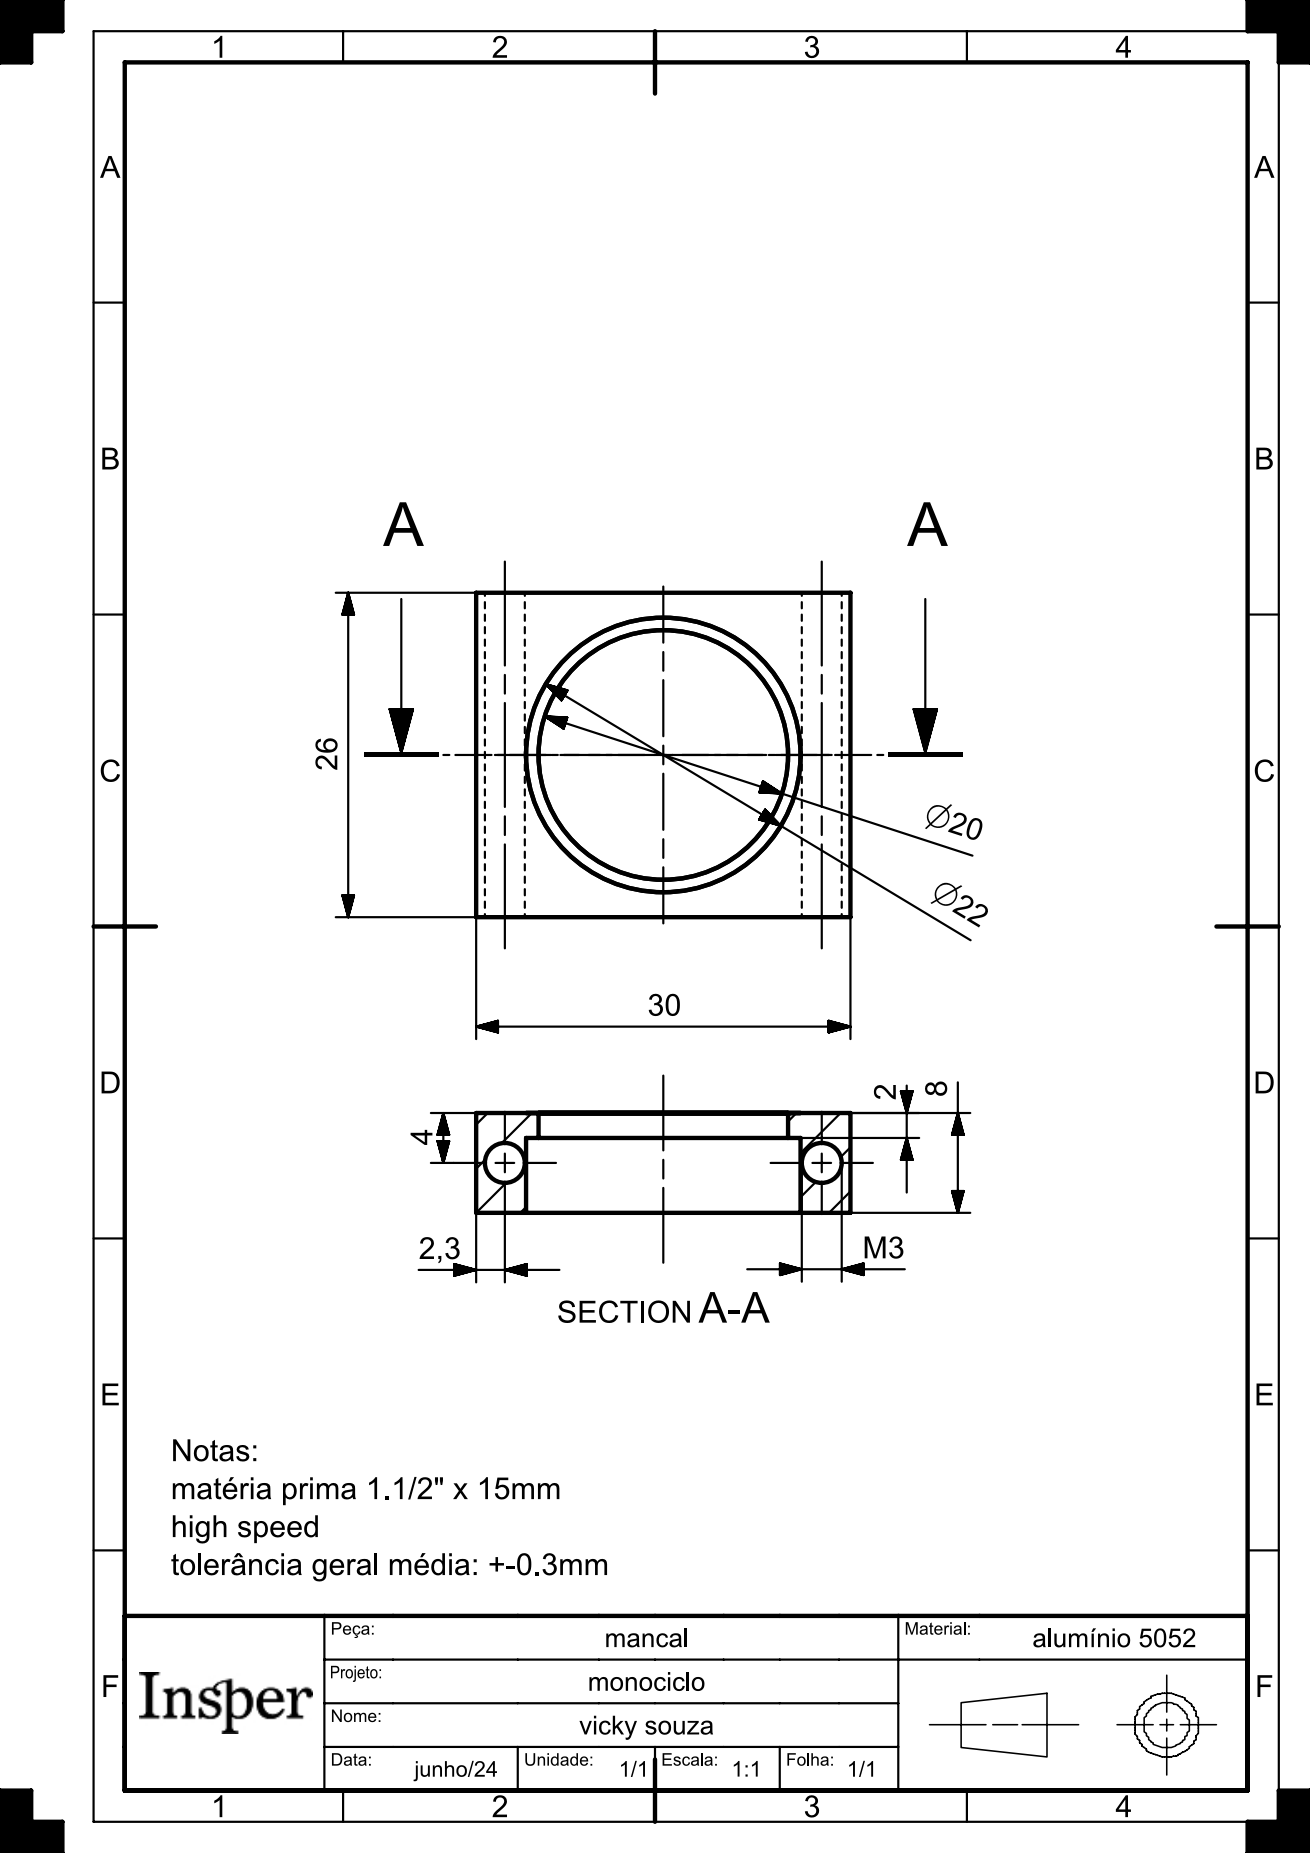
[picture p132: page 7]


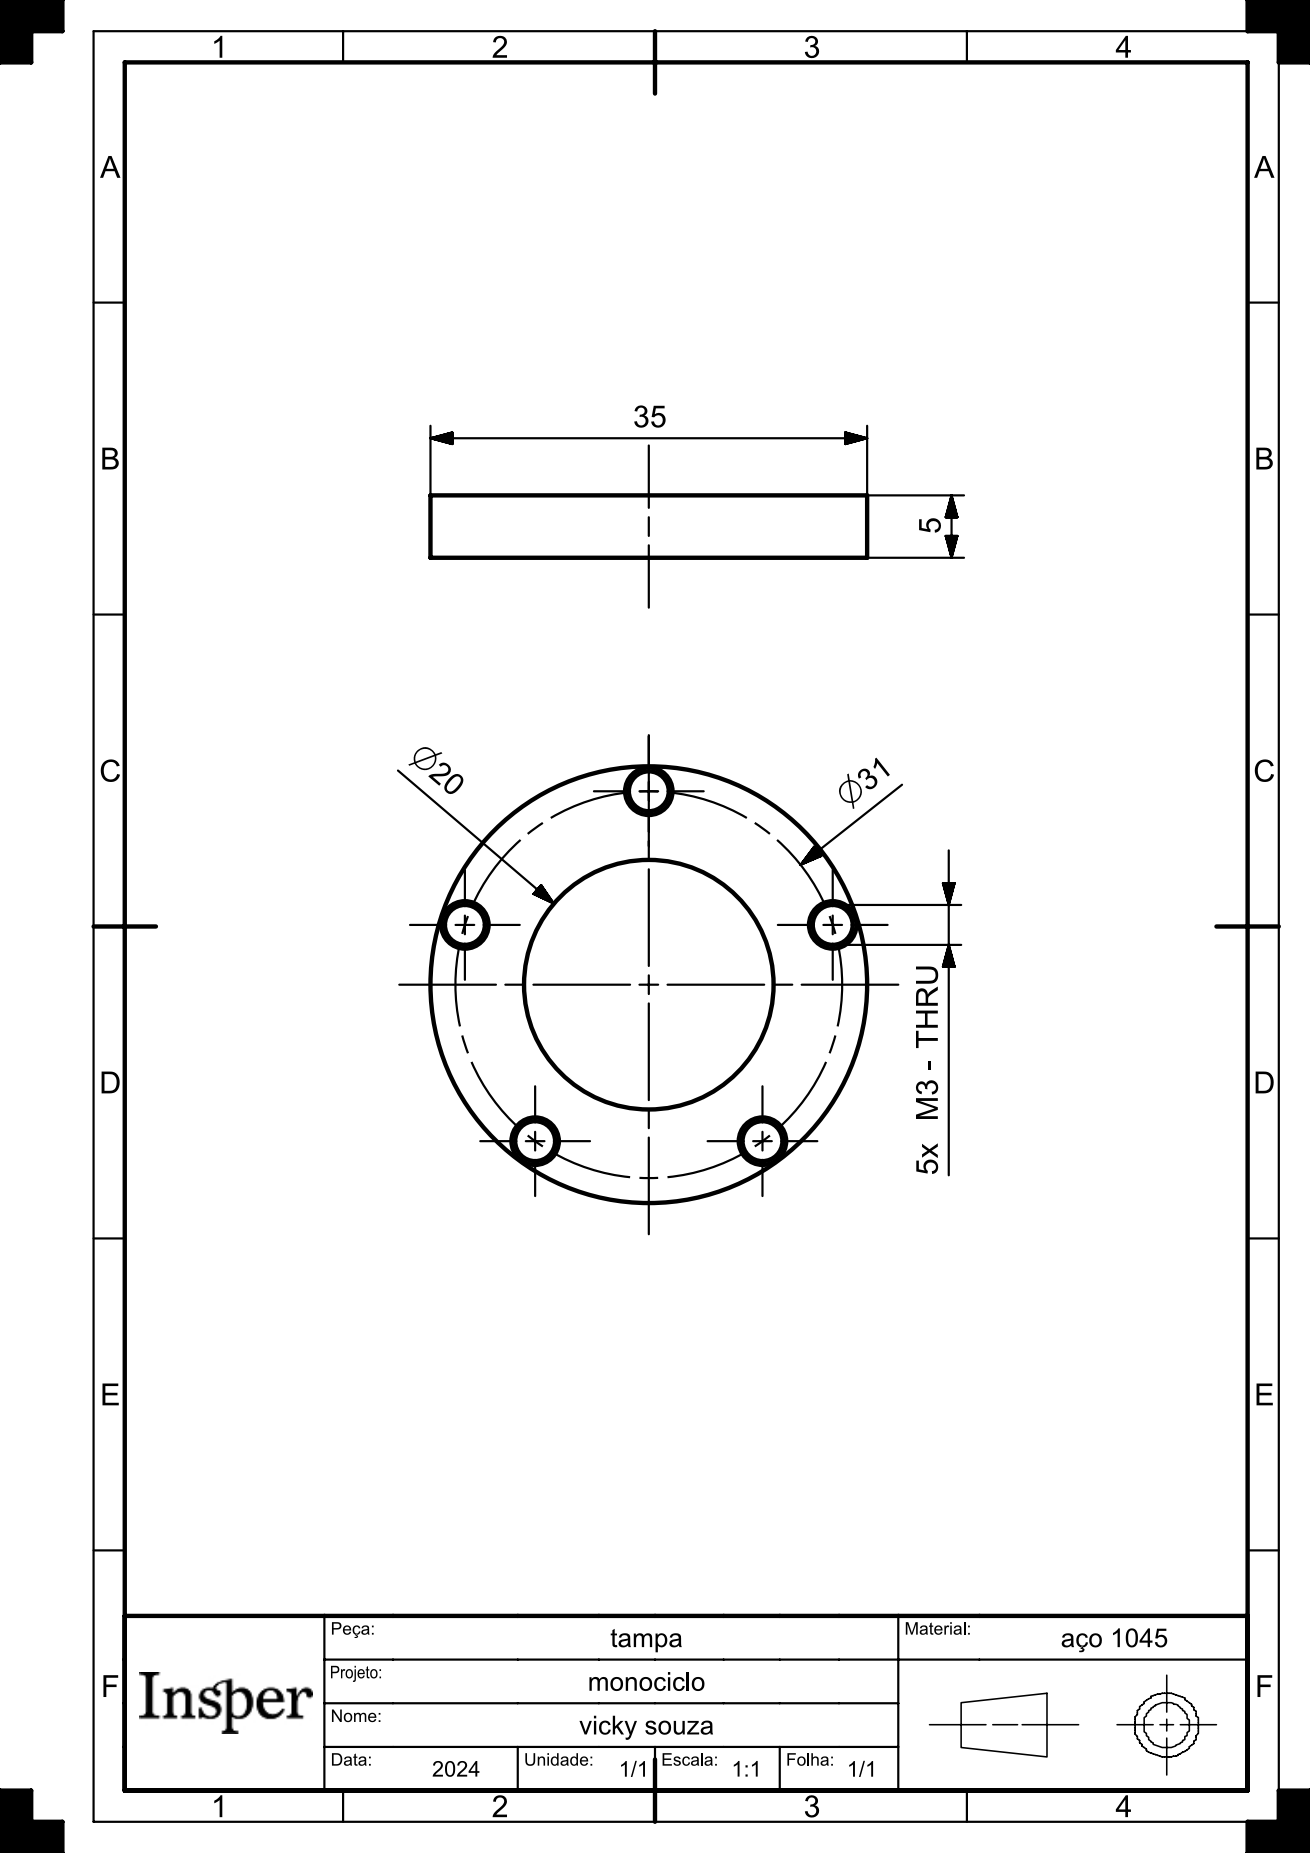
[picture p133: page 9]
