sharpiestealr/mono/cad/cuerpo.pdf

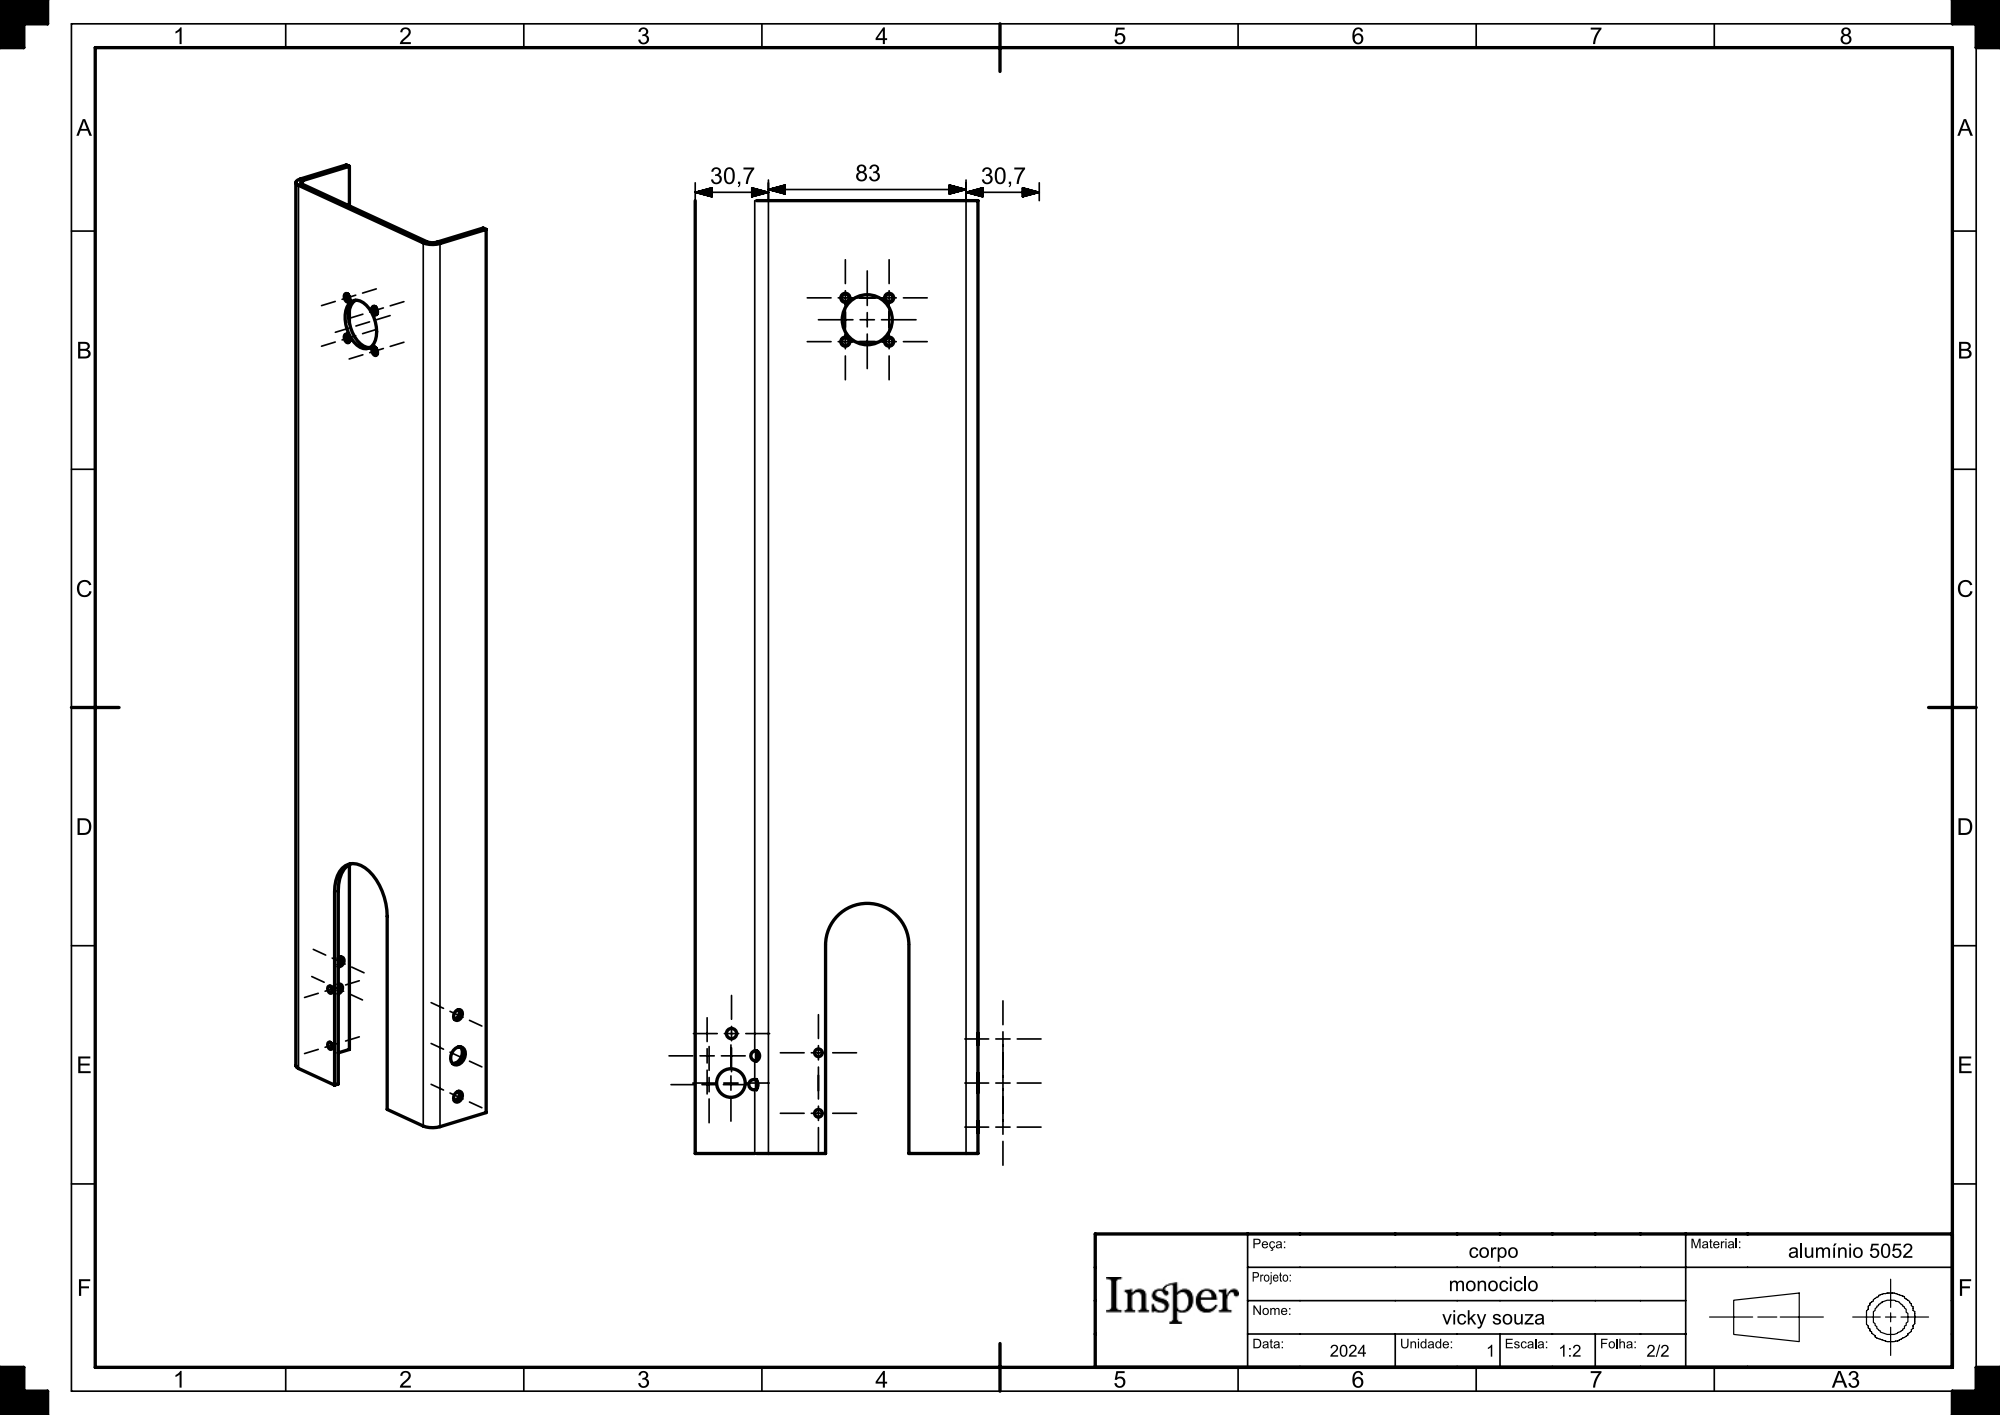
[picture p134: page 1]
