sharpiestealr/mono/cad/bucha v2.pdf

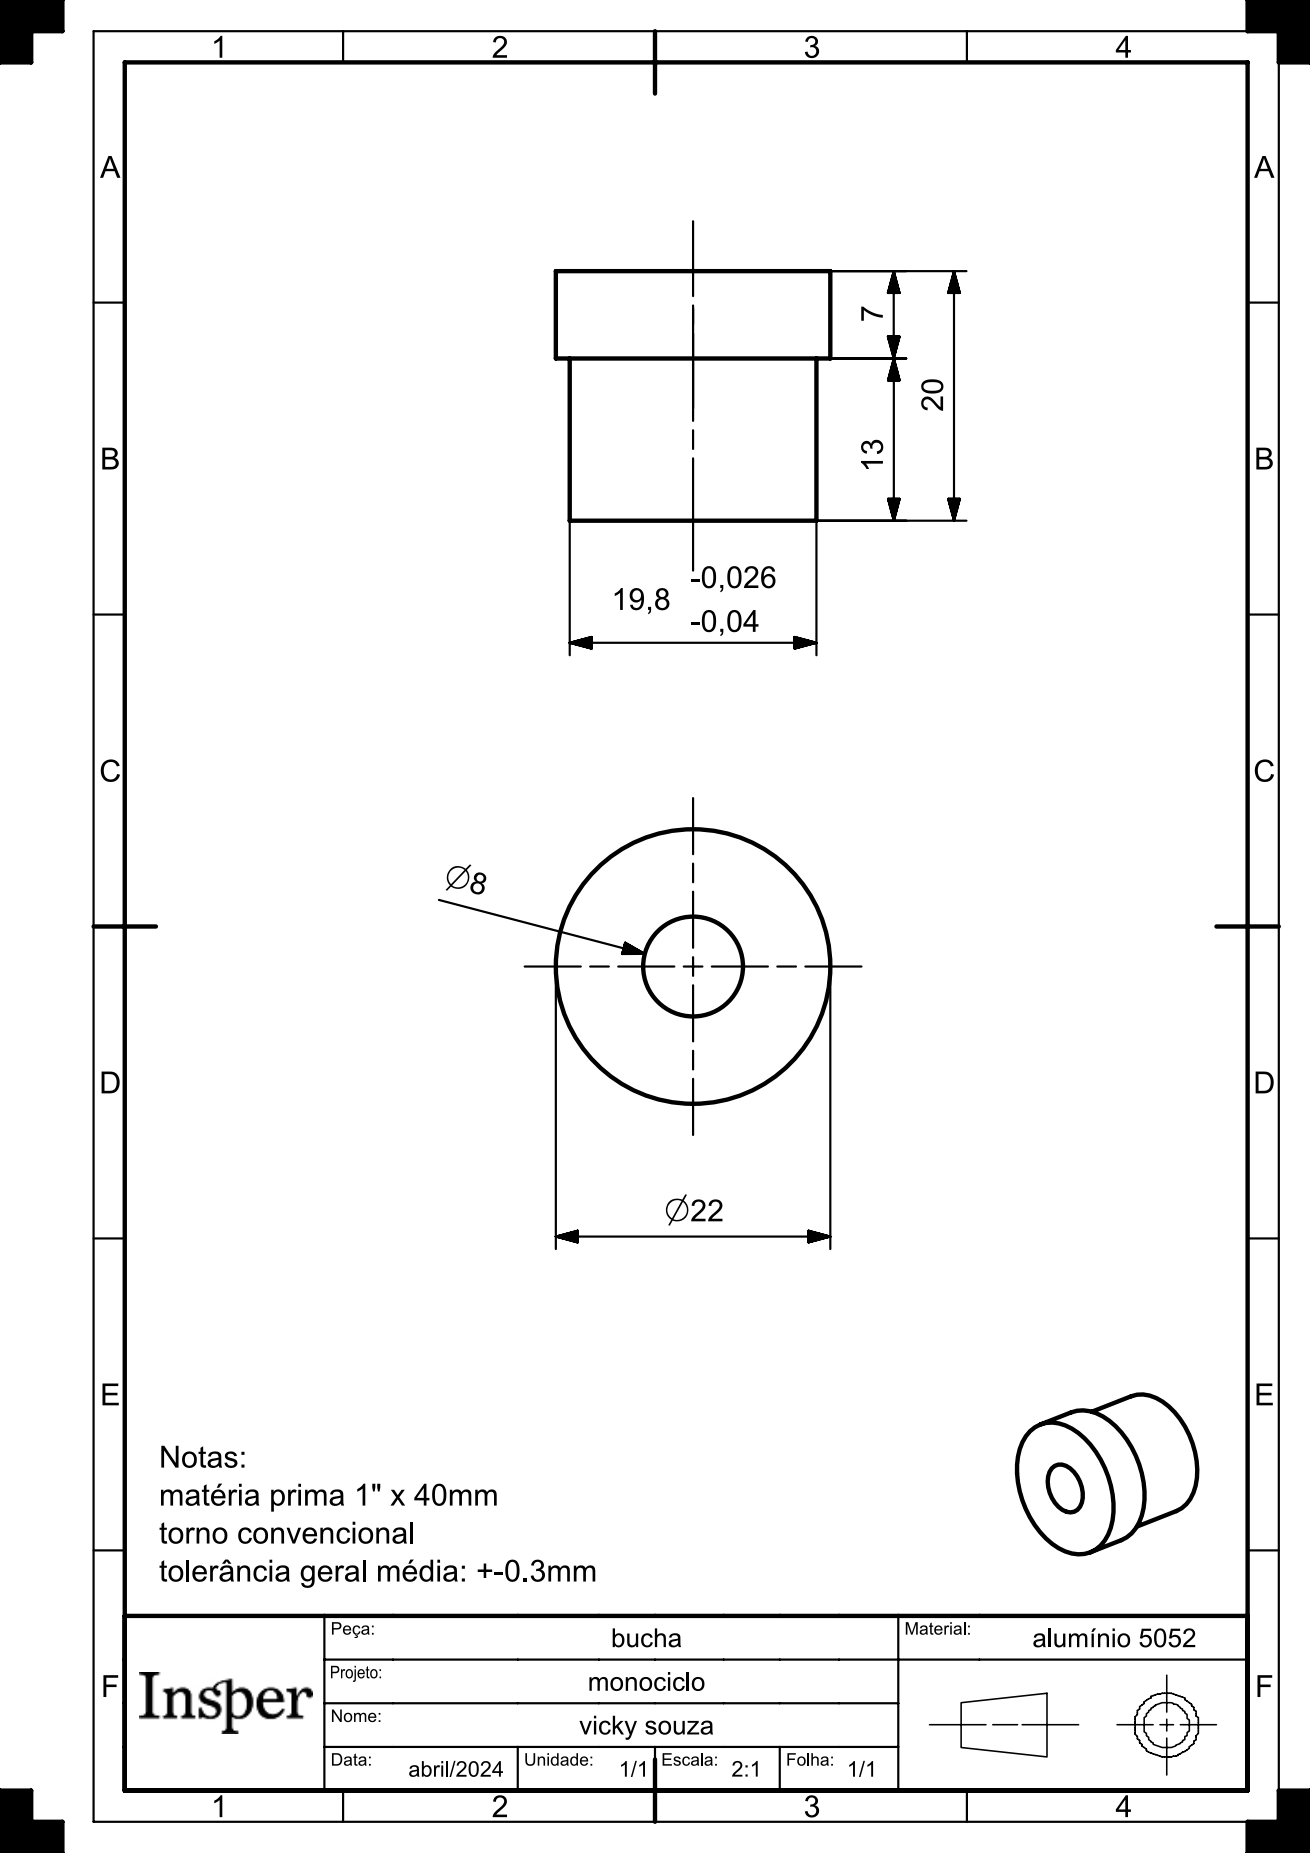
[picture p135: page 1]
