sharpiestealr/mono/cad/corpo.pdf

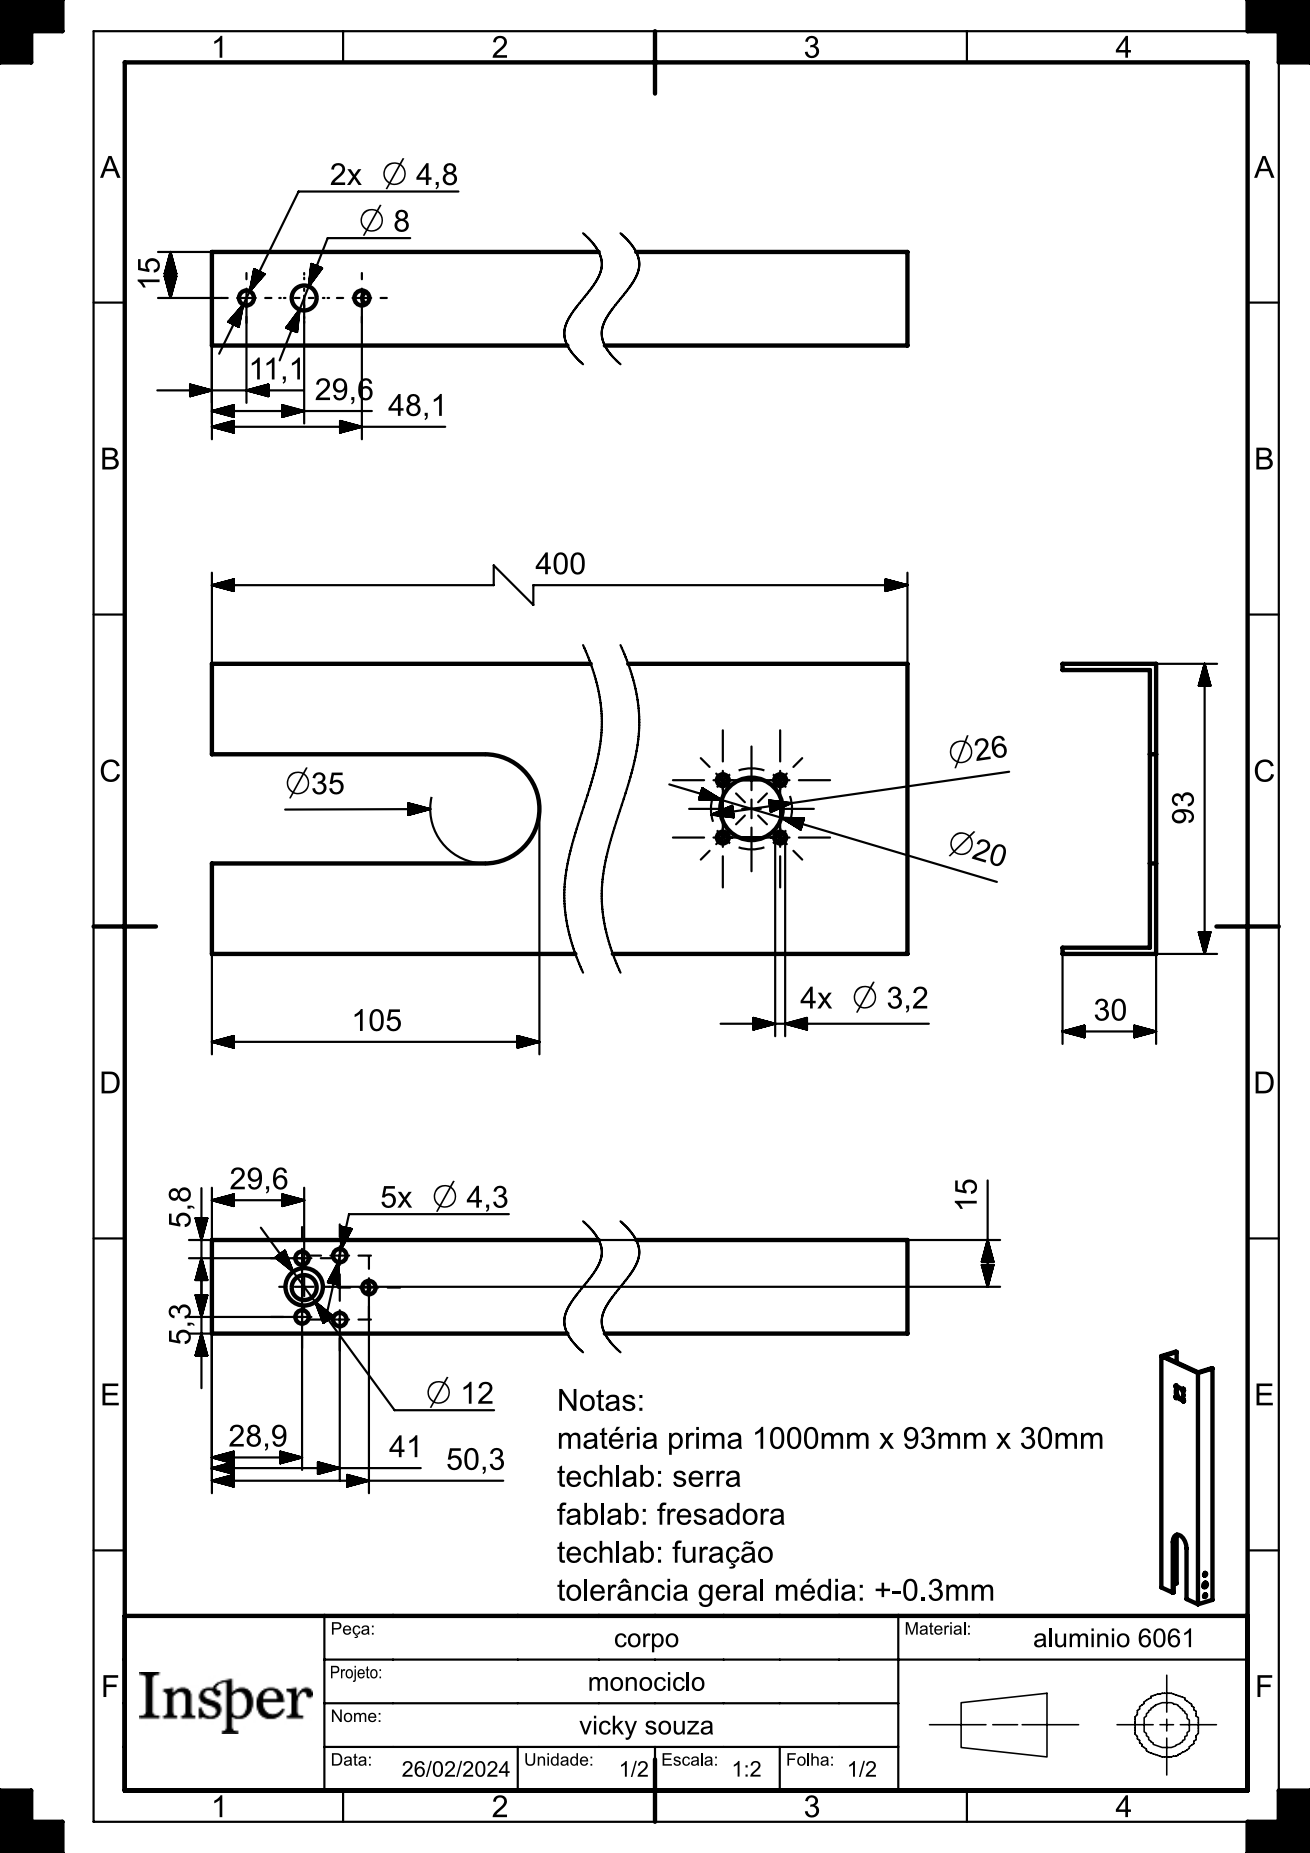
[picture p136: page 1]

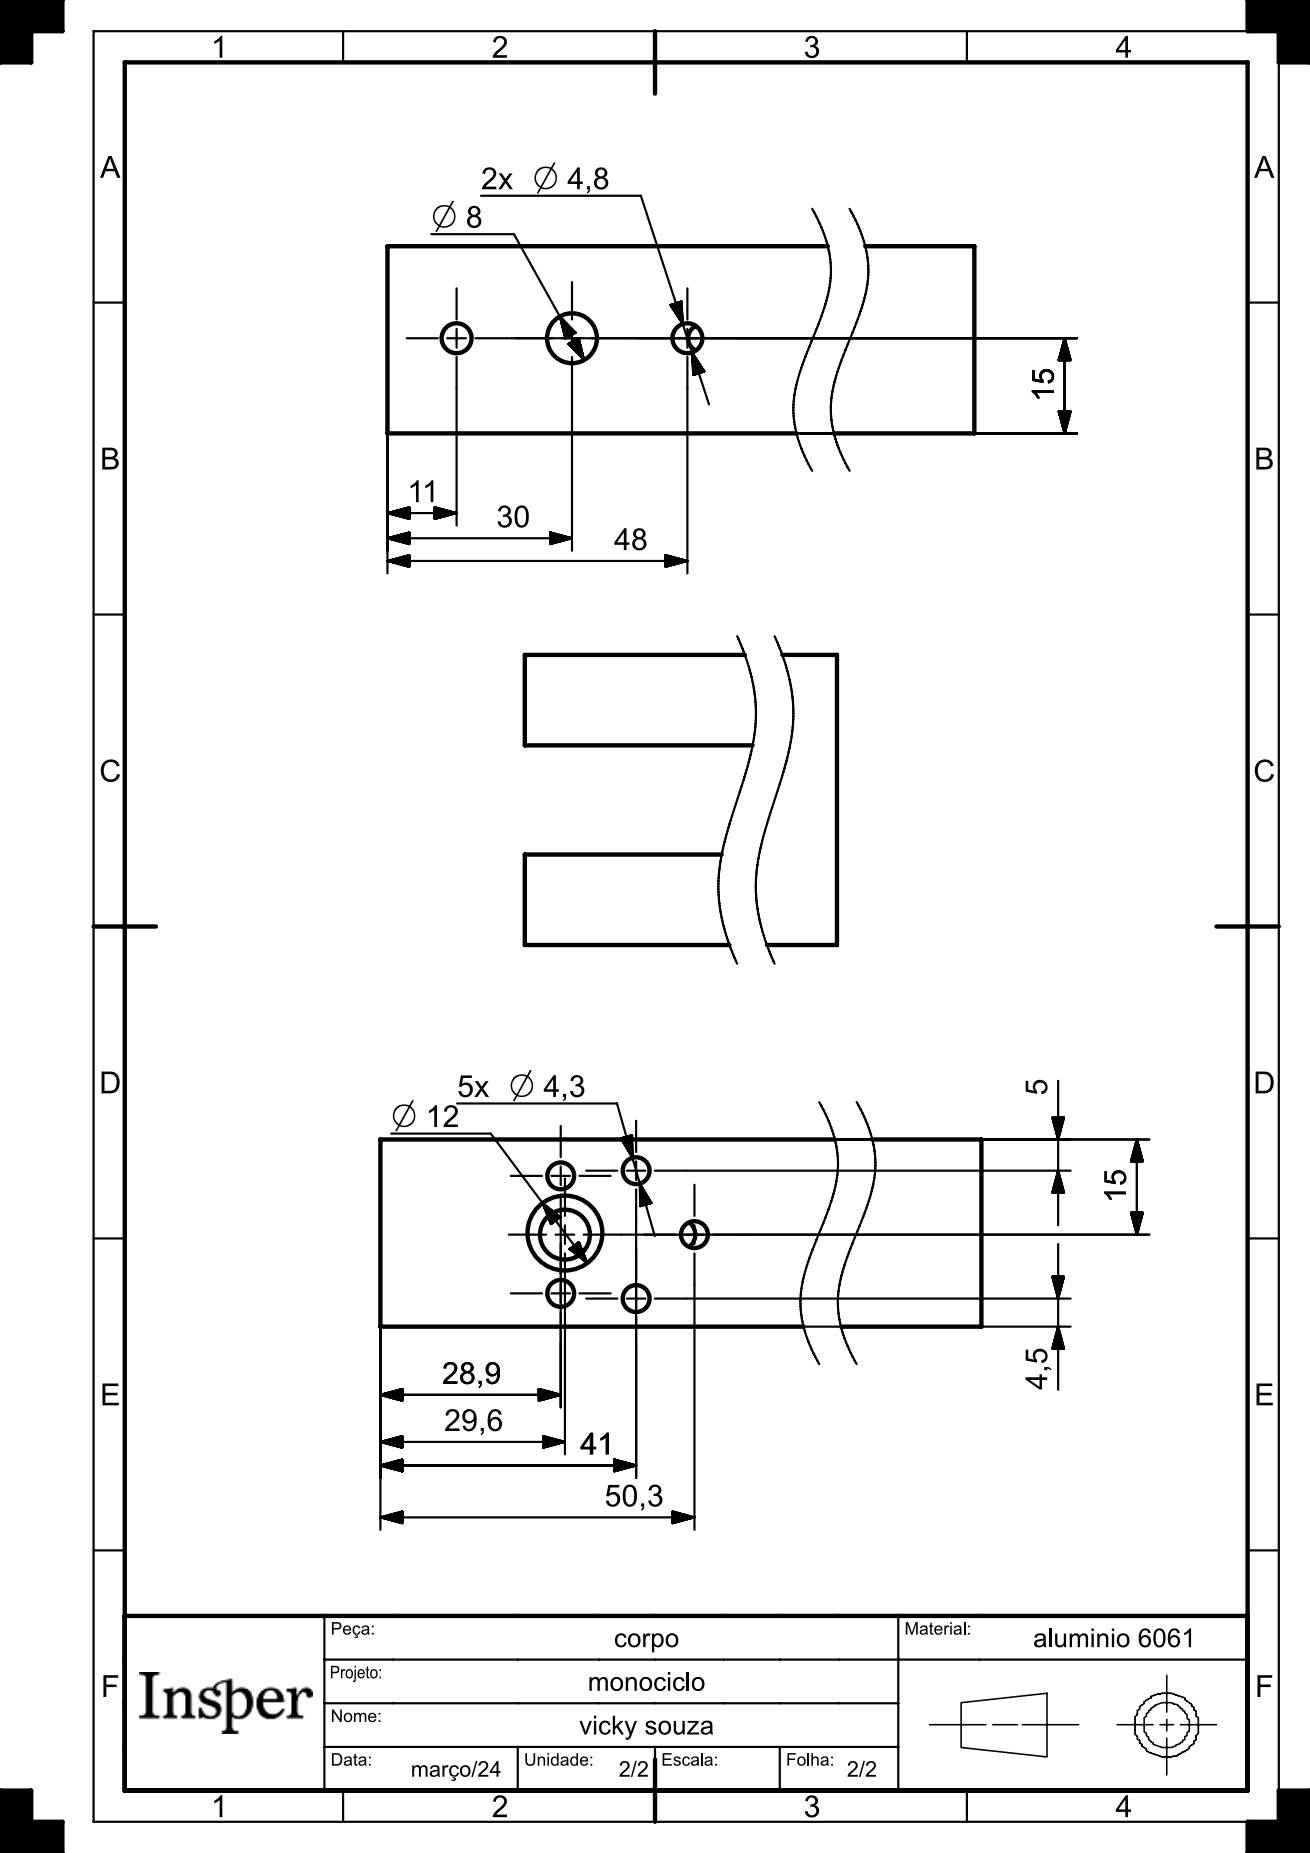
[picture p137: page 2]
