sharpiestealr/mono/cad/peça acopladora.pdf

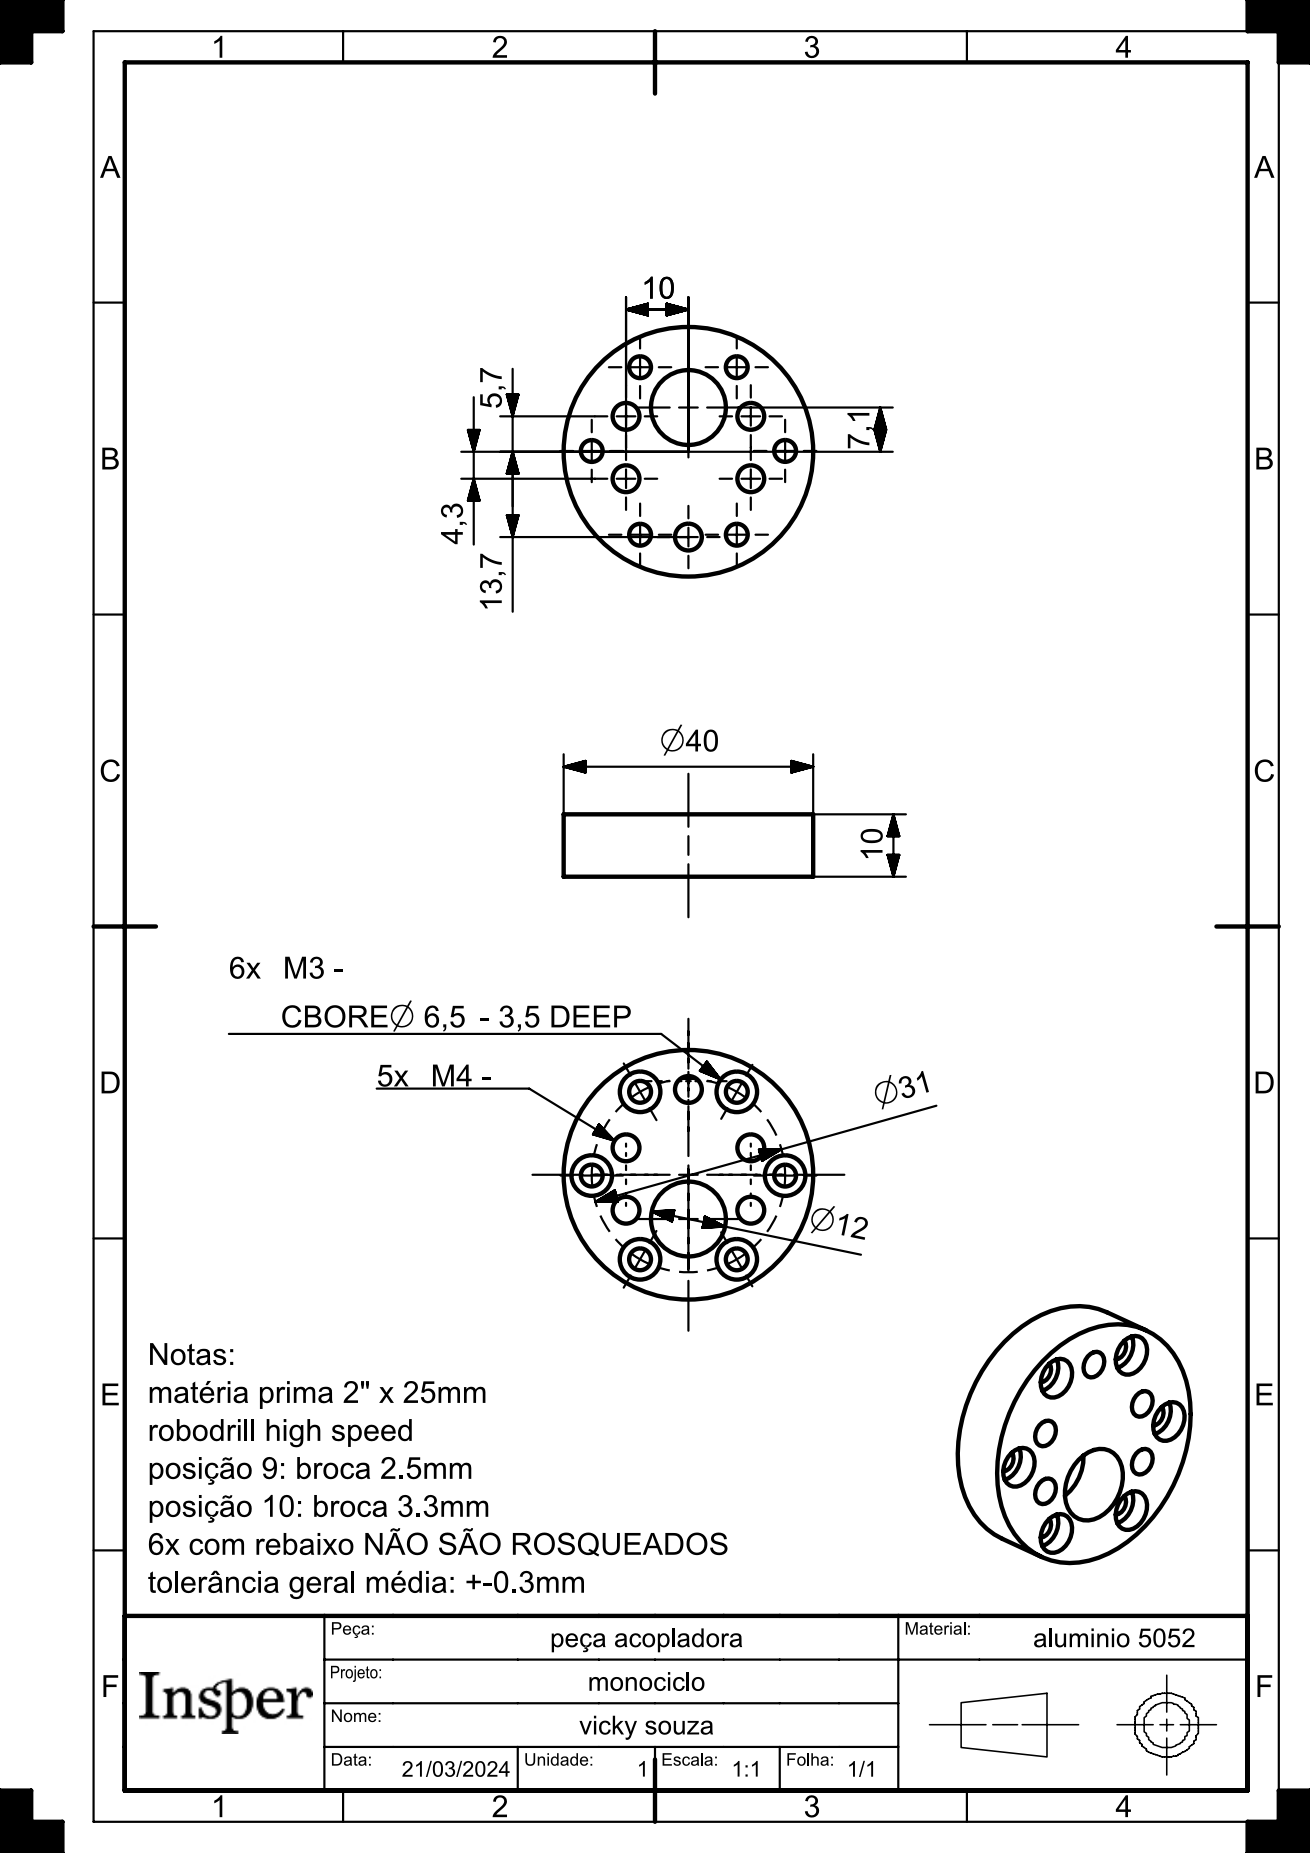
[picture p138: page 1]
