sharpiestealr/mono/cad/eixo v1.pdf

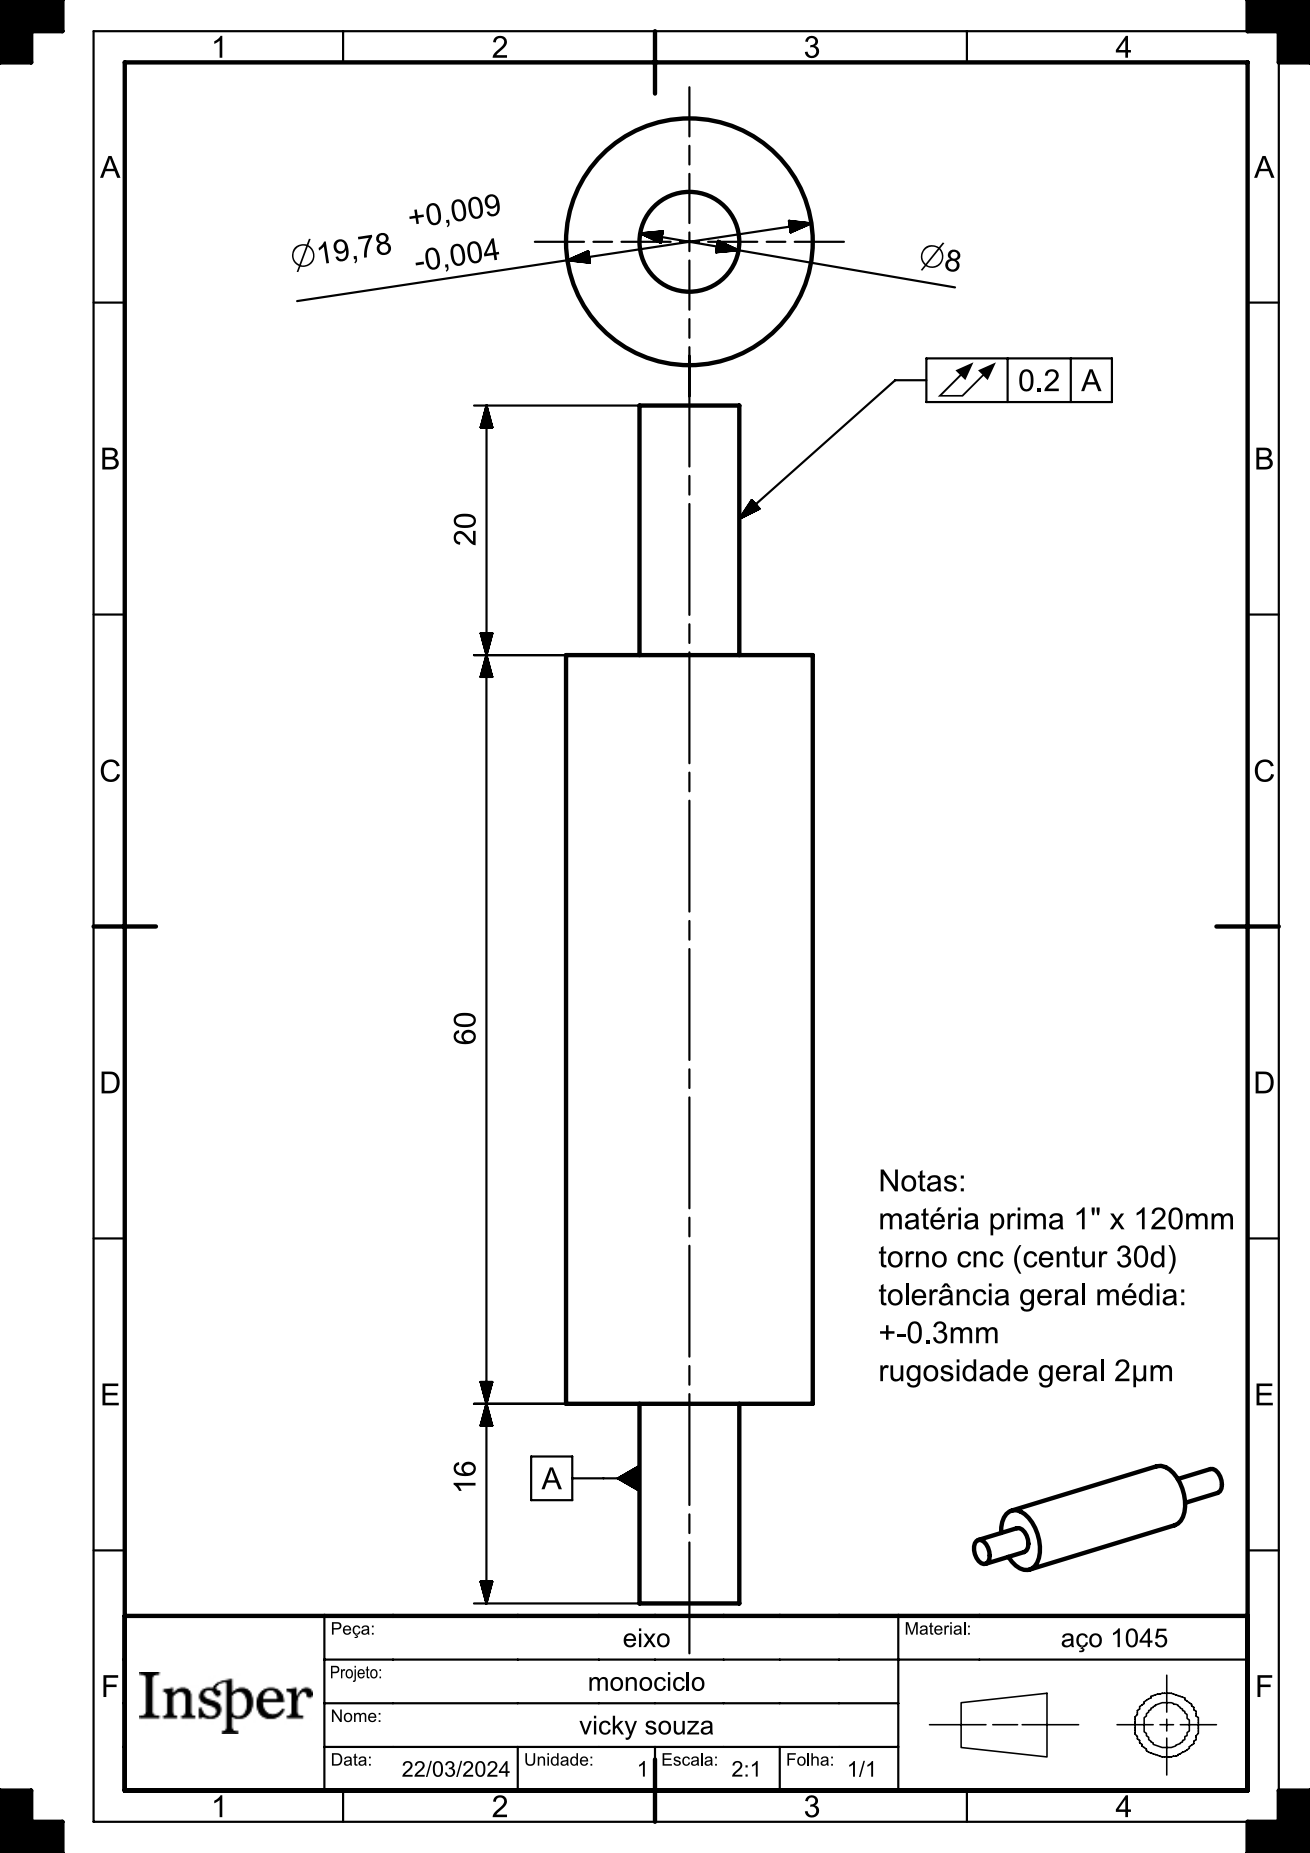
[picture p139: page 1]
