sharpiestealr/mono/cad/eixo v2.pdf

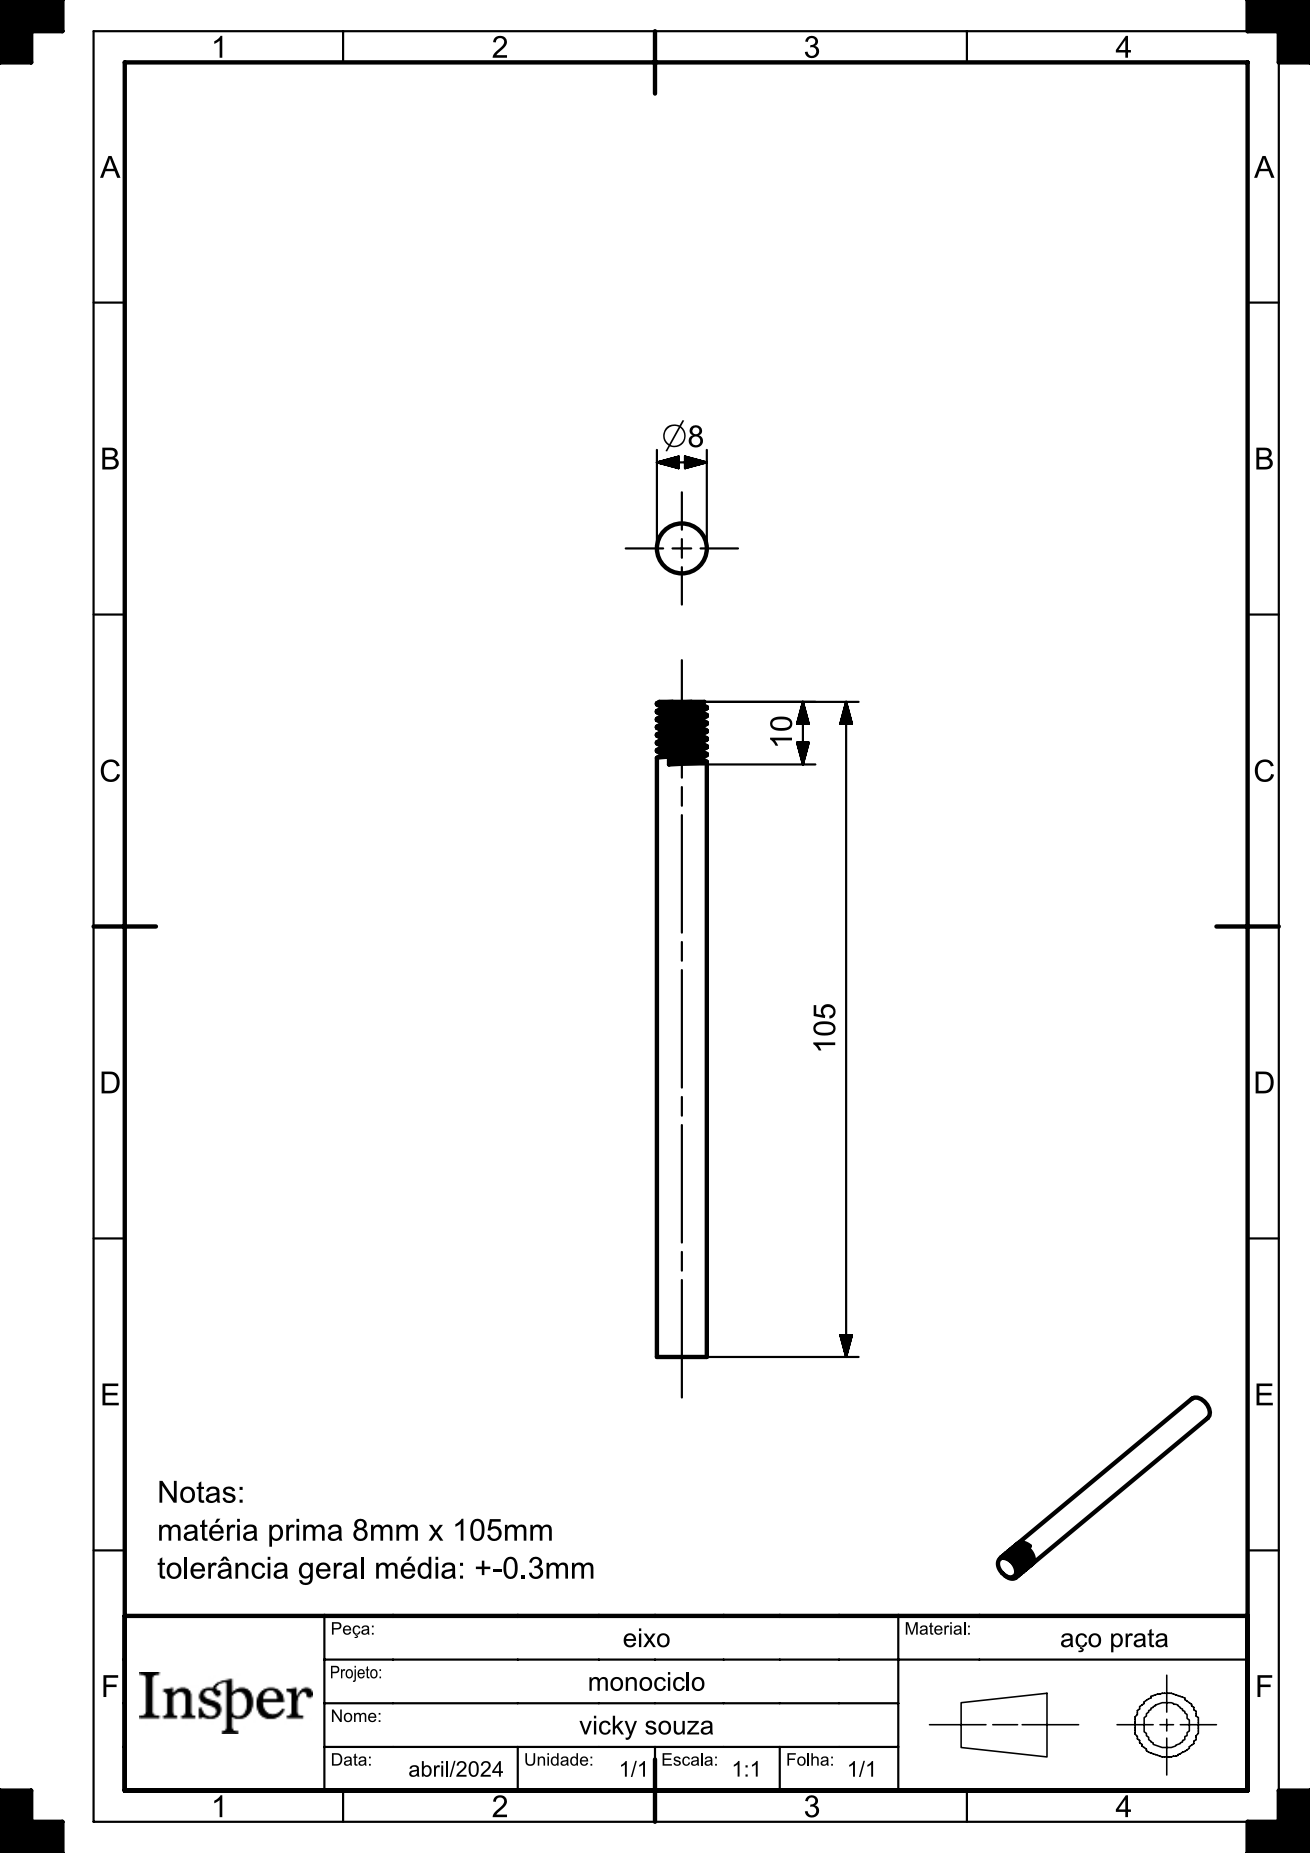
[picture p140: page 1]
