sharpiestealr/mono/(commit log)

2023-07-07 chaaaaaaaaaaama no probleminha
    eu esqueci de botar apenas uma das coisas mais importantes rs
2023-07-07 housekeeping?
    esqueci de arrancar uns arquivos que eu n uso mais rs
2023-07-14 ª
    agr tem um guia de quais arquivos são importantes fora o .prj
2023-08-02 tutorial: completo! como brincar de lqr
2023-08-16 apparently a lot has changed lmao
    idk i haven't opened git desktop since i figured out how to commit from matlab
    [corpo.prt, eixo_W.prt, mono.prt, motor_R.prt, roda de inercia.prt, roda.prt]
2023-09-13 thoroughly modern millie approach
    i swear i tried to do it but it`s not working out
2023-09-25 did i really alter anything bc matlab says i have 27 modified files but idr
    [corpo.prt, eixo_W.prt, mono.prt, motor_R.prt, roda de inercia.prt, roda.prt]
2023-11-14 fixed gab's wild mistake
    [corpo.prt, mono.prt, motor_R.prt, roda de inercia.prt, roda.prt]
2023-11-28 a lot happened today tbh
    [corpo.prt, eixo_W.prt, mono.prt, motor_R.prt, roda de inercia.prt, roda.prt]
2024-02-27 literally the WORST at housekeeping
    but hey it's in the end stages now :)
    [c-hub.prt, corpo.prt, corpo_1285.prt, dhub.prt, eixo.prt, eixo_W.prt, mancal.prt, mono.igs]
2024-03-15 updating the thing
    [37d-gearmotor-100-131-150-encoder.step, 37d-gearmotor-100-131-150.step, 37d-gearmotor-100-131-150_step.prt, 37d-gearmotor-19-30-encoder.step, 37d-gearmotor-19-30.step, 37d-gearmotor-50-70-encoder.step, 37d-gearmotor-50-70.step, 37d-gearmotor-6-10-encoder.step]
2024-05-10 housekeeping :)
    botar uma ordem nessa desgraça né
    [37d-gearmotor-100-131-150_step.prt, biblically accurate monociclo.prt, bucha v2.prt, bucha.prt, c-hub.prt, corpo.prt, eixo v2.prt, eixo.prt]
2024-07-15 call me adderall the way i'm adding all this shit
    [acoplamento.prt, biblically accurate monociclo.prt, corpo but on a plane.dxf, corpo but on a plane.prt, corpo nyoom.prt, corpo.dxf, corpo.prt, corpo.stp]
